AntonyC03S/NASA_RASC-AL/Collection Rover/Sample Handling Subsystem/Sample Handling Arm.SLDASM

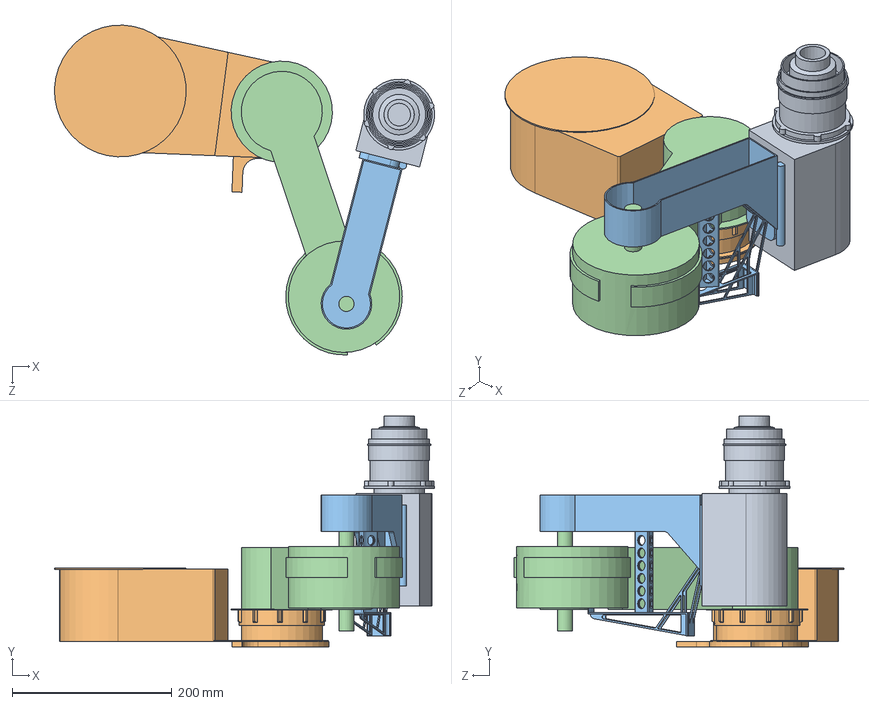
[picture p1: CAD file, 2026-02-23]
Collection Rover/Sample Handling Subsystem/Sample Handling Arm.SLDASM
476.2 x 288.9 x 413.1 mm
Segment 1
Segment 2
Vertical Segment
End Effector
