AntonyC03S/NASA_RASC-AL/Storage Rover/Arms/Arms.SLDASM

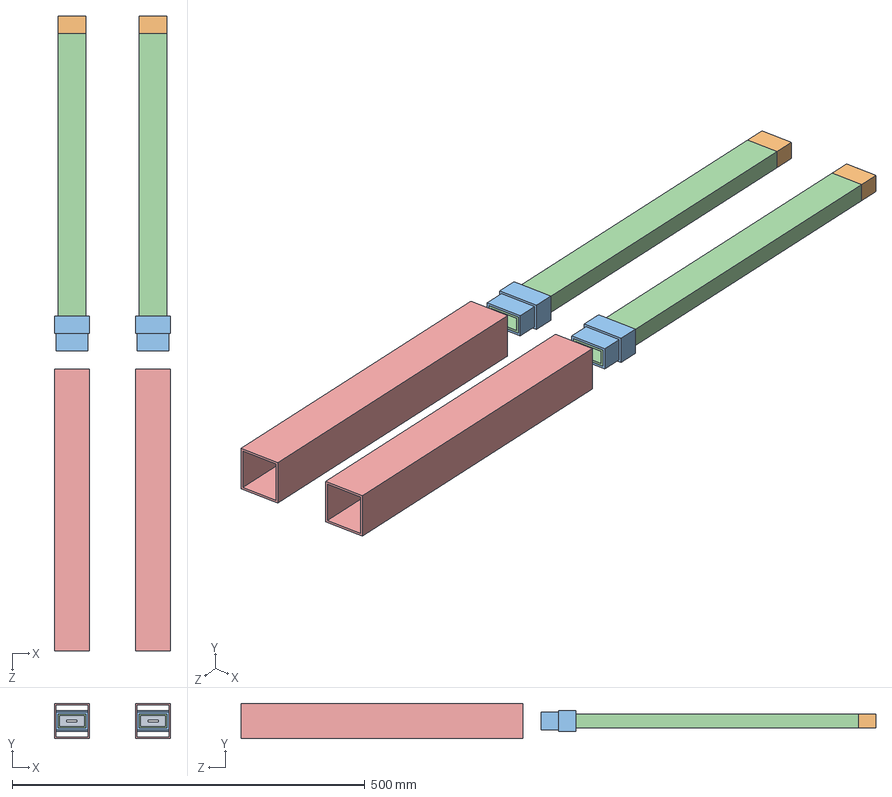
[picture p2: CAD file, 2026-02-23]
Storage Rover/Arms/Arms.SLDASM
165.0 x 50.0 x 900.0 mm
1st Arm x 2
2nd Arm x 2
1st Top Bearing x 2
2nd Top Bearing x 2
3rd Top Bearing x 2
