AntonyC03S/NASA_RASC-AL/TransferMechansimDemo/TransferMechanism.SLDASM

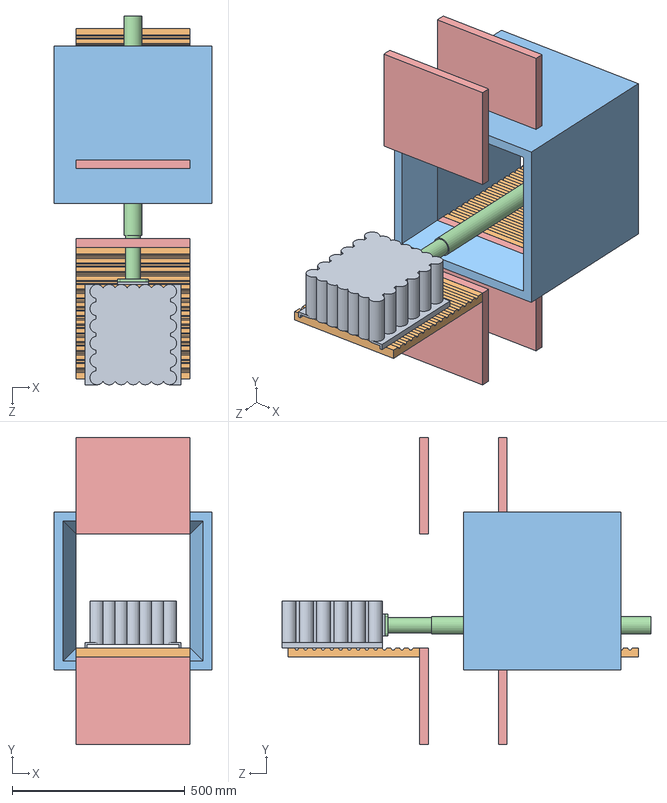
[picture p3: CAD file, 2026-02-23]
TransferMechansimDemo/TransferMechanism.SLDASM
457.2 x 889.3 x 1068.2 mm
Door x 4
LinearActuator
ReceivingEnd
Tray Flooring x 2
BottomloadedTray
