AntonyC03S/NASA_RASC-AL/Storage Rover/StorageRoverAssem.SLDASM

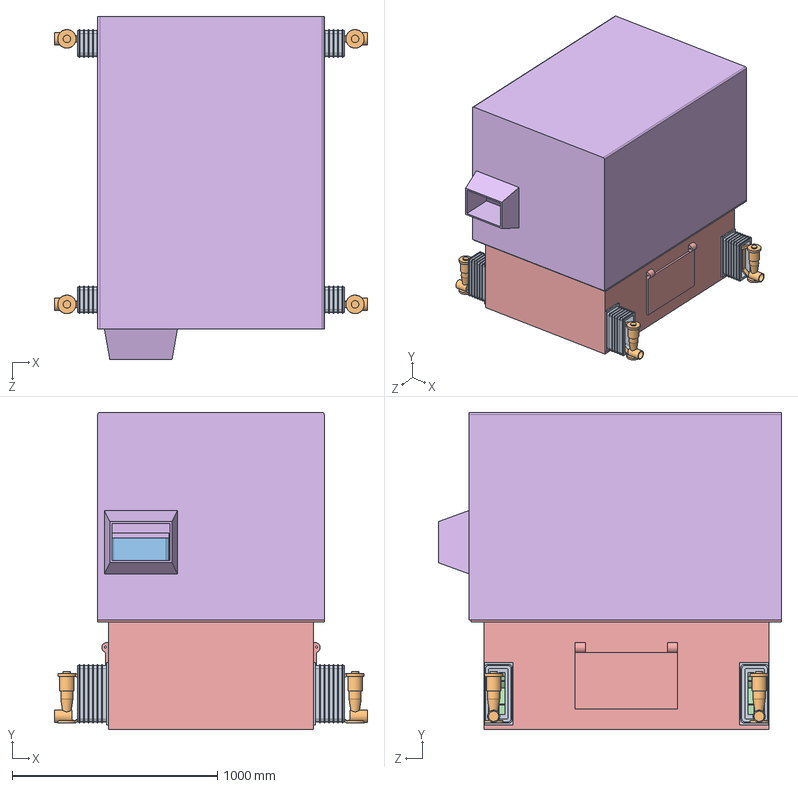
[picture p4: CAD file, 2026-02-05]
Storage Rover/StorageRoverAssem.SLDASM
1526.7 x 1547.0 x 1675.0 mm
StorageRoverBody
ElectronicBlackBox
MMRTG
SampleTray x 18
WheelConnection x 4
SuspensionSleeve x 4
