AntonyC03S/NASA_RASC-AL/Storage Rover/Storage Subsystem/BottomloadedTray.SLDPRT

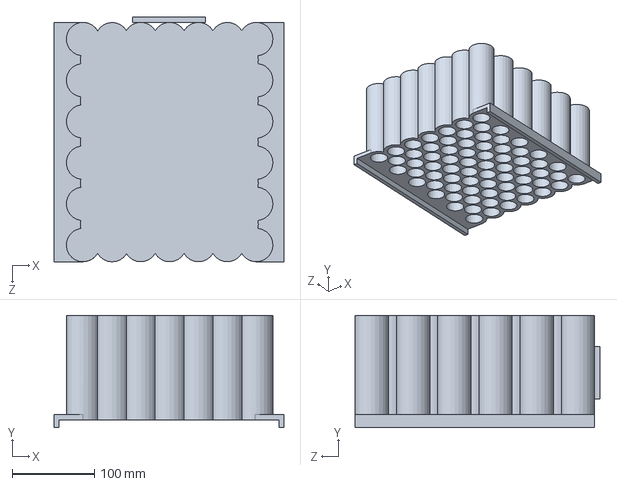
[picture p5: CAD file, 2026-02-10]
Storage Rover/Storage Subsystem/BottomloadedTray.SLDPRT
279.4 x 136.5 x 297.3 mm
