AntonyC03S/NASA_RASC-AL/Storage Rover/StorageRoverBody.SLDPRT

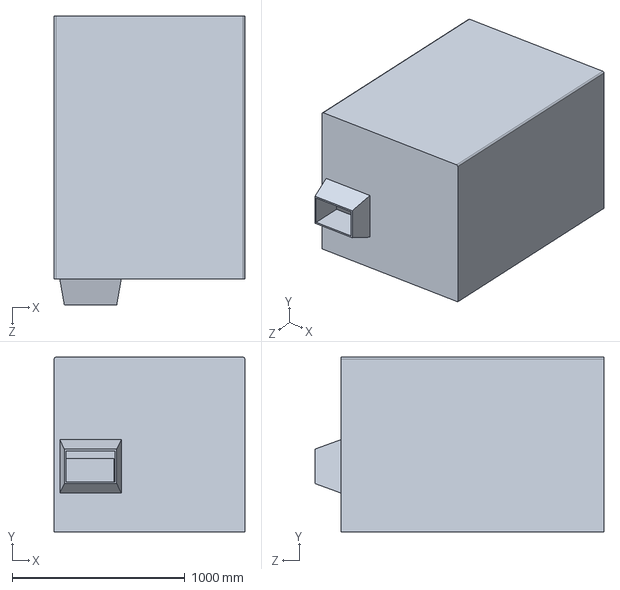
[picture p6: CAD file, 2026-02-23]
Storage Rover/StorageRoverBody.SLDPRT
1105.0 x 1012.5 x 1675.0 mm
