AntonyC03S/NASA_RASC-AL/VP Collection Rover/Stage Telescopic clamp.SLDPRT

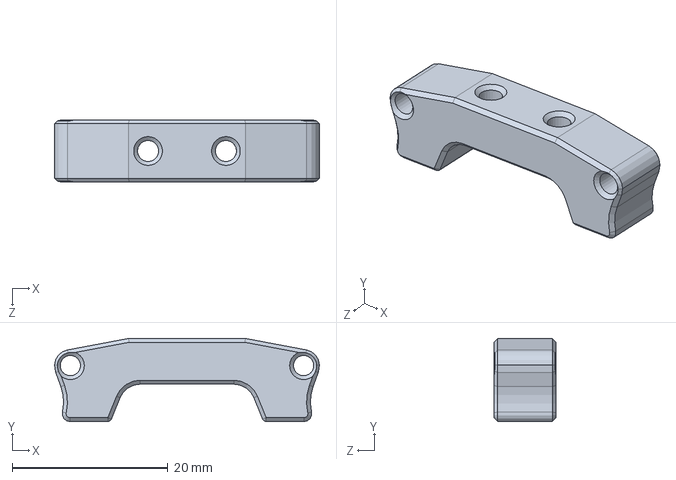
[picture p7: CAD file, 2026-05-27]
VP Collection Rover/Stage Telescopic clamp.SLDPRT
34.0 x 10.7 x 8.00 mm
