AntonyC03S/NASA_RASC-AL/Collection Rover/Drill Subsystem/DrillArm.SLDPRT

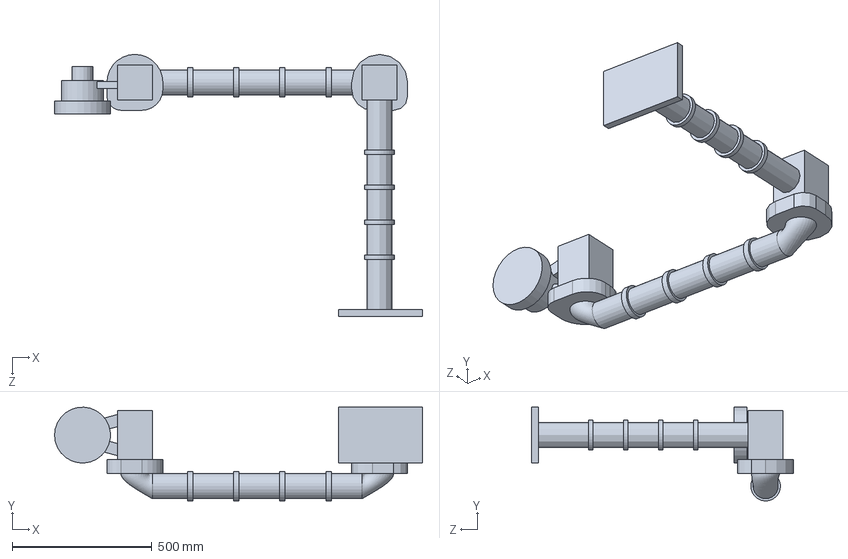
[picture p8: CAD file, 2026-02-10]
Collection Rover/Drill Subsystem/DrillArm.SLDPRT
1315.7 x 335.2 x 937.5 mm
