AntonyC03S/NASA_RASC-AL/Collection Rover/Rover body.SLDPRT

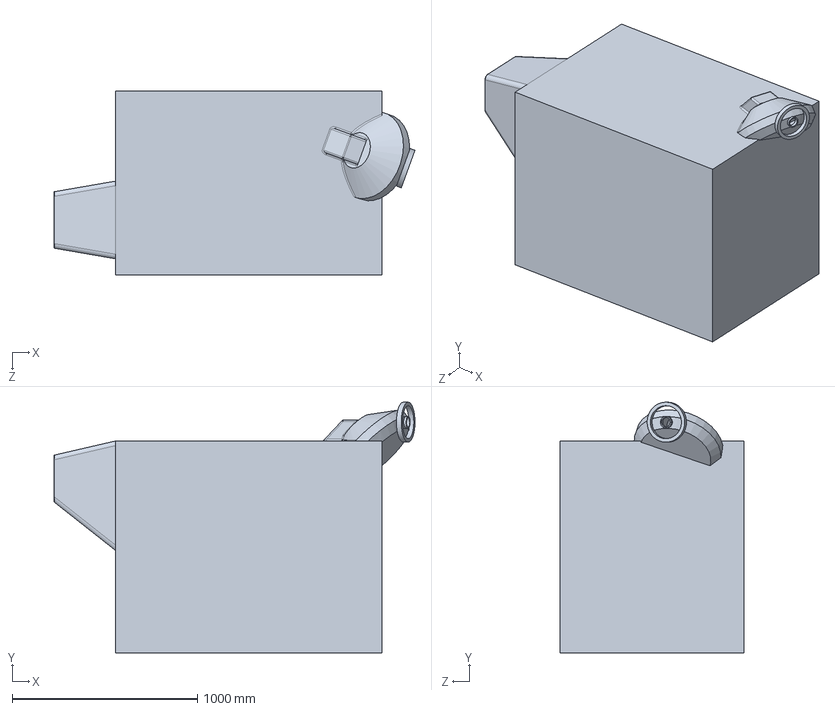
[picture p9: CAD file, 2026-02-23]
Collection Rover/Rover body.SLDPRT
1947.9 x 1352.6 x 990.6 mm
