AntonyC03S/NASA_RASC-AL/Collection Rover/Sample Handling Subsystem/Vertical Segment.SLDPRT

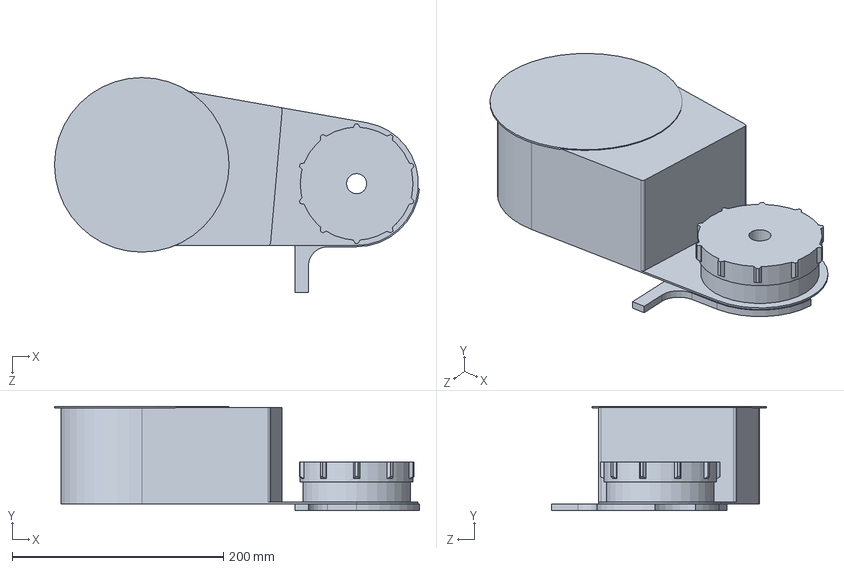
[picture p10: CAD file, 2026-02-10]
Collection Rover/Sample Handling Subsystem/Vertical Segment.SLDPRT
345.2 x 98.4 x 203.2 mm
