AntonyC03S/NASA_RASC-AL/Storage Rover/Arms/3rd Top Bearing.SLDPRT

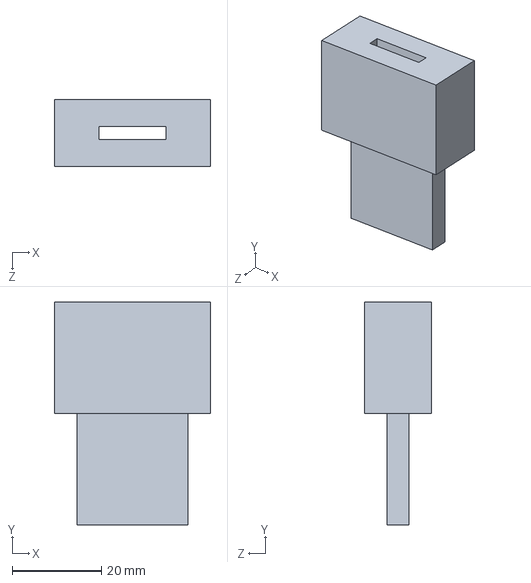
[picture p11: CAD file, 2026-02-23]
Storage Rover/Arms/3rd Top Bearing.SLDPRT
35.0 x 50.0 x 15.0 mm
