AntonyC03S/NASA_RASC-AL/Storage Rover/Elevator/MirrorCage.SLDPRT

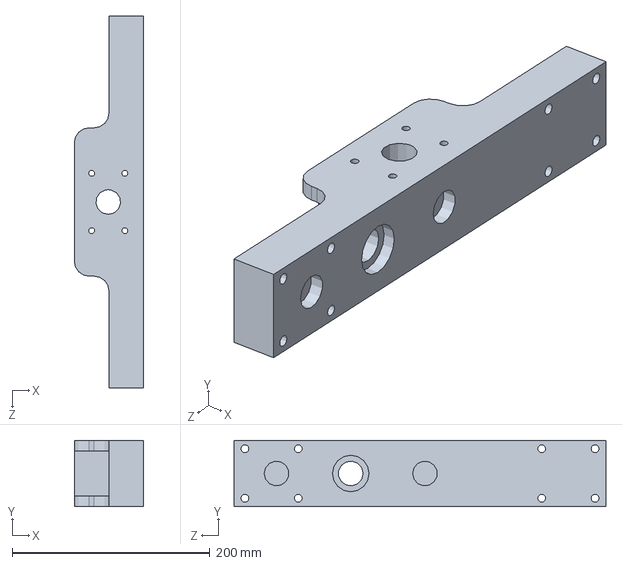
[picture p12: CAD file, 2026-02-05]
Storage Rover/Elevator/MirrorCage.SLDPRT
70.0 x 67.0 x 376.0 mm
