AntonyC03S/NASA_RASC-AL/Storage Rover/Storage Subsystem/SampleTray.SLDPRT

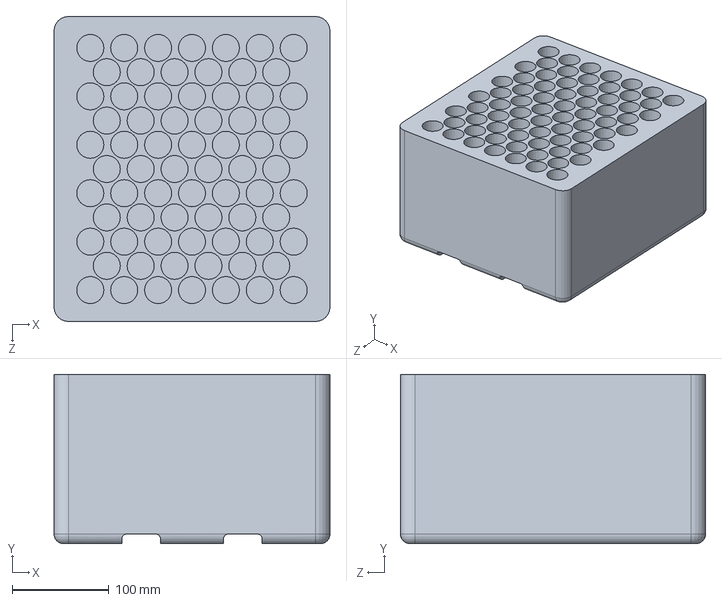
[picture p13: CAD file, 2026-01-30]
Storage Rover/Storage Subsystem/SampleTray.SLDPRT
285.0 x 175.0 x 315.0 mm
