AntonyC03S/NASA_RASC-AL/Storage Rover/ThermalInsulation.SLDPRT

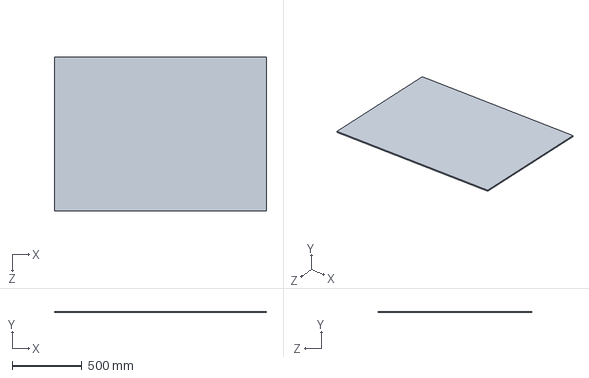
[picture p14: CAD file, 2026-02-10]
Storage Rover/ThermalInsulation.SLDPRT
1525.0 x 10.0 x 1105.0 mm
