AntonyC03S/NASA_RASC-AL/TransferMechansimDemo/LinearActuator.SLDPRT

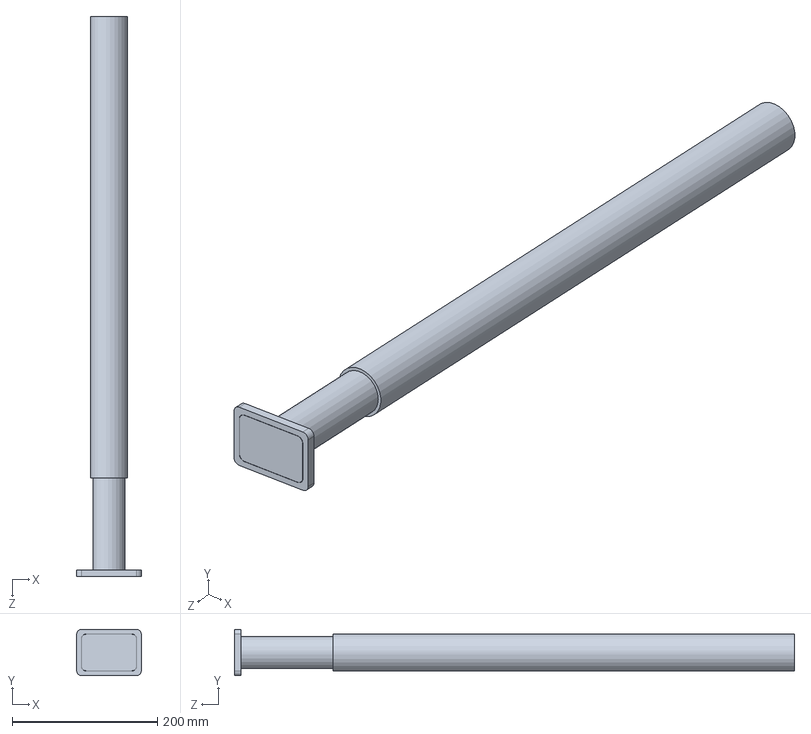
[picture p15: CAD file, 2026-02-23]
TransferMechansimDemo/LinearActuator.SLDPRT
88.9 x 63.5 x 770.9 mm
