AntonyC03S/NASA_RASC-AL/Collection Rover/Drill Subsystem/Drill Head.SLDPRT

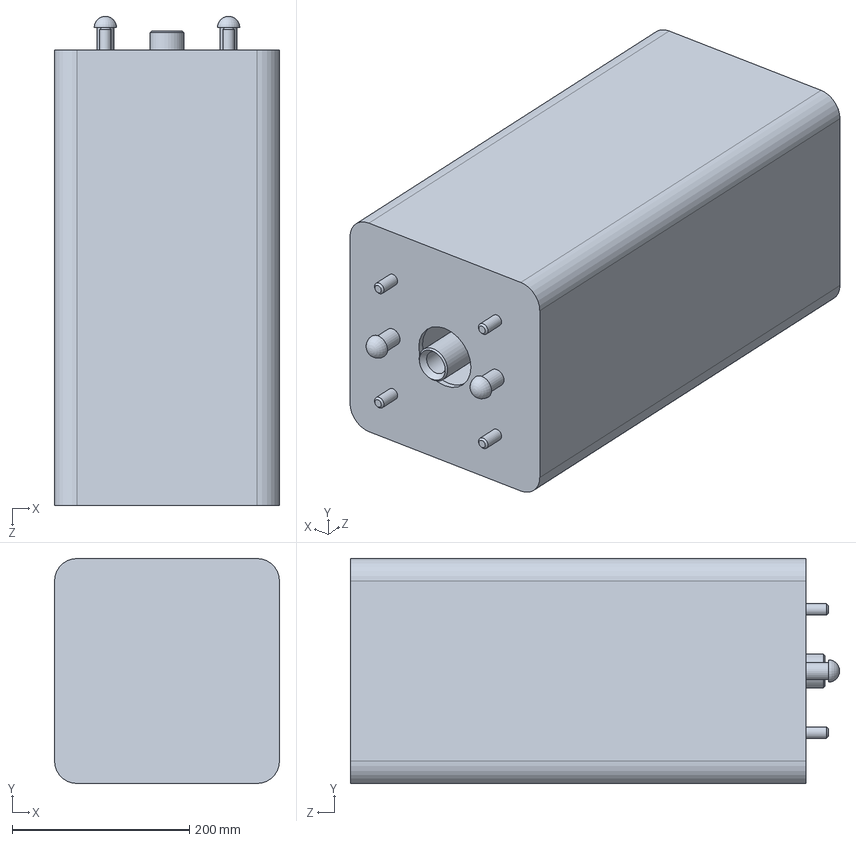
[picture p16: CAD file, 2026-02-10]
Collection Rover/Drill Subsystem/Drill Head.SLDPRT
254.0 x 254.0 x 552.5 mm
