AntonyC03S/NASA_RASC-AL/Collection Rover/MMRTG.SLDPRT

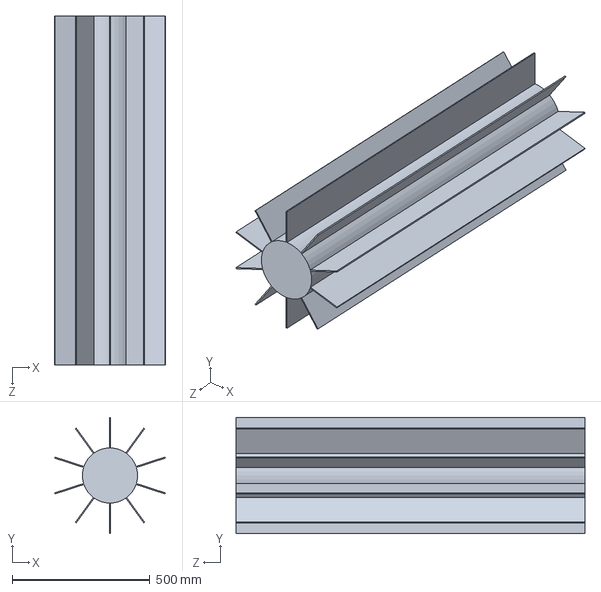
[picture p17: CAD file, 2026-02-10]
Collection Rover/MMRTG.SLDPRT
402.6 x 422.0 x 1265.0 mm
