AntonyC03S/NASA_RASC-AL/Collection Rover/Sample Handling Subsystem/End Effector.SLDPRT

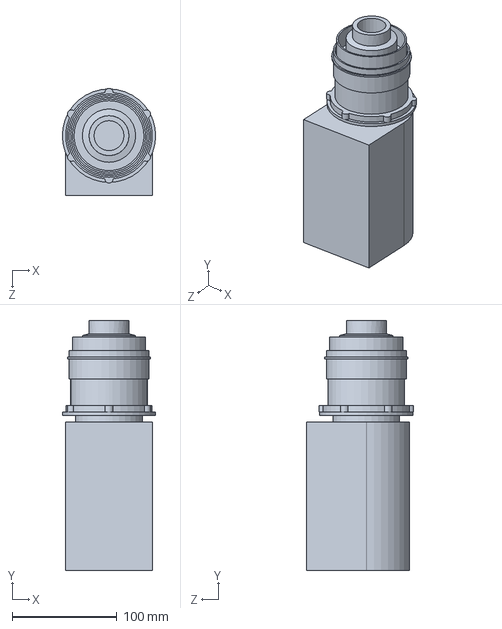
[picture p18: CAD file, 2026-02-10]
Collection Rover/Sample Handling Subsystem/End Effector.SLDPRT
88.9 x 238.1 x 102.2 mm
