AntonyC03S/NASA_RASC-AL/Storage Rover/Arms/1st Top Bearing.SLDPRT

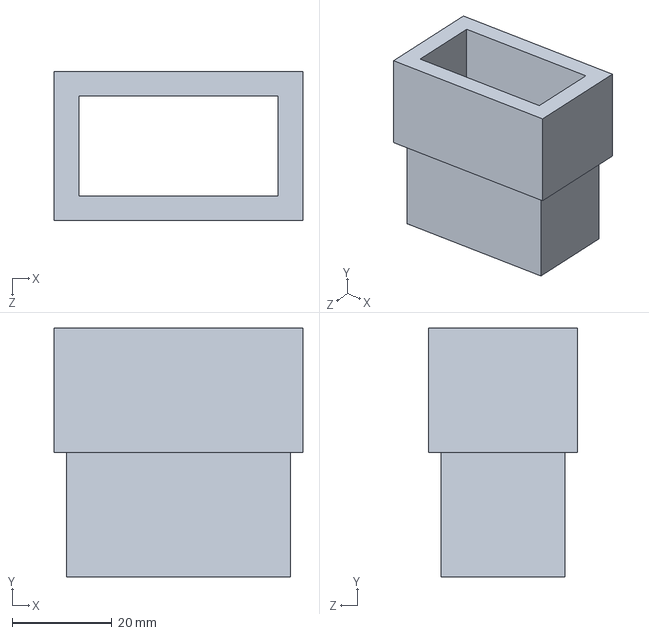
[picture p19: CAD file, 2026-02-23]
Storage Rover/Arms/1st Top Bearing.SLDPRT
50.0 x 50.0 x 30.0 mm
