AntonyC03S/NASA_RASC-AL/Storage Rover/ElectronicBlackBox.SLDPRT

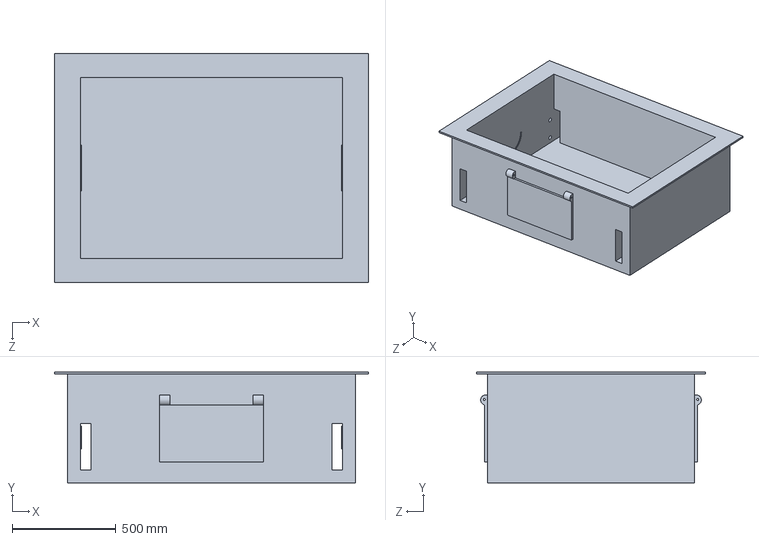
[picture p20: CAD file, 2026-02-10]
Storage Rover/ElectronicBlackBox.SLDPRT
1515.0 x 534.5 x 1105.0 mm
