AntonyC03S/NASA_RASC-AL/Storage Rover/Elevator/Mid_Cage.SLDPRT

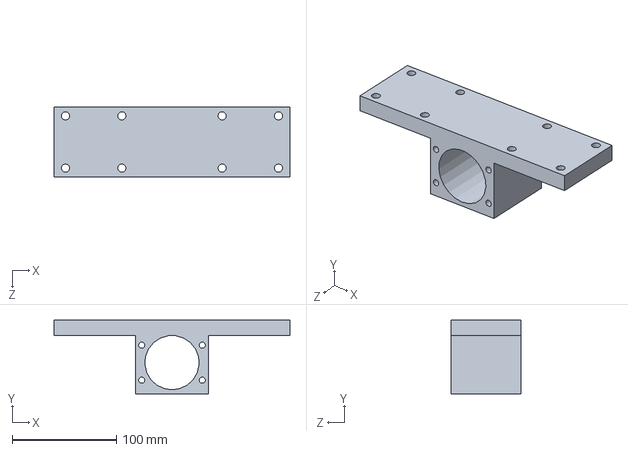
[picture p21: CAD file, 2026-02-02]
Storage Rover/Elevator/Mid_Cage.SLDPRT
226.0 x 70.8 x 67.0 mm
