AntonyC03S/NASA_RASC-AL/Storage Rover/Storage Subsystem/SampleTube.SLDPRT

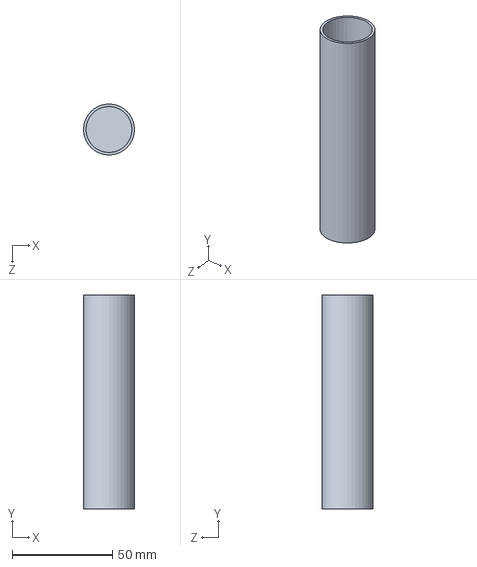
[picture p22: CAD file, 2026-01-29]
Storage Rover/Storage Subsystem/SampleTube.SLDPRT
25.4 x 106.6 x 25.4 mm
