AntonyC03S/NASA_RASC-AL/TransferMechansimDemo/Tray Flooring.SLDPRT

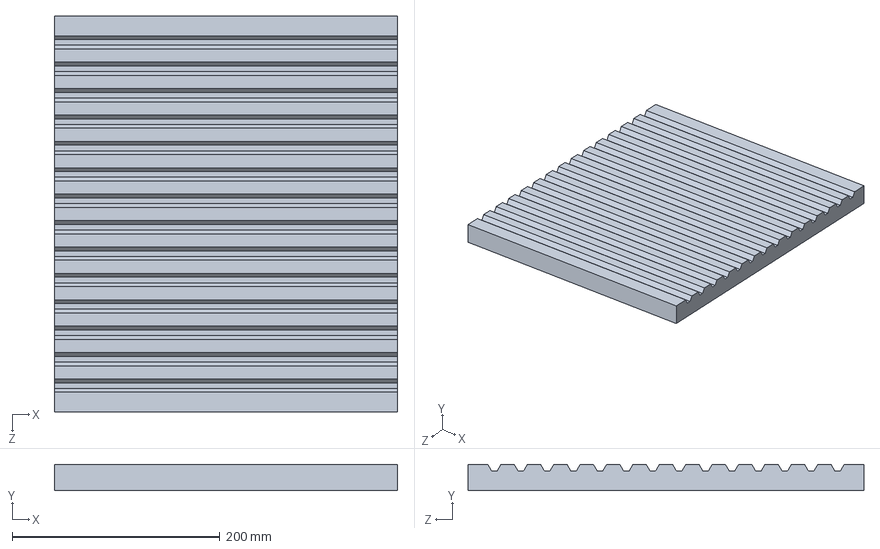
[picture p23: CAD file, 2026-02-23]
TransferMechansimDemo/Tray Flooring.SLDPRT
330.2 x 25.4 x 381.0 mm
