AntonyC03S/NASA_RASC-AL/VP Collection Rover/Stage Telescopic Top back 2.SLDPRT

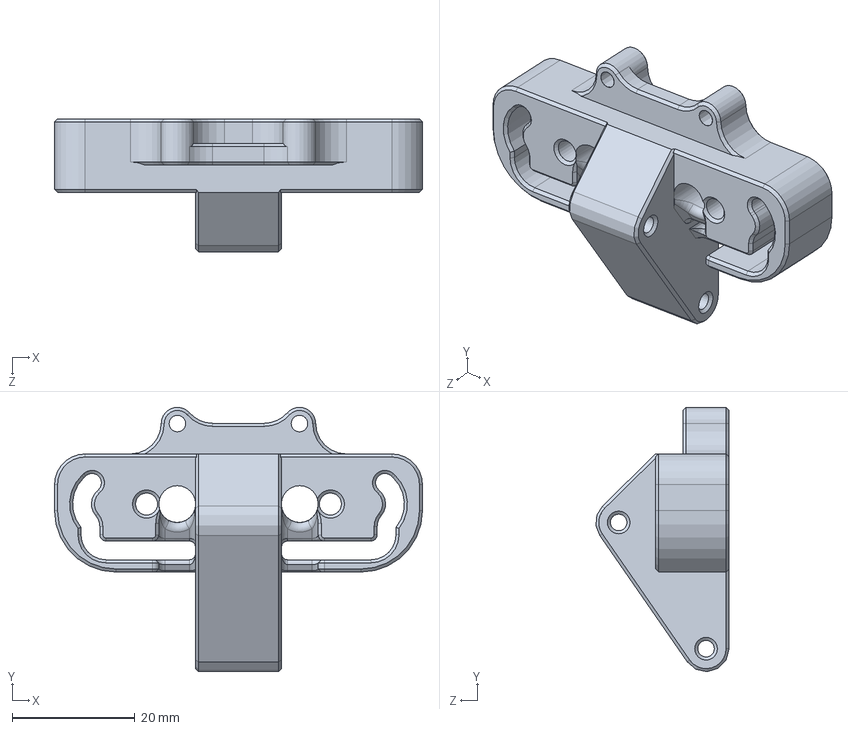
[picture p24: CAD file, 2026-05-27]
VP Collection Rover/Stage Telescopic Top back 2.SLDPRT
60.0 x 43.1 x 21.7 mm
