AntonyC03S/NASA_RASC-AL/Collection Rover/Sample Handling Subsystem/Bit Carousel.SLDPRT

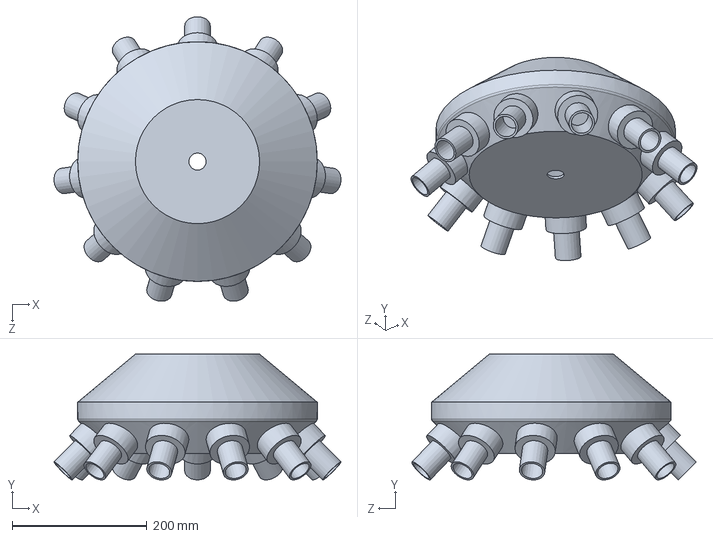
[picture p25: CAD file, 2026-02-10]
Collection Rover/Sample Handling Subsystem/Bit Carousel.SLDPRT
425.9 x 186.8 x 422.2 mm
