AntonyC03S/NASA_RASC-AL/Collection Rover/SuspensionSleeve.SLDPRT

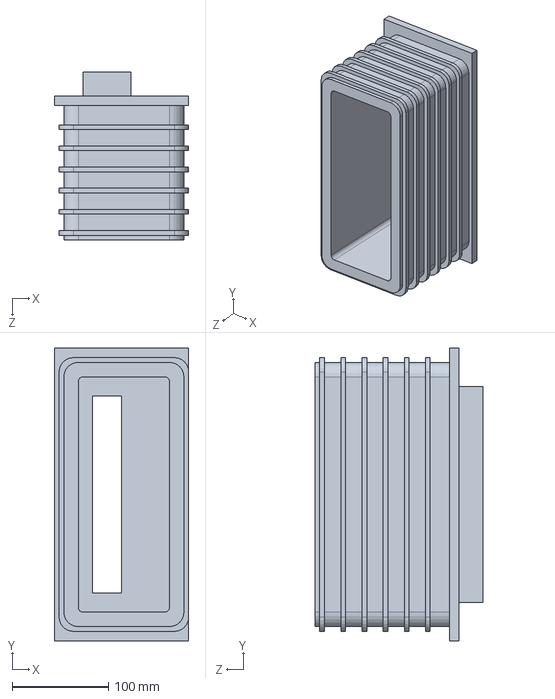
[picture p26: CAD file, 2026-02-10]
Collection Rover/SuspensionSleeve.SLDPRT
140.0 x 305.0 x 175.0 mm
