AntonyC03S/NASA_RASC-AL/Storage Rover/Arms/2nd Arm.SLDPRT

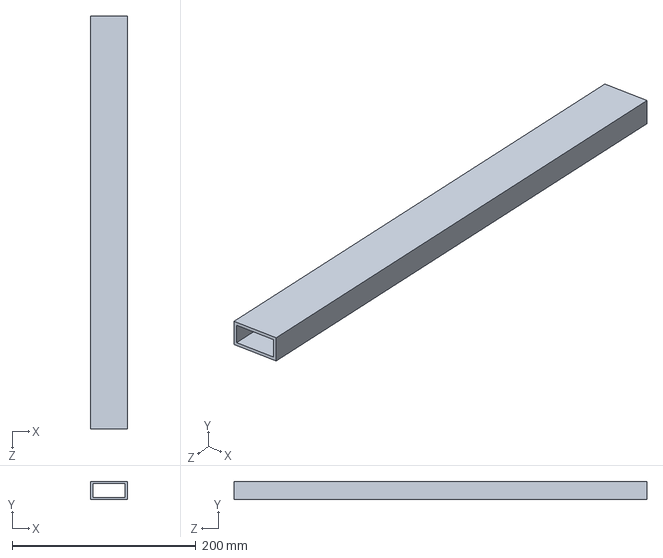
[picture p27: CAD file, 2026-02-23]
Storage Rover/Arms/2nd Arm.SLDPRT
40.0 x 20.0 x 450.0 mm
