AntonyC03S/NASA_RASC-AL/Storage Rover/Elevator/Mid_Rails.SLDPRT

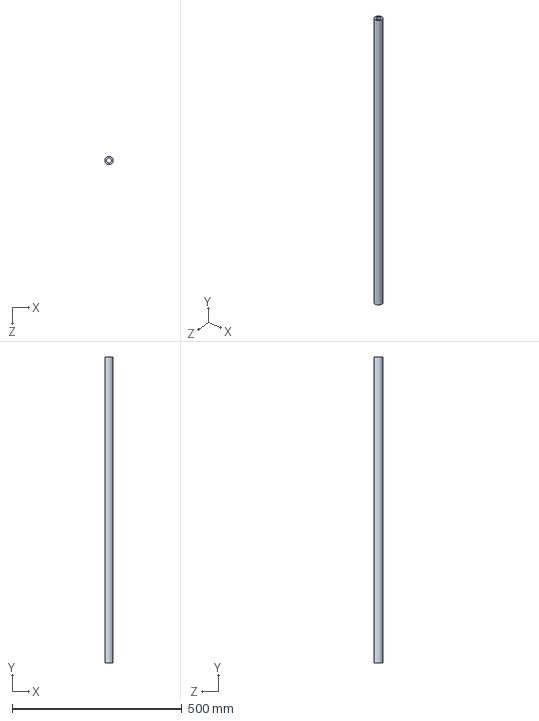
[picture p28: CAD file, 2026-02-02]
Storage Rover/Elevator/Mid_Rails.SLDPRT
24.9 x 900.0 x 25.0 mm
