AntonyC03S/NASA_RASC-AL/Storage Rover/ThermalRadiator.SLDPRT

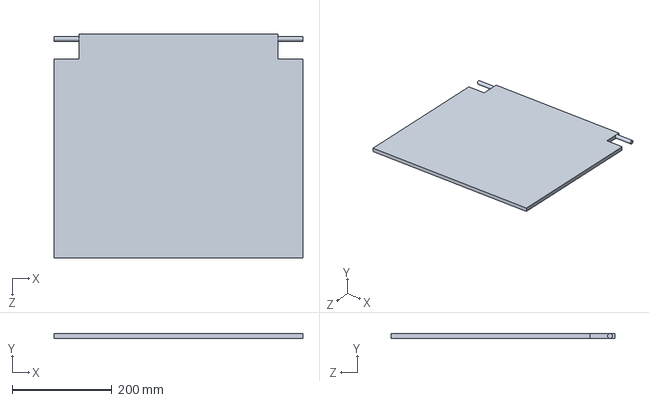
[picture p29: CAD file, 2026-02-10]
Storage Rover/ThermalRadiator.SLDPRT
500.0 x 10.0 x 450.0 mm
