AntonyC03S/NASA_RASC-AL/TransferMechansimDemo/ReceivingEnd.SLDPRT

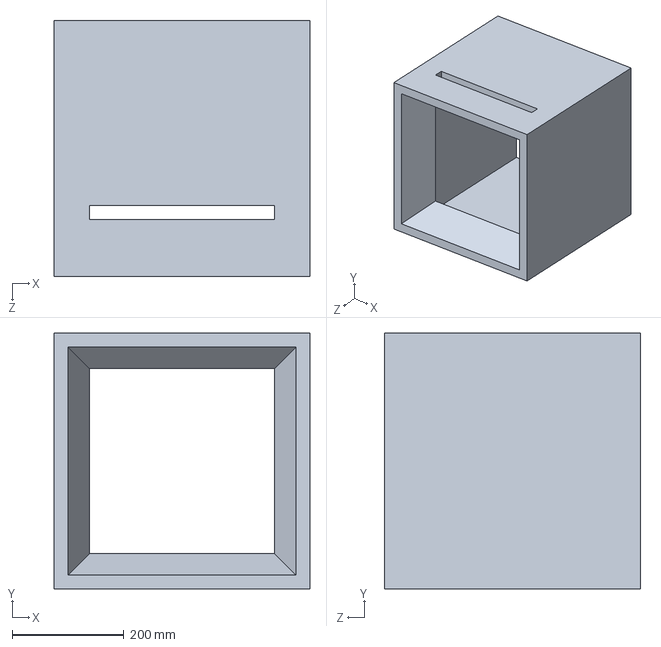
[picture p30: CAD file, 2026-02-23]
TransferMechansimDemo/ReceivingEnd.SLDPRT
457.2 x 457.2 x 457.2 mm
