AntonyC03S/NASA_RASC-AL/VP Collection Rover/Bearing Arm Mount.SLDPRT

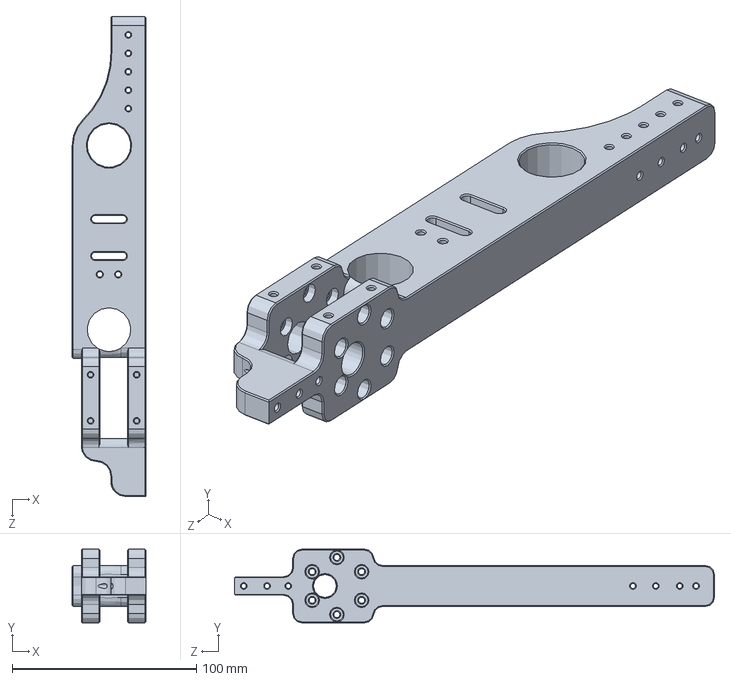
[picture p31: CAD file, 2026-05-27]
VP Collection Rover/Bearing Arm Mount.SLDPRT
40.0 x 40.0 x 260.6 mm
