AntonyC03S/NASA_RASC-AL/Collection Rover/Sample Handling Subsystem/Segment 2.SLDPRT

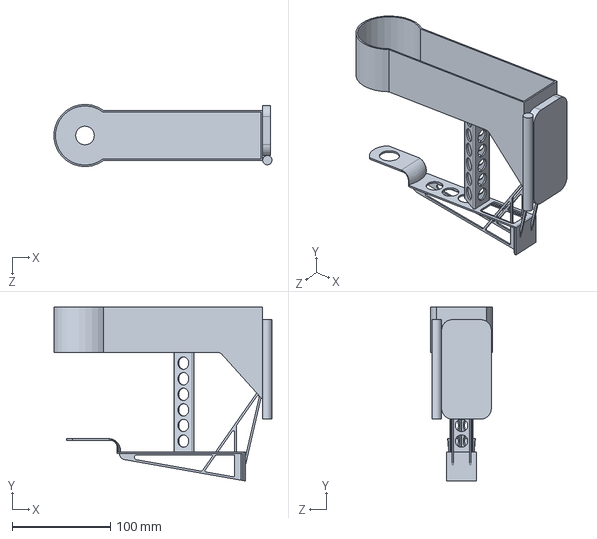
[picture p32: CAD file, 2026-02-09]
Collection Rover/Sample Handling Subsystem/Segment 2.SLDPRT
222.2 x 177.2 x 63.5 mm
