AntonyC03S/NASA_RASC-AL/Collection Rover/WheelConnection.SLDPRT

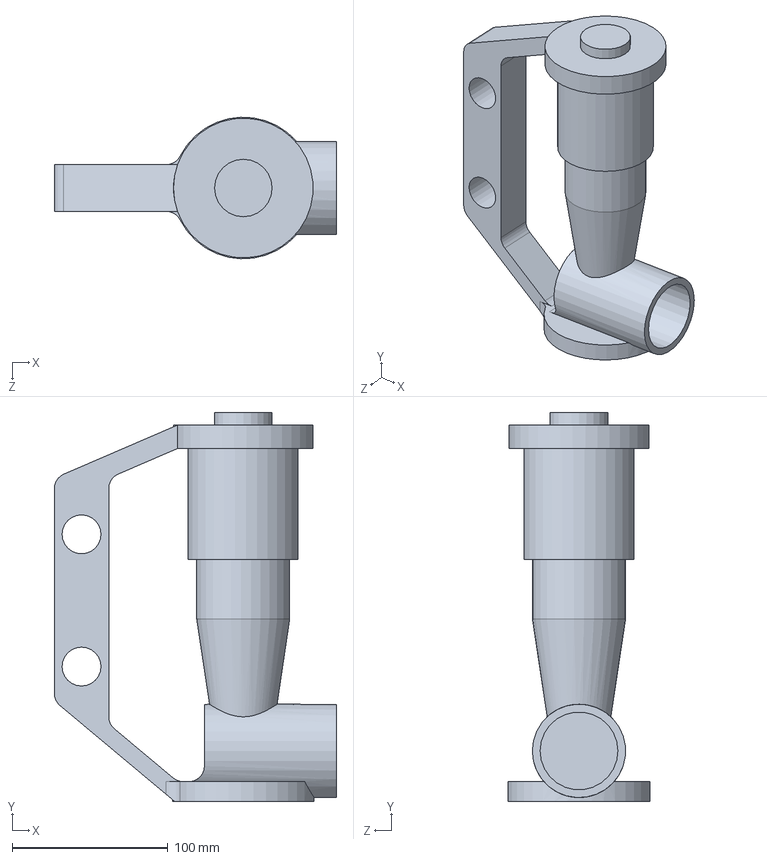
[picture p33: CAD file, 2026-02-10]
Collection Rover/WheelConnection.SLDPRT
181.5 x 250.0 x 91.0 mm
