AntonyC03S/NASA_RASC-AL/Storage Rover/Arms/1st Arm.SLDPRT

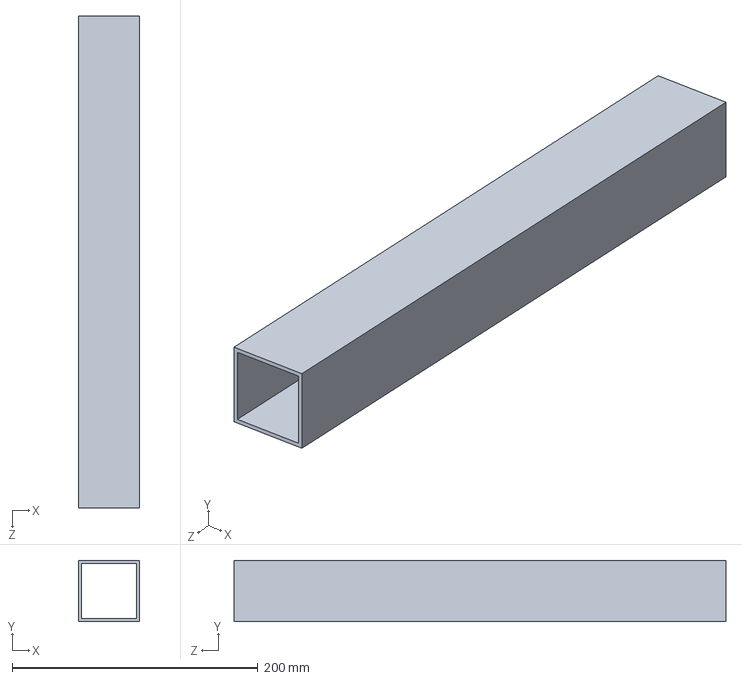
[picture p34: CAD file, 2026-02-23]
Storage Rover/Arms/1st Arm.SLDPRT
50.0 x 50.0 x 400.0 mm
