AntonyC03S/NASA_RASC-AL/Storage Rover/Elevator/Rails.SLDPRT

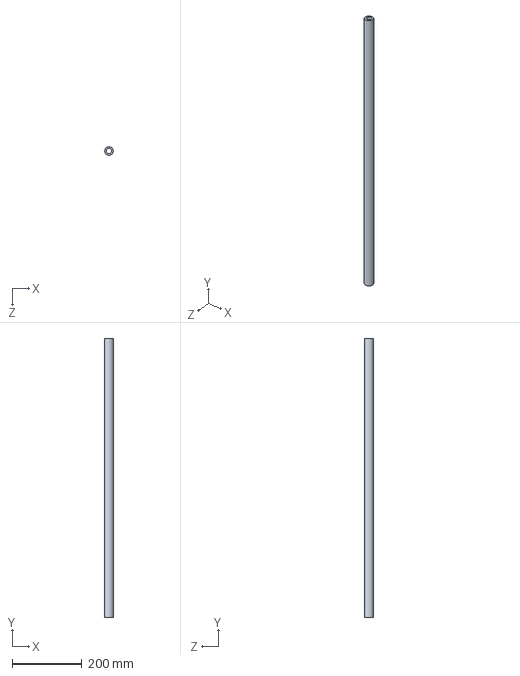
[picture p35: CAD file, 2026-02-02]
Storage Rover/Elevator/Rails.SLDPRT
24.9 x 800.0 x 25.0 mm
