AntonyC03S/NASA_RASC-AL/TransferMechansimDemo/Door.SLDPRT

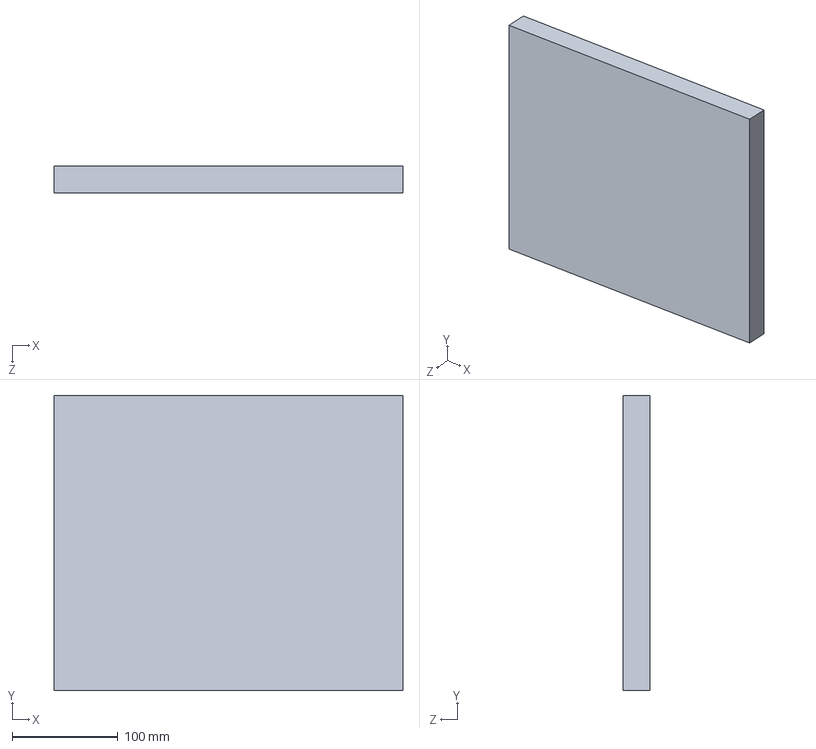
[picture p36: CAD file, 2026-02-23]
TransferMechansimDemo/Door.SLDPRT
330.2 x 279.4 x 25.4 mm
