AntonyC03S/NASA_RASC-AL/VP Collection Rover/String Clamp.SLDPRT

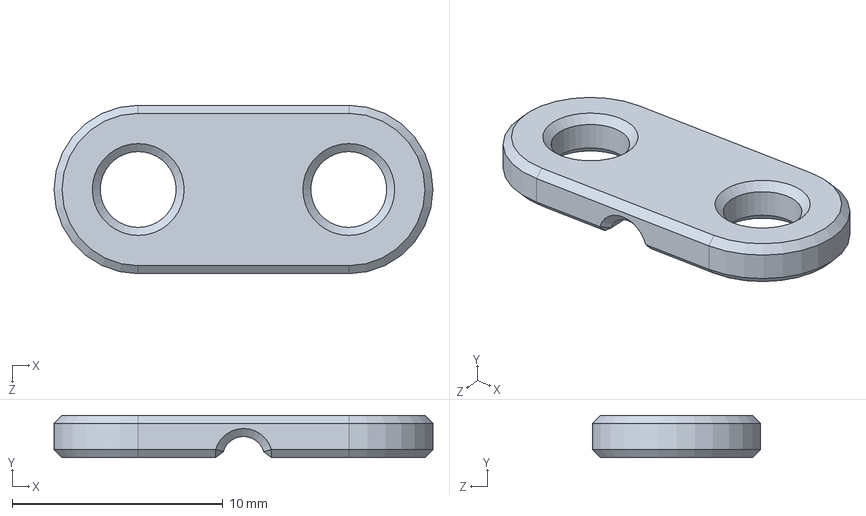
[picture p37: CAD file, 2026-05-27]
VP Collection Rover/String Clamp.SLDPRT
18.0 x 2.00 x 8.00 mm
