AntonyC03S/NASA_RASC-AL/Collection Rover/Sample Handling Subsystem/Segment 1.SLDPRT

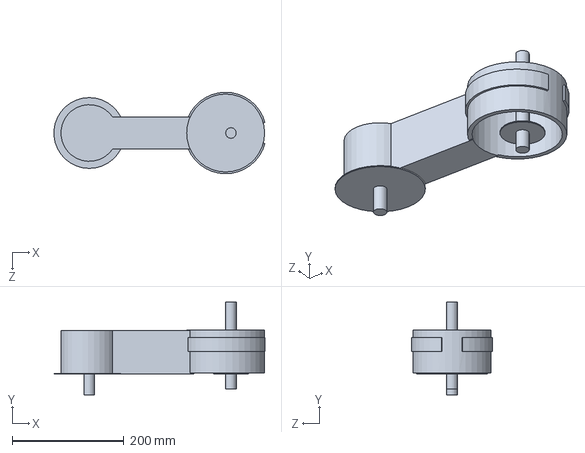
[picture p38: CAD file, 2026-02-05]
Collection Rover/Sample Handling Subsystem/Segment 1.SLDPRT
378.2 x 166.6 x 146.0 mm
