AntonyC03S/NASA_RASC-AL/Storage Rover/Arms/2nd Top Bearing.SLDPRT

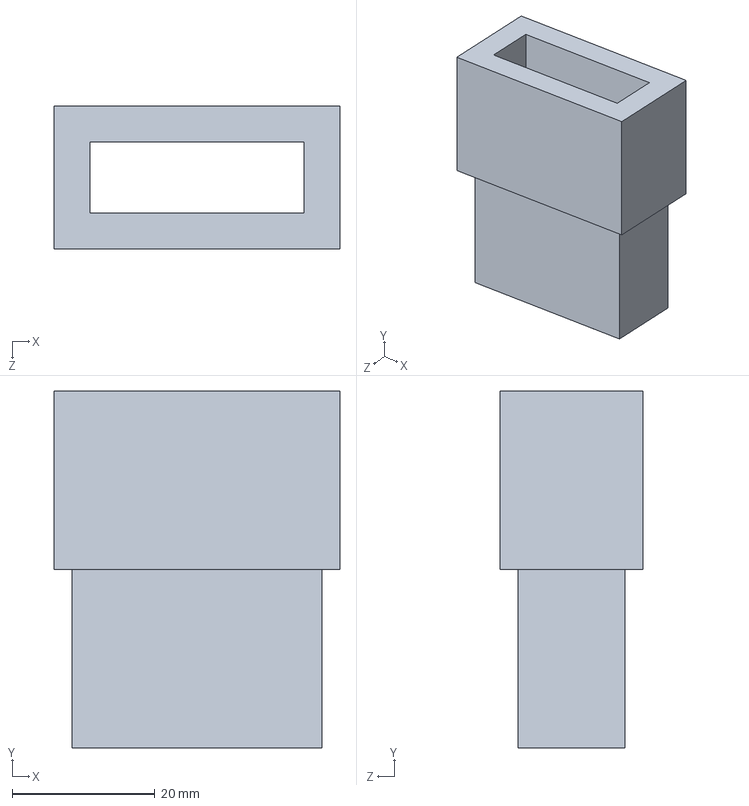
[picture p39: CAD file, 2026-02-23]
Storage Rover/Arms/2nd Top Bearing.SLDPRT
40.0 x 50.0 x 20.0 mm
