AntonyC03S/NASA_RASC-AL/VP Collection Rover/pulley support.SLDPRT

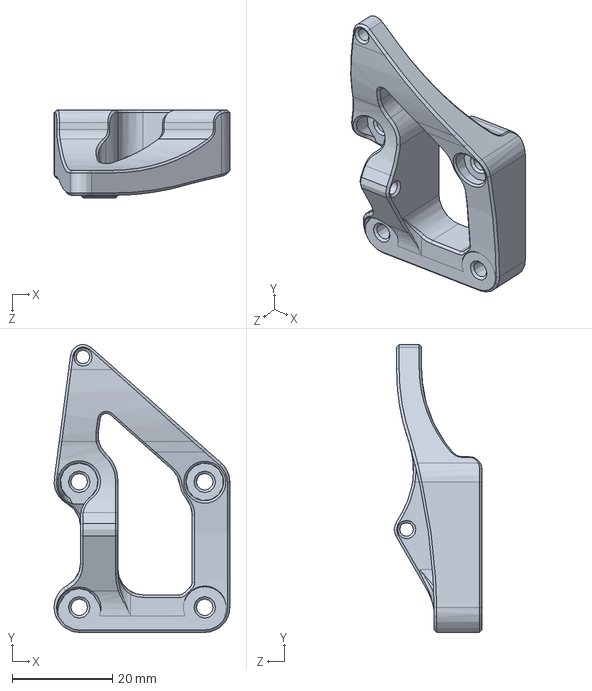
[picture p40: CAD file, 2026-05-27]
VP Collection Rover/pulley support.SLDPRT
35.0 x 57.4 x 17.5 mm
