AntonyC03S/NASA_RASC-AL/Collection Rover/Sample Handling Subsystem/Bearing.SLDPRT

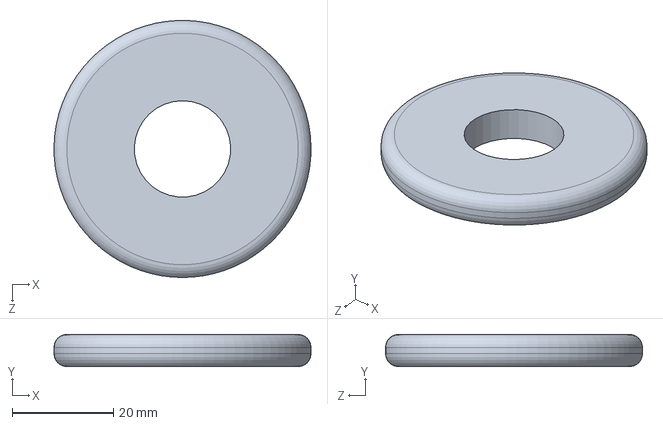
[picture p41: CAD file, 2026-02-02]
Collection Rover/Sample Handling Subsystem/Bearing.SLDPRT
50.8 x 6.35 x 50.8 mm
