AntonyC03S/NASA_RASC-AL/Storage Rover/Arms/1st Bot Bearing.SLDPRT

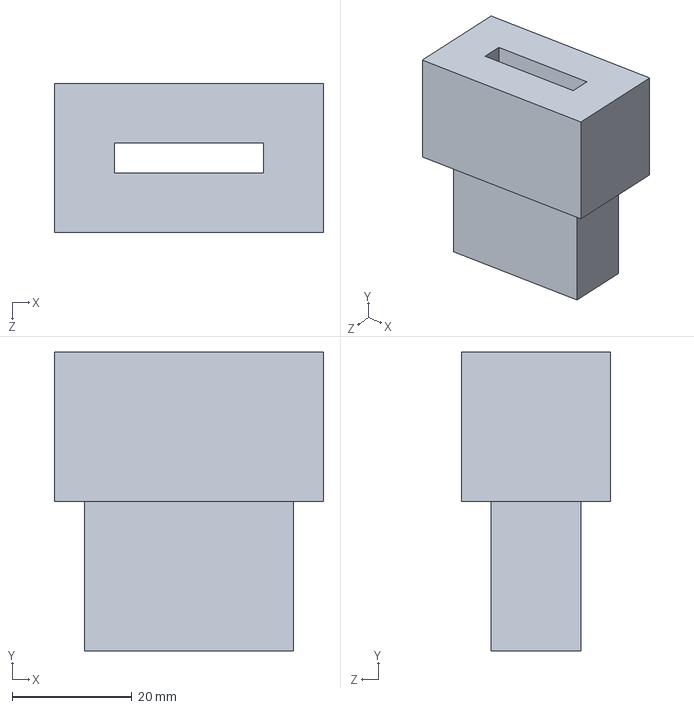
[picture p42: CAD file, 2026-02-23]
Storage Rover/Arms/1st Bot Bearing.SLDPRT
45.0 x 50.0 x 25.0 mm
