AntonyC03S/NASA_RASC-AL/Storage Rover/GarageDoor.SLDPRT

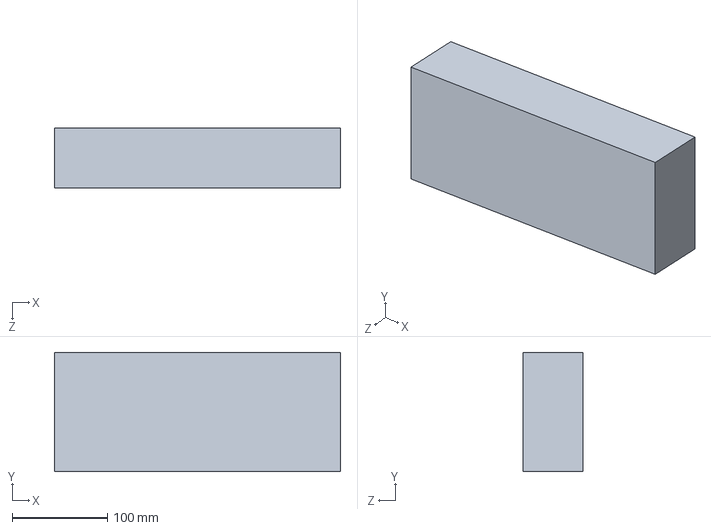
[picture p43: CAD file, 2026-02-04]
Storage Rover/GarageDoor.SLDPRT
300.0 x 125.0 x 62.5 mm
