AntonyC03S/NASA_RASC-AL/TransferMechansimDemo/Giver.SLDPRT

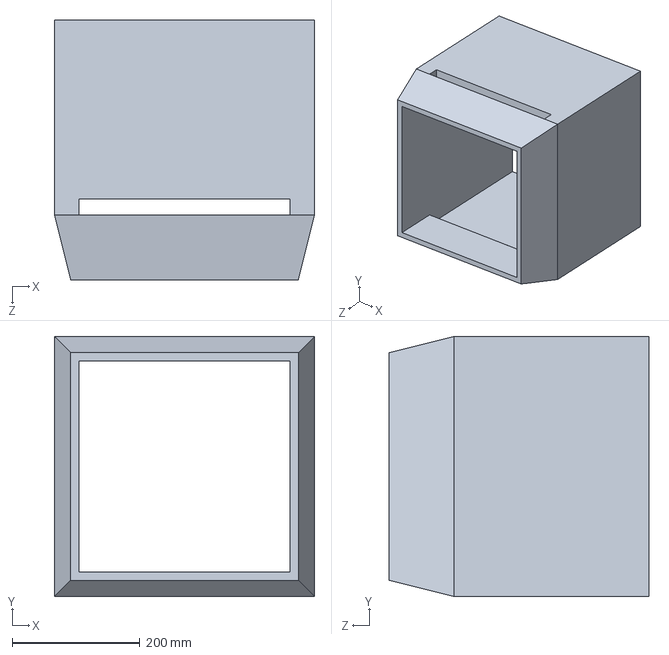
[picture p44: CAD file, 2026-02-23]
TransferMechansimDemo/Giver.SLDPRT
406.4 x 406.4 x 406.4 mm
