AntonyC03S/NASA_RASC-AL/VP Collection Rover/Bearing Mount.SLDPRT

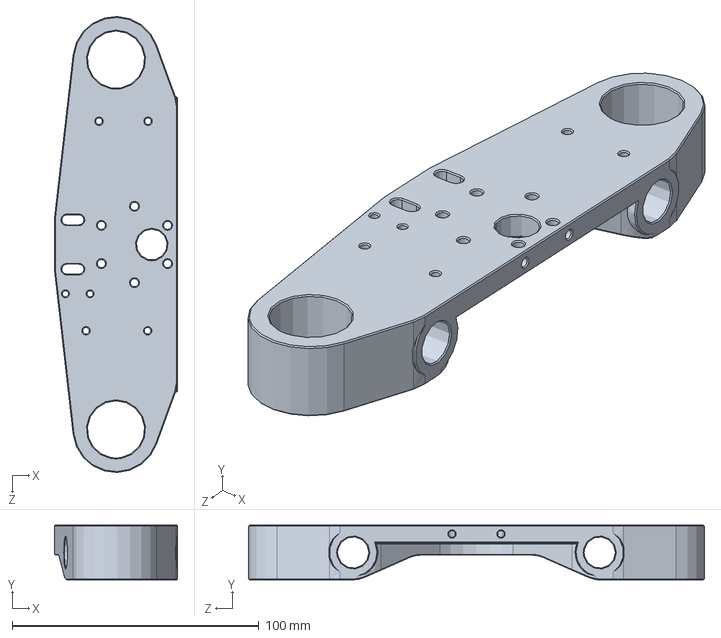
[picture p45: CAD file, 2026-05-27]
VP Collection Rover/Bearing Mount.SLDPRT
50.0 x 22.2 x 185.0 mm
