AntonyC03S/NASA_RASC-AL/Storage Rover/Arms/3rd Arm.SLDPRT

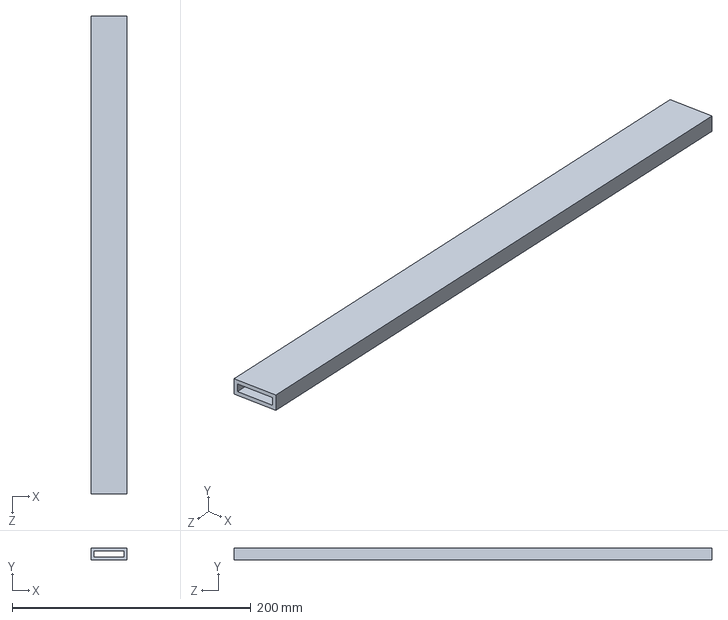
[picture p46: CAD file, 2026-02-23]
Storage Rover/Arms/3rd Arm.SLDPRT
30.0 x 10.0 x 400.0 mm
