AntonyC03S/NASA_RASC-AL/Storage Rover/ControlArm.SLDPRT

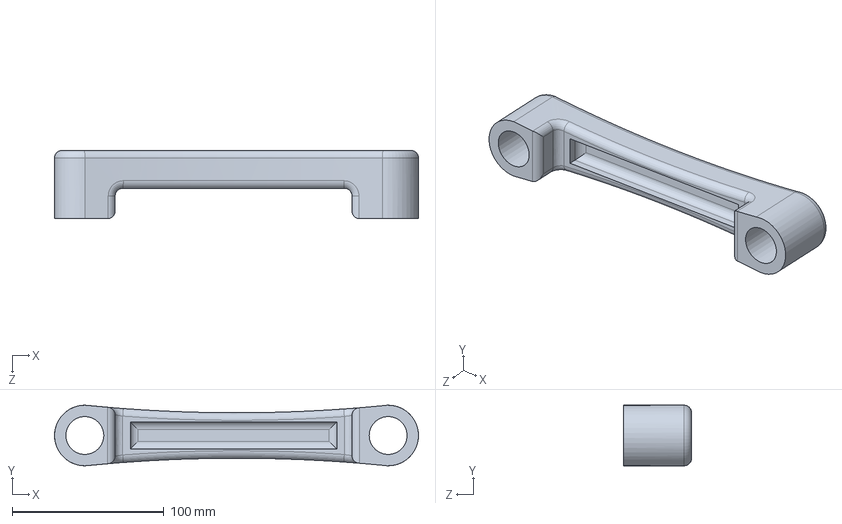
[picture p47: CAD file, 2026-02-04]
Storage Rover/ControlArm.SLDPRT
240.0 x 40.0 x 45.0 mm
