AntonyC03S/NASA_RASC-AL/VP Collection Rover/Stage Telescopic mid back.SLDPRT

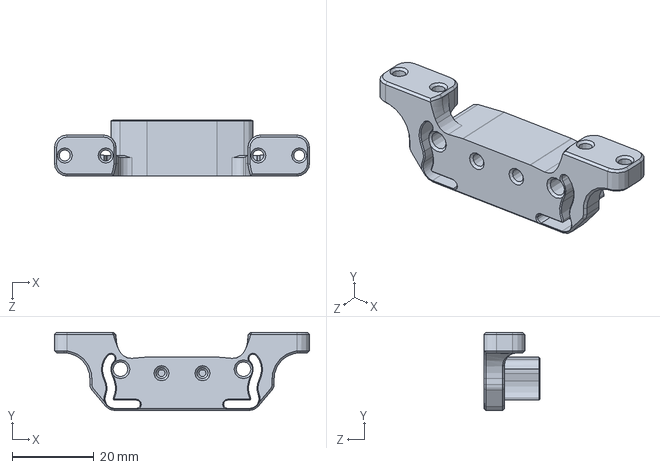
[picture p48: CAD file, 2026-05-27]
VP Collection Rover/Stage Telescopic mid back.SLDPRT
62.2 x 19.1 x 13.7 mm
