AntonyC03S/NASA_RASC-AL/VP Collection Rover/MirrorBearing Mount.SLDPRT

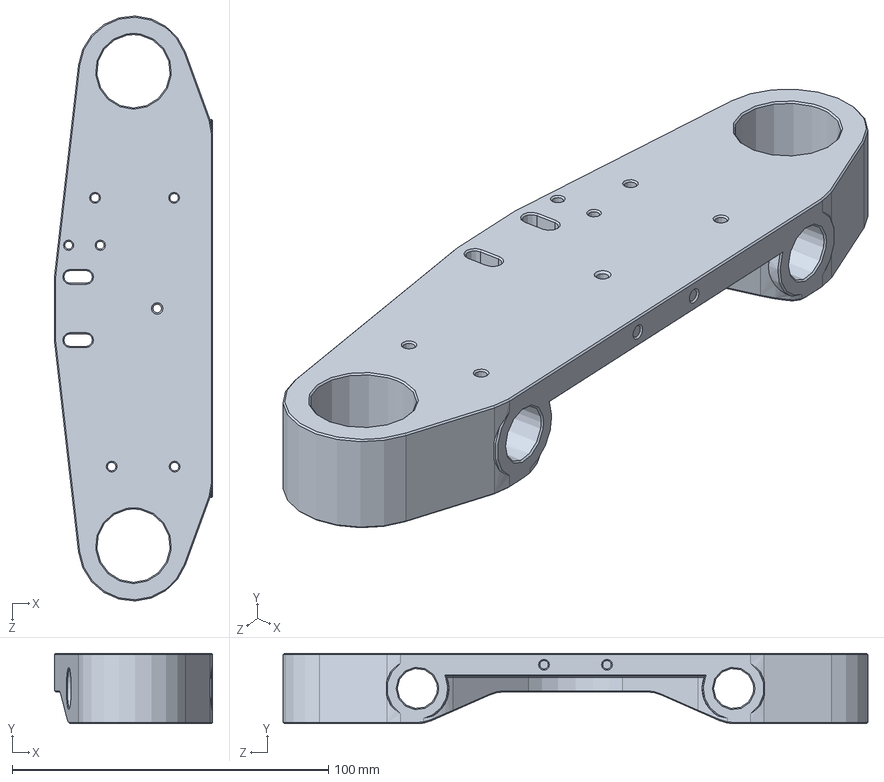
[picture p49: CAD file, 2026-05-27]
VP Collection Rover/MirrorBearing Mount.SLDPRT
50.0 x 22.2 x 185.0 mm
