AntonyC03S/NASA_RASC-AL/Storage Rover/E67 ECU.SLDPRT

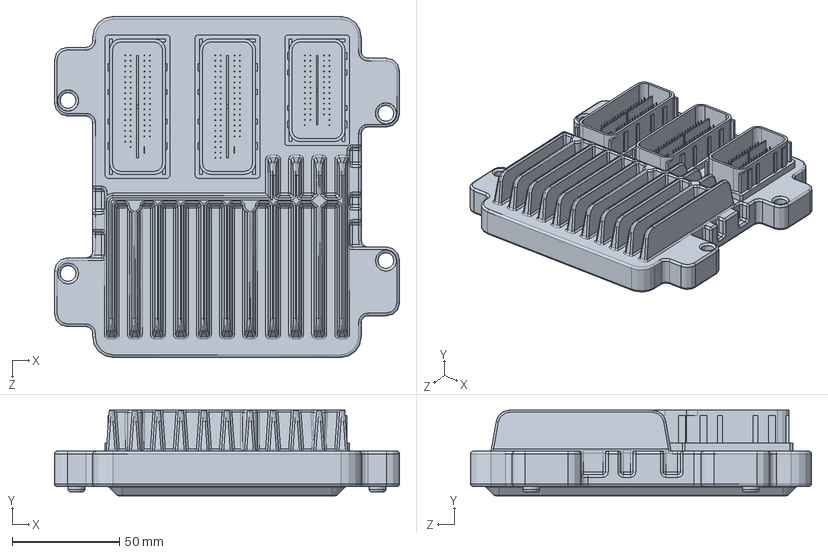
[picture p50: CAD file, 2026-02-02]
Storage Rover/E67 ECU.SLDPRT
160.7 x 39.9 x 158.8 mm
