AntonyC03S/NASA_RASC-AL/VP Collection Rover/lever.SLDPRT

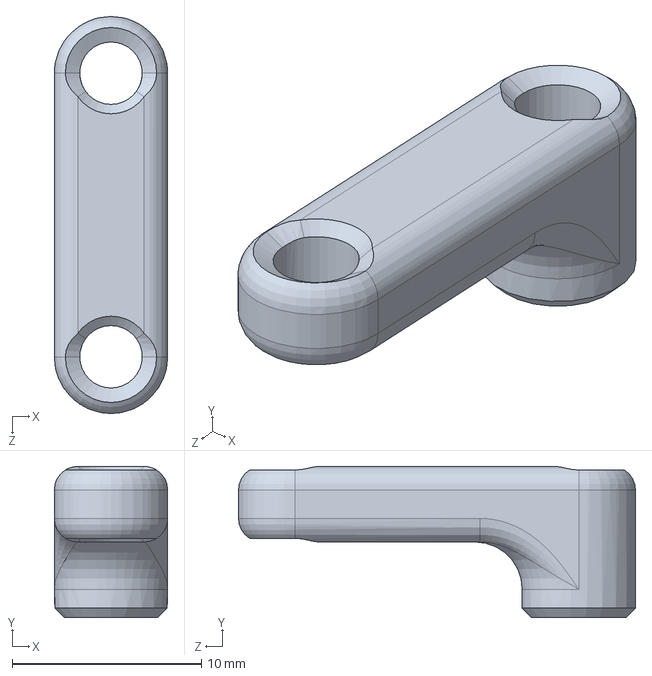
[picture p51: CAD file, 2026-05-27]
VP Collection Rover/lever.SLDPRT
6.00 x 8.00 x 21.0 mm
