AntonyC03S/NASA_RASC-AL/Storage Rover/Wheel.sldprt

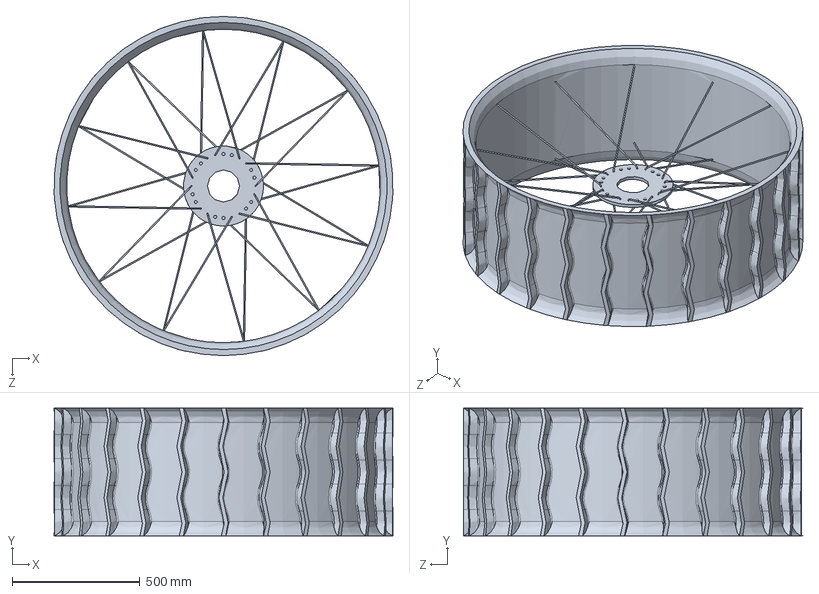
[picture p52: CAD file, 2026-01-30]
Storage Rover/Wheel.sldprt
1324.7 x 500.0 x 1325.0 mm
