AntonyC03S/NASA_RASC-AL/VP Collection Rover/Spool v3.1.SLDPRT

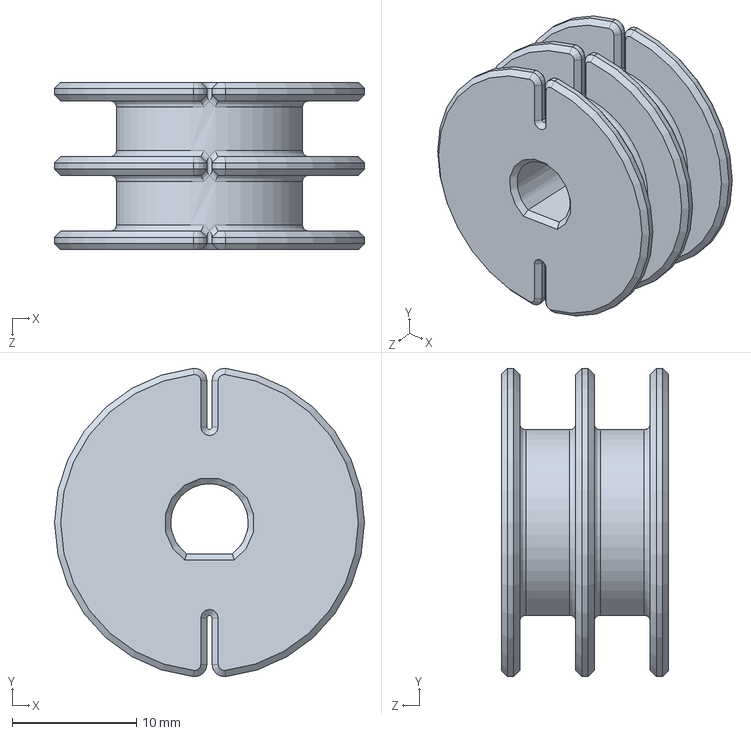
[picture p53: CAD file, 2026-05-27]
VP Collection Rover/Spool v3.1.SLDPRT
25.0 x 24.9 x 13.5 mm
