AntonyC03S/NASA_RASC-AL/VP Collection Rover/spacer.SLDPRT

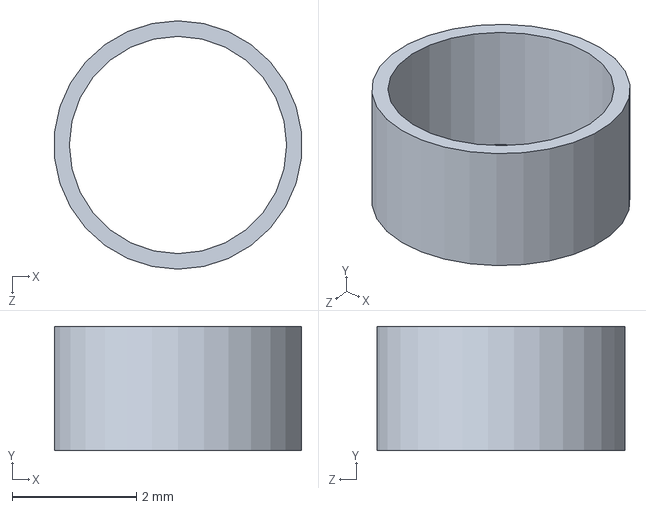
[picture p54: CAD file, 2026-05-27]
VP Collection Rover/spacer.SLDPRT
3.98 x 2.00 x 4.00 mm
