AntonyC03S/NASA_RASC-AL/VP Collection Rover/stage telescopic front mid.SLDPRT

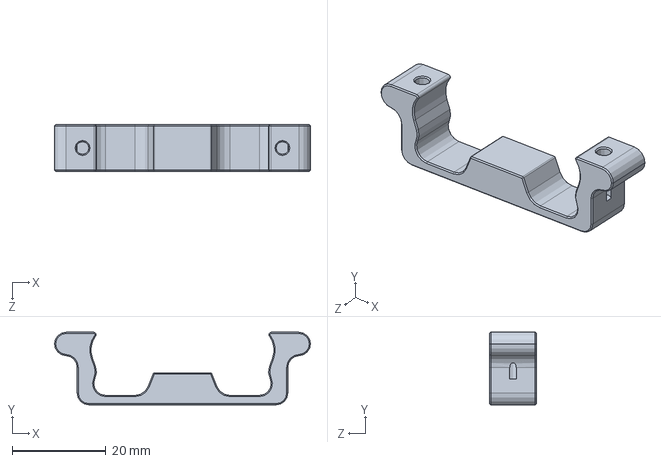
[picture p55: CAD file, 2026-05-18]
VP Collection Rover/stage telescopic front mid.SLDPRT
54.7 x 15.5 x 10.0 mm
