AntonyC03S/NASA_RASC-AL/VP Collection Rover/back things.SLDPRT

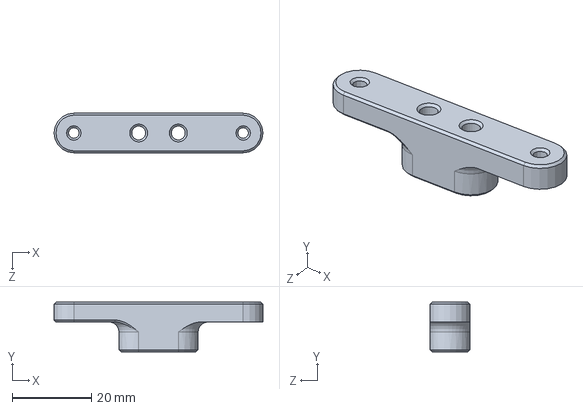
[picture p56: CAD file, 2026-05-18]
VP Collection Rover/back things.SLDPRT
52.7 x 12.5 x 10.0 mm
