AntonyC03S/NASA_RASC-AL/VP Collection Rover/stage telescopic back top.SLDPRT

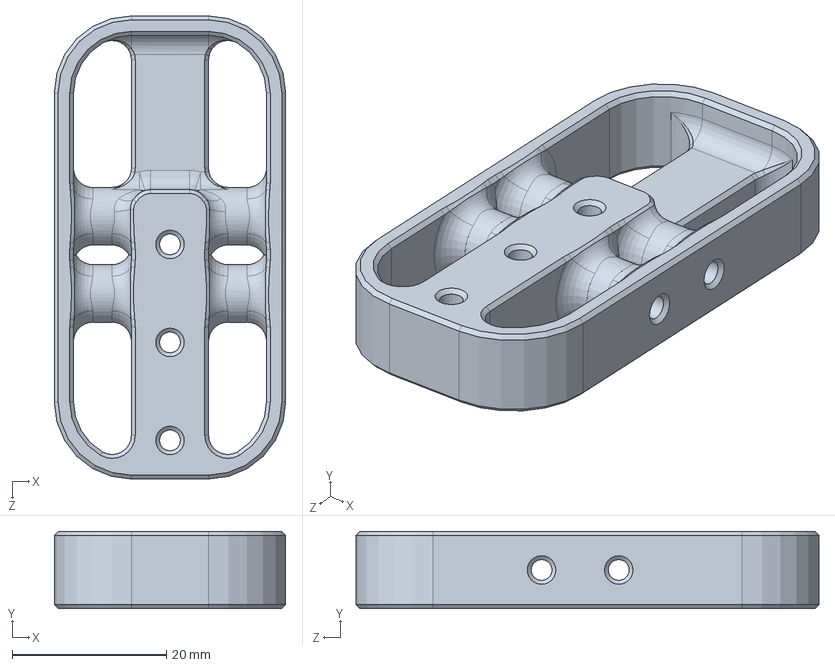
[picture p57: CAD file, 2026-05-18]
VP Collection Rover/stage telescopic back top.SLDPRT
30.0 x 10.0 x 60.0 mm
