AntonyC03S/NASA_RASC-AL/VP Collection Rover/Stage Telescopic mid front.SLDPRT

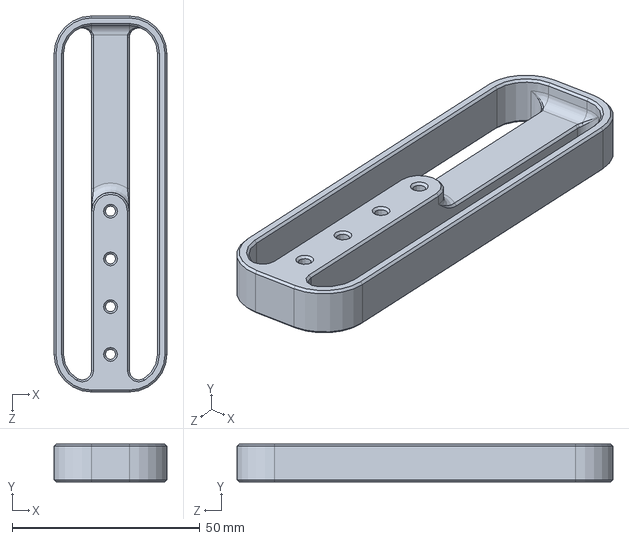
[picture p58: CAD file, 2026-05-18]
VP Collection Rover/Stage Telescopic mid front.SLDPRT
30.0 x 10.0 x 100.0 mm
