AntonyC03S/NASA_RASC-AL/VP Collection Rover/lid.SLDPRT

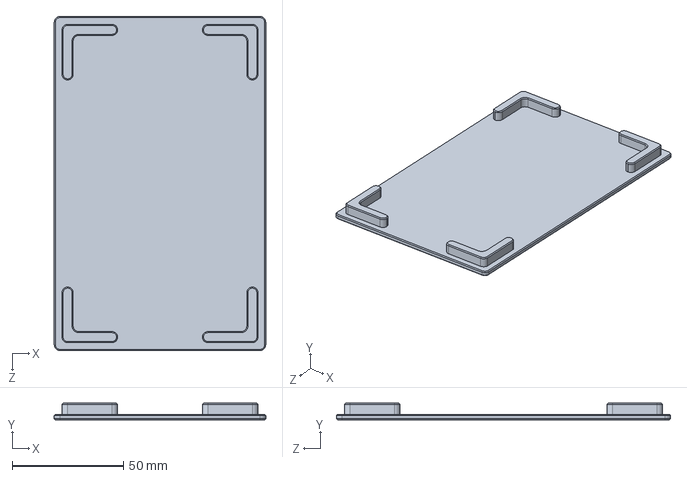
[picture p59: CAD file, 2026-05-18]
VP Collection Rover/lid.SLDPRT
95.0 x 7.50 x 150.0 mm
