AntonyC03S/NASA_RASC-AL/VP Collection Rover/box.SLDPRT

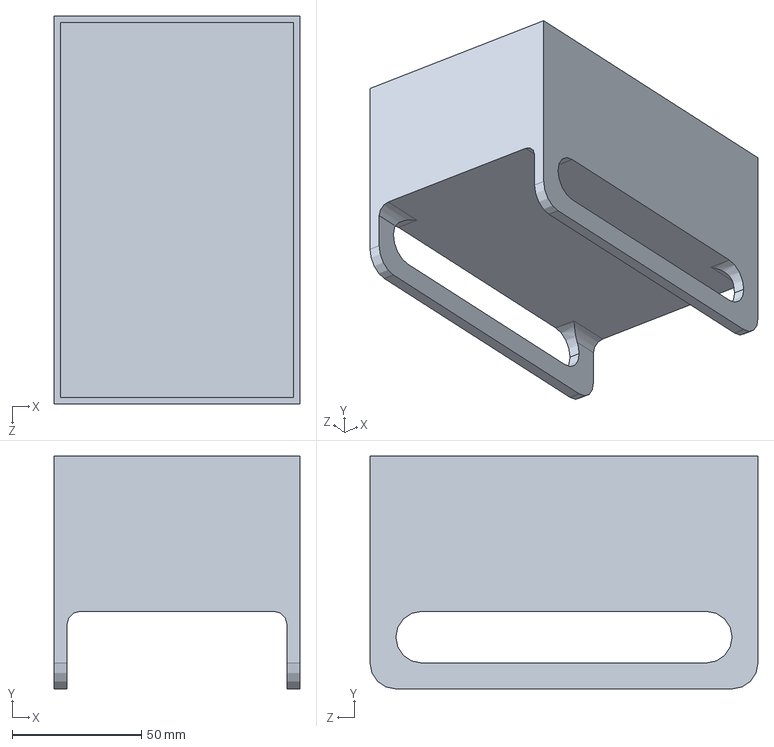
[picture p60: CAD file, 2026-05-18]
VP Collection Rover/box.SLDPRT
95.0 x 90.0 x 150.0 mm
