AntonyC03S/NASA_RASC-AL/VP Collection Rover/Stage Telescopic side.SLDPRT

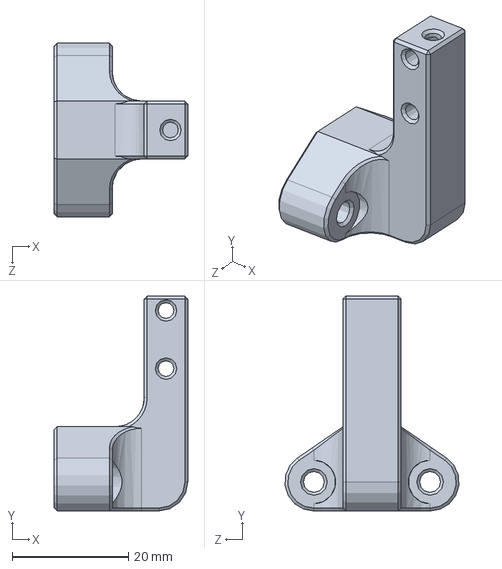
[picture p61: CAD file, 2026-05-18]
VP Collection Rover/Stage Telescopic side.SLDPRT
23.0 x 37.0 x 29.9 mm
