AntonyC03S/NASA_RASC-AL/VP Collection Rover/pulley.SLDPRT

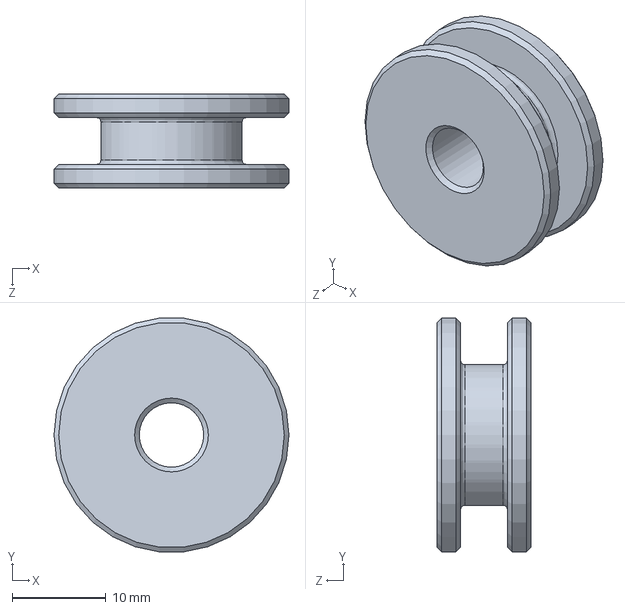
[picture p62: CAD file, 2026-05-07]
VP Collection Rover/pulley.SLDPRT
25.0 x 24.9 x 10.0 mm
