AntonyC03S/NASA_RASC-AL/VP Collection Rover/Rails Top Mount.SLDPRT

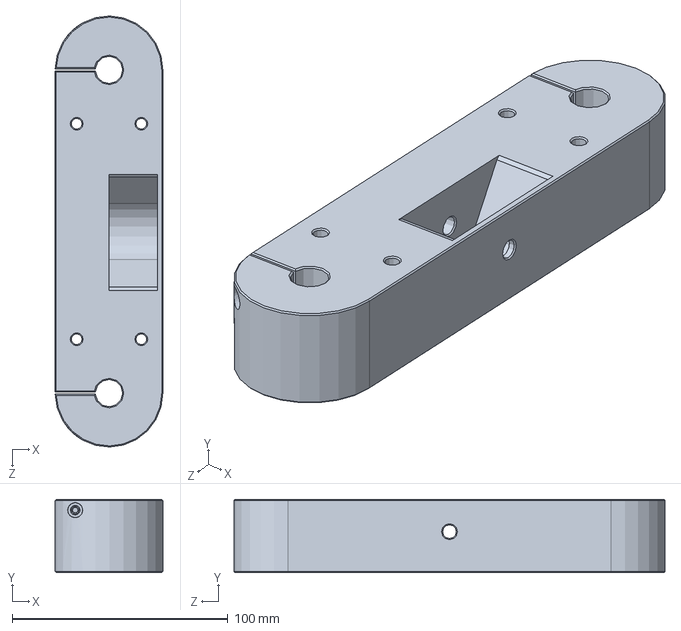
[picture p63: CAD file, 2026-05-07]
VP Collection Rover/Rails Top Mount.SLDPRT
50.0 x 34.0 x 200.0 mm
