AntonyC03S/NASA_RASC-AL/VP Collection Rover/Backing Telescopic.SLDPRT

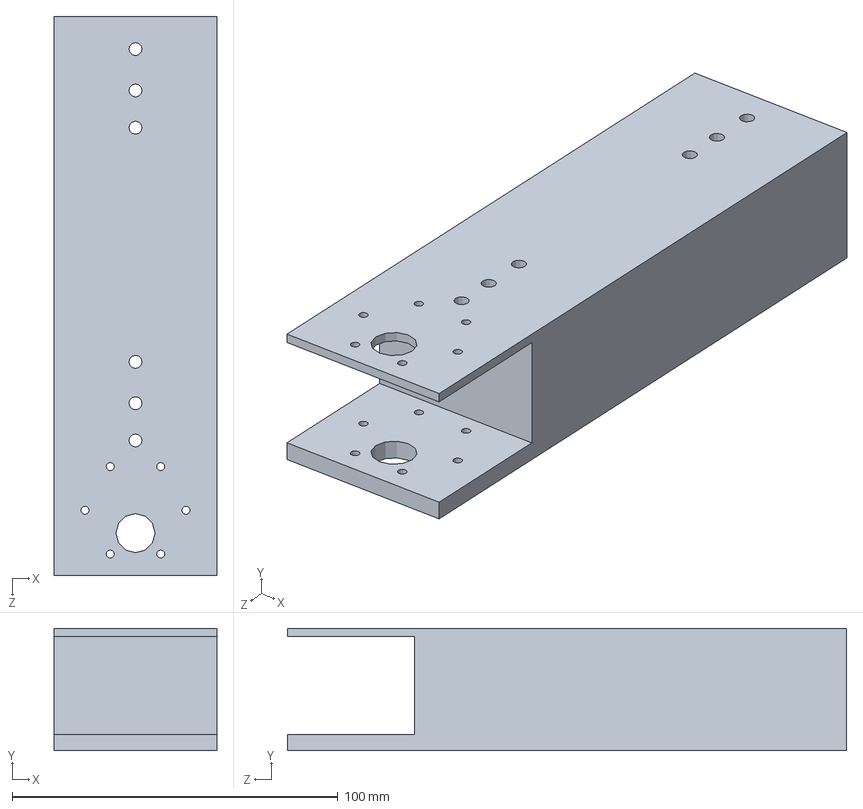
[picture p64: CAD file, 2026-05-07]
VP Collection Rover/Backing Telescopic.SLDPRT
50.0 x 37.5 x 171.6 mm
