AntonyC03S/NASA_RASC-AL/VP Collection Rover/pulley2.SLDPRT

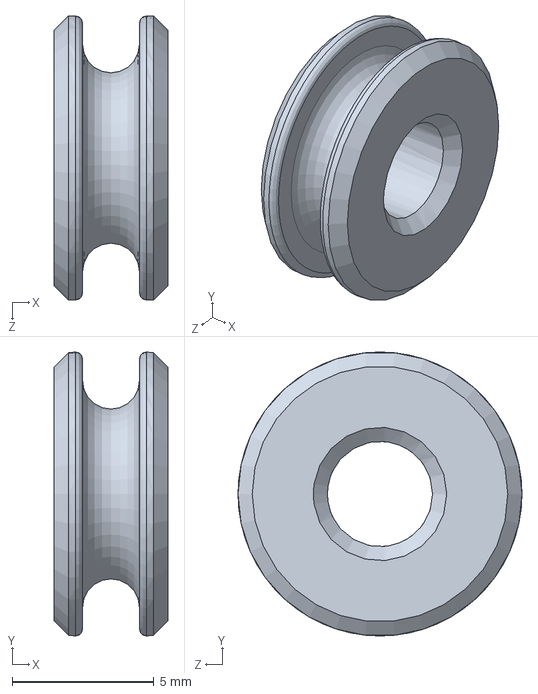
[picture p65: CAD file, 2026-05-07]
VP Collection Rover/pulley2.SLDPRT
4.00 x 10.0 x 10.0 mm
