AntonyC03S/NASA_RASC-AL/VP Collection Rover/pulley3.SLDPRT

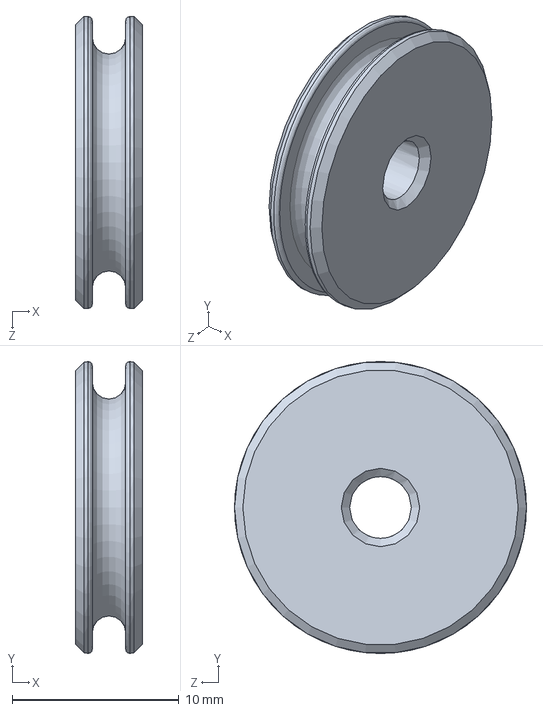
[picture p66: CAD file, 2026-05-07]
VP Collection Rover/pulley3.SLDPRT
4.00 x 17.5 x 17.5 mm
