AntonyC03S/NASA_RASC-AL/VP Collection Rover/Rails Bottom Mount.SLDPRT

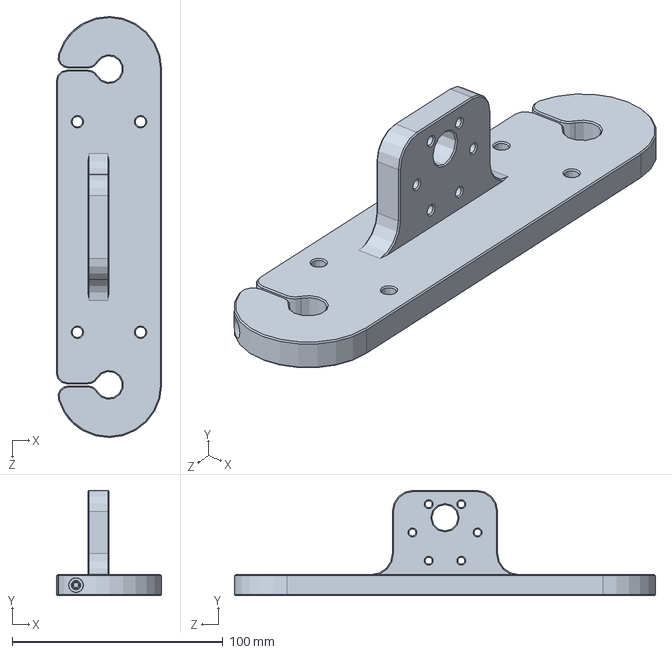
[picture p67: CAD file, 2026-05-07]
VP Collection Rover/Rails Bottom Mount.SLDPRT
50.0 x 50.0 x 200.0 mm
