AntonyC03S/NASA_RASC-AL/VP Collection Rover/Stage Telescopic Top back.SLDPRT

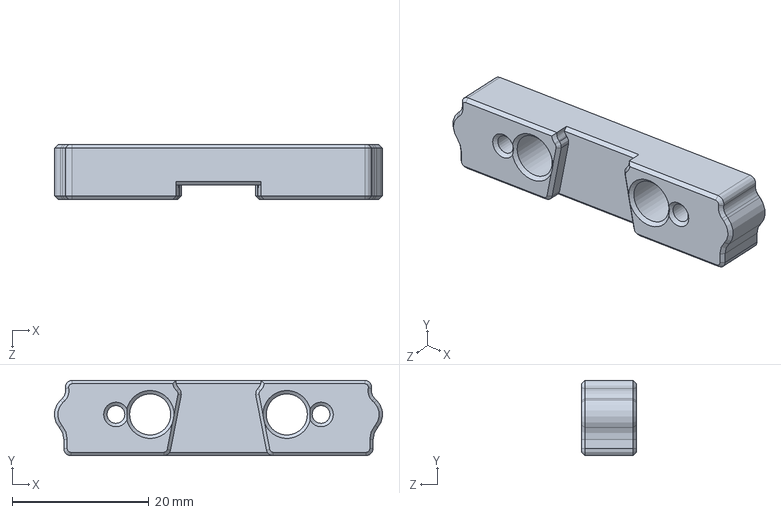
[picture p68: CAD file, 2026-05-07]
VP Collection Rover/Stage Telescopic Top back.SLDPRT
47.9 x 11.0 x 8.00 mm
