AntonyC03S/NASA_RASC-AL/VP Collection Rover/2x3-3.SLDPRT

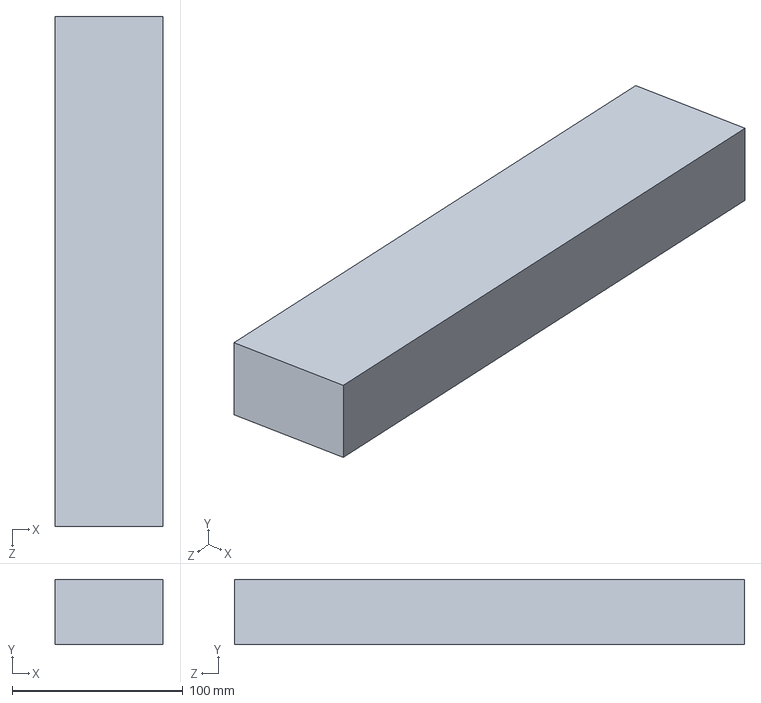
[picture p69: CAD file, 2026-04-16]
VP Collection Rover/2x3-3.SLDPRT
63.5 x 38.1 x 298.8 mm
