AntonyC03S/NASA_RASC-AL/VP Collection Rover/2x3-1.SLDPRT

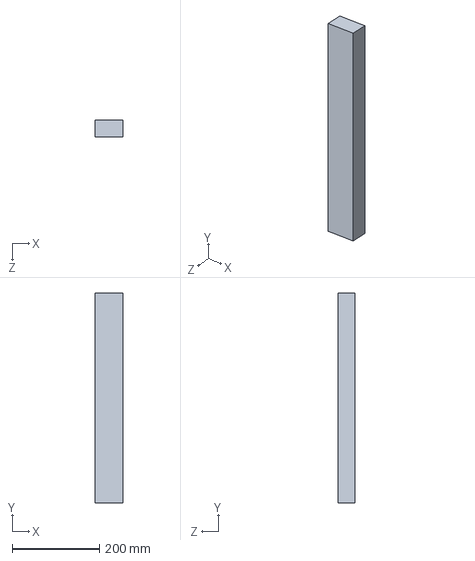
[picture p70: CAD file, 2026-04-16]
VP Collection Rover/2x3-1.SLDPRT
63.5 x 481.0 x 38.1 mm
