AntonyC03S/NASA_RASC-AL/VP Collection Rover/plywood-1.SLDPRT

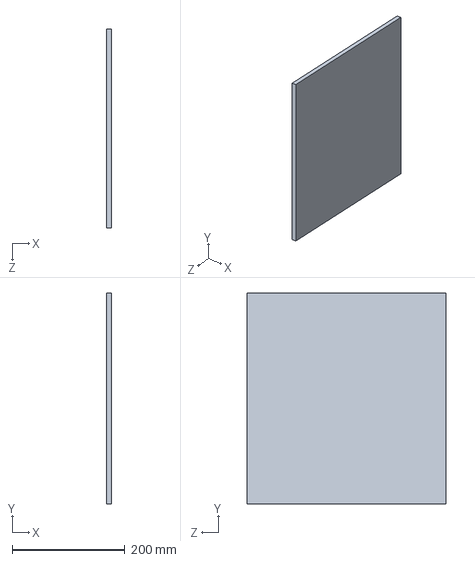
[picture p71: CAD file, 2026-04-16]
VP Collection Rover/plywood-1.SLDPRT
9.53 x 375.0 x 353.9 mm
