AntonyC03S/NASA_RASC-AL/VP Collection Rover/plywood-3.SLDPRT

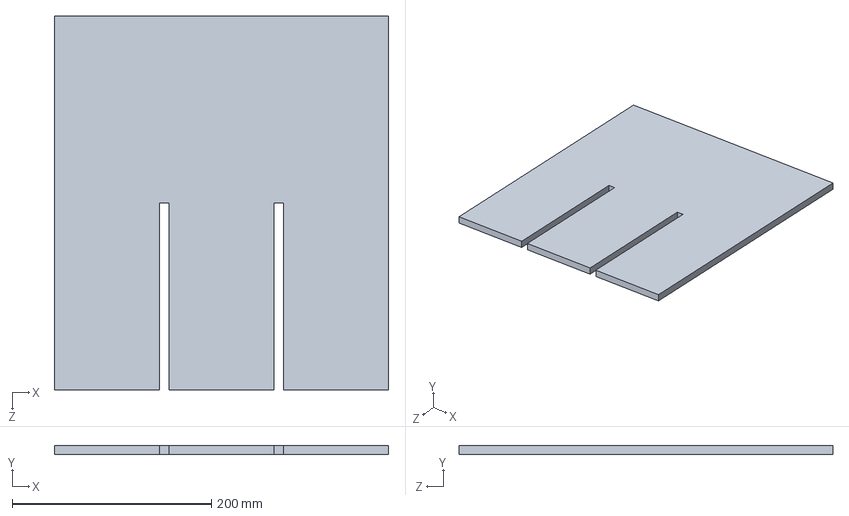
[picture p72: CAD file, 2026-04-16]
VP Collection Rover/plywood-3.SLDPRT
334.9 x 9.53 x 375.0 mm
