AntonyC03S/NASA_RASC-AL/VP Collection Rover/2x3-2.SLDPRT

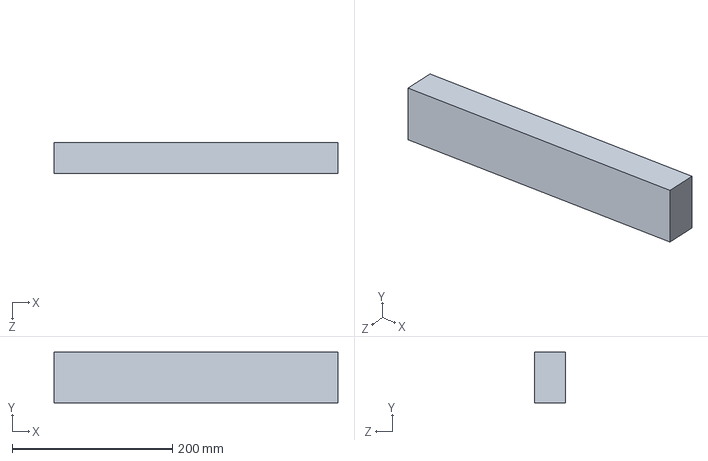
[picture p73: CAD file, 2026-04-16]
VP Collection Rover/2x3-2.SLDPRT
354.0 x 63.5 x 38.1 mm
