AntonyC03S/NASA_RASC-AL/VP Collection Rover/divider.SLDPRT

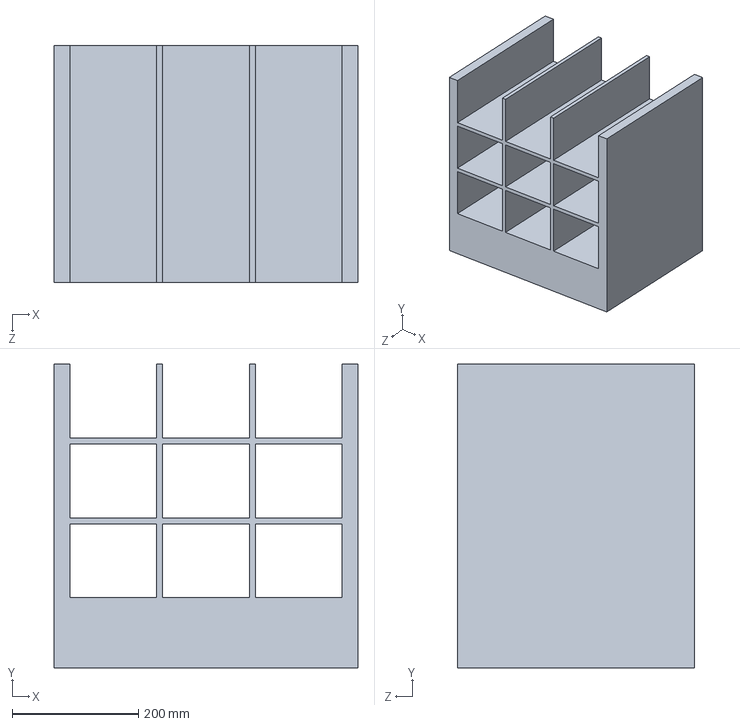
[picture p74: CAD file, 2026-04-15]
VP Collection Rover/divider.SLDPRT
481.0 x 480.9 x 375.0 mm
