AntonyC03S/NASA_RASC-AL/VP Collection Rover/Clamp.SLDPRT

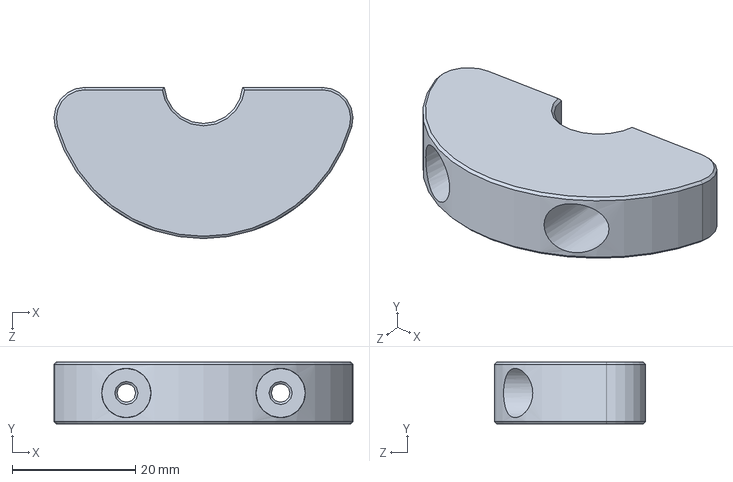
[picture p75: CAD file, 2026-04-15]
VP Collection Rover/Clamp.SLDPRT
48.5 x 10.0 x 24.5 mm
