AntonyC03S/NASA_RASC-AL/VP Collection Rover/Body Wall.SLDPRT

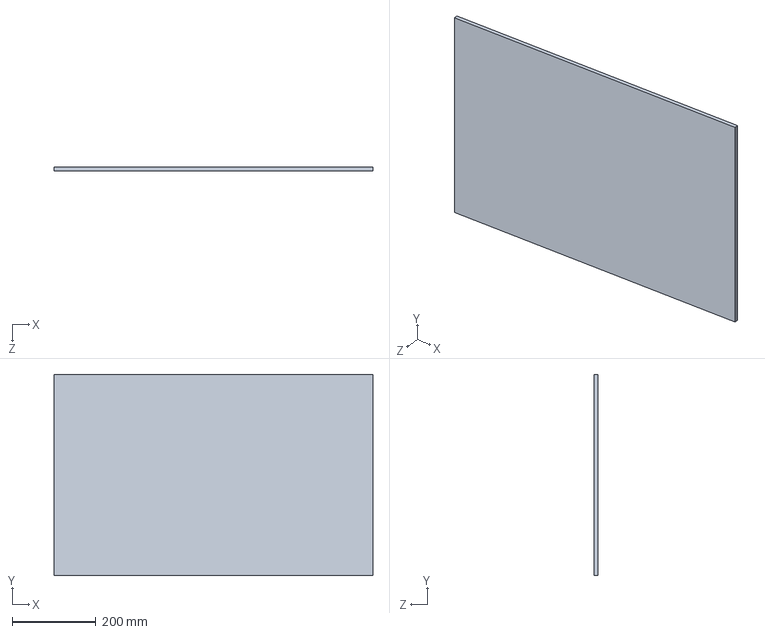
[picture p76: CAD file, 2026-02-13]
VP Collection Rover/Body Wall.SLDPRT
762.5 x 481.0 x 9.53 mm
