AntonyC03S/NASA_RASC-AL/VP Collection Rover/Body Plate.SLDPRT

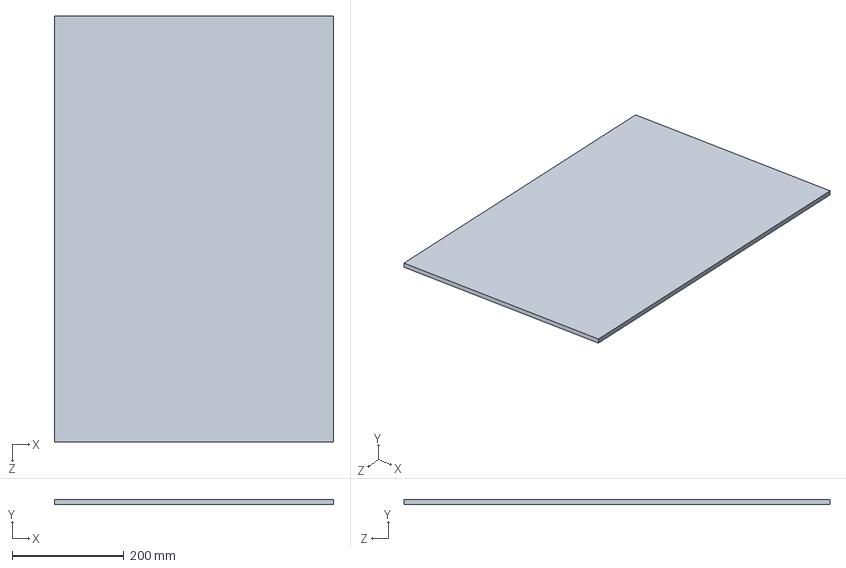
[picture p77: CAD file, 2026-02-13]
VP Collection Rover/Body Plate.SLDPRT
500.0 x 9.53 x 762.5 mm
