AntonyC03S/NASA_RASC-AL/VP Collection Rover/Collection Rover Body.SLDPRT

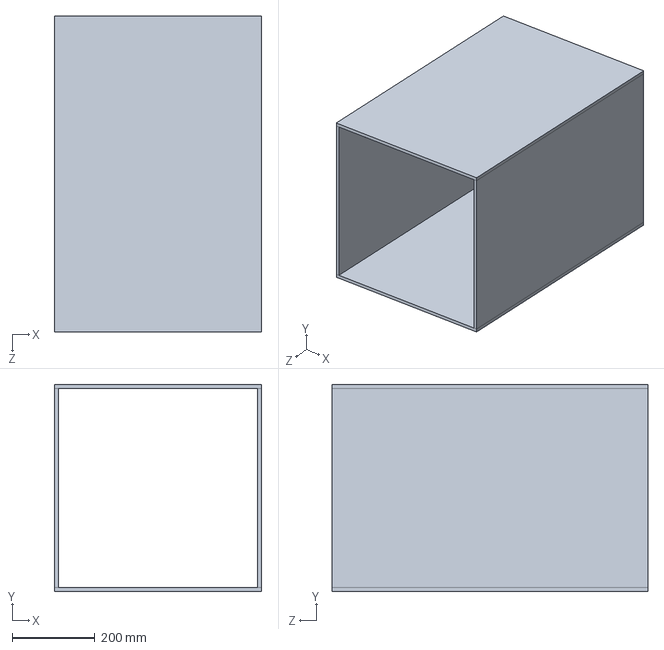
[picture p78: CAD file, 2026-02-13]
VP Collection Rover/Collection Rover Body.SLDPRT
500.0 x 500.0 x 762.5 mm
