AntonyC03S/NASA_RASC-AL/VP Collection Rover/shelf wall.SLDPRT

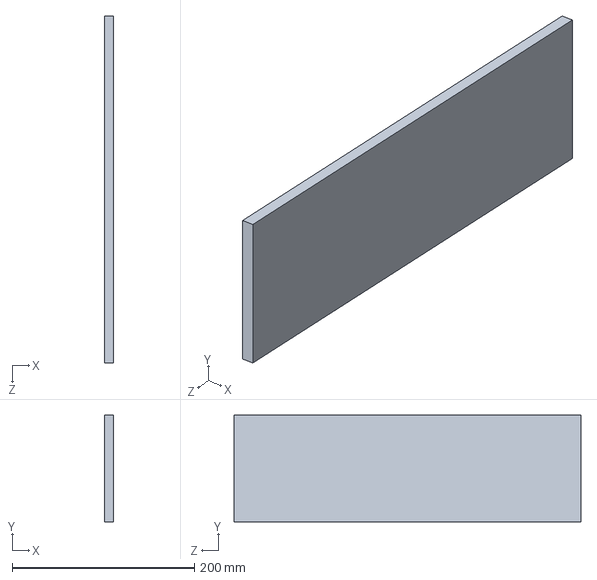
[picture p79: CAD file, 2026-02-13]
VP Collection Rover/shelf wall.SLDPRT
9.53 x 117.5 x 381.2 mm
