AntonyC03S/NASA_RASC-AL/VP Collection Rover/Stage Telescopic Top.SLDPRT

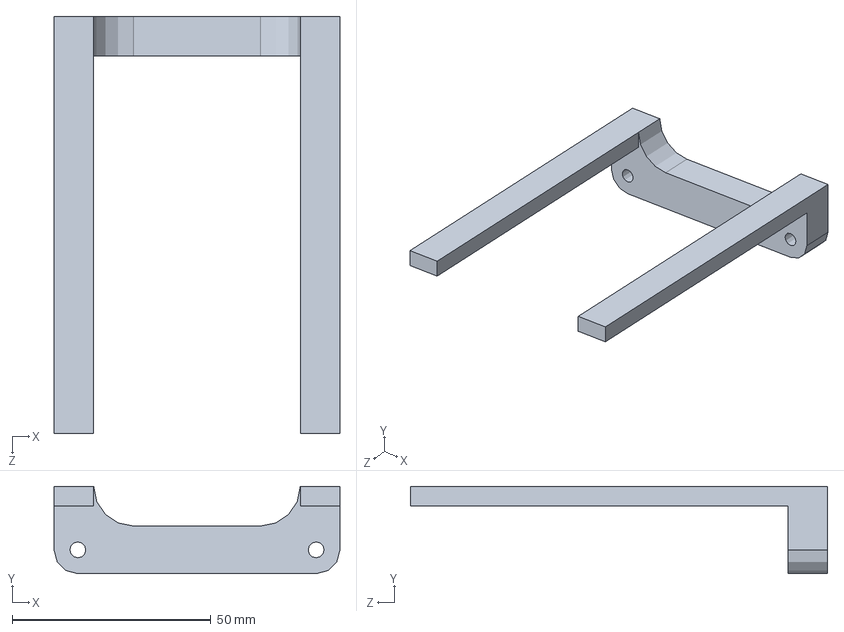
[picture p80: CAD file, 2026-02-13]
VP Collection Rover/Stage Telescopic Top.SLDPRT
72.0 x 22.0 x 105.0 mm
