AntonyC03S/NASA_RASC-AL/VP Collection Rover/shelf plate.SLDPRT

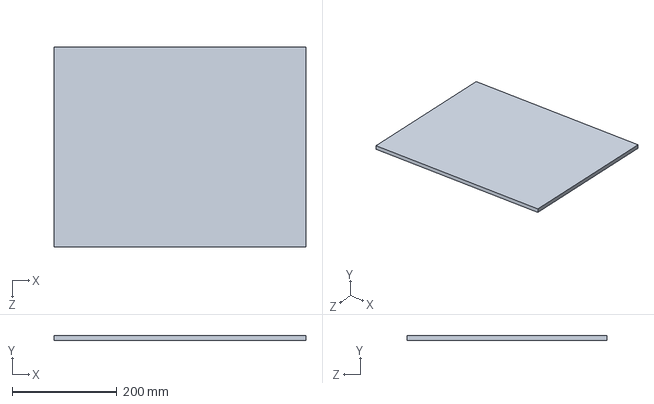
[picture p81: CAD file, 2026-02-13]
VP Collection Rover/shelf plate.SLDPRT
481.0 x 9.53 x 381.2 mm
