AntonyC03S/NASA_RASC-AL/VP Collection Rover/Stage 2nd Telescopic.SLDPRT

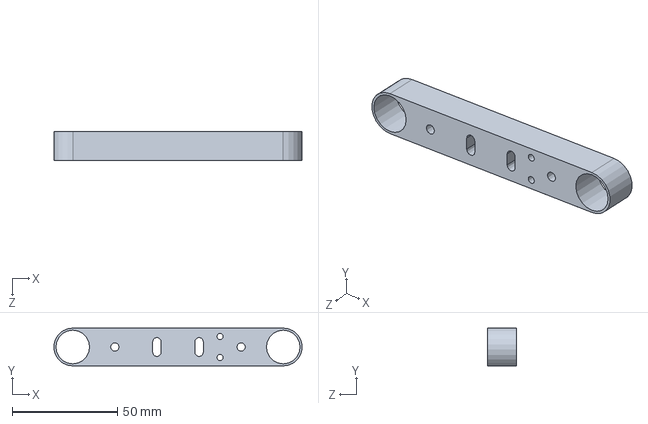
[picture p82: CAD file, 2026-02-10]
VP Collection Rover/Stage 2nd Telescopic.SLDPRT
117.8 x 18.0 x 14.0 mm
