AntonyC03S/NASA_RASC-AL/VP Collection Rover/Stage Telescopic.SLDPRT

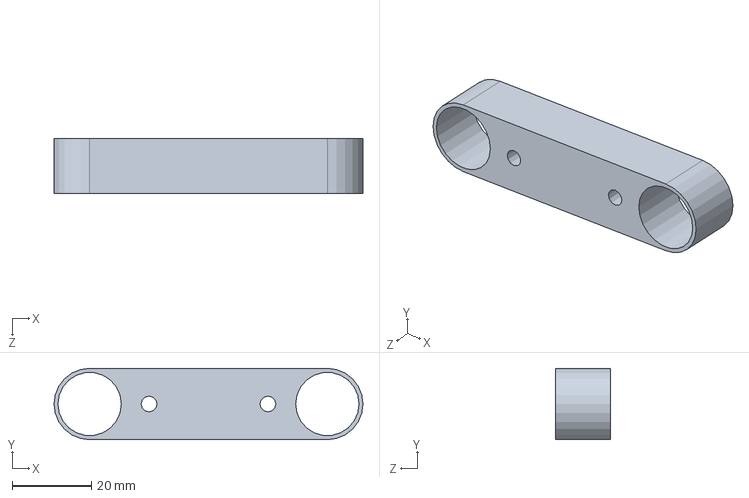
[picture p83: CAD file, 2026-02-10]
VP Collection Rover/Stage Telescopic.SLDPRT
78.0 x 18.0 x 14.0 mm
