AntonyC03S/NASA_RASC-AL/VP Collection Rover/Rail Telescopic.SLDPRT

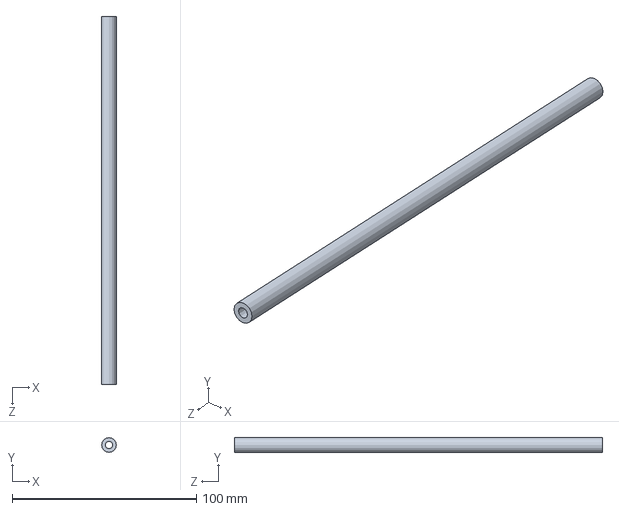
[picture p84: CAD file, 2026-02-10]
VP Collection Rover/Rail Telescopic.SLDPRT
8.00 x 8.00 x 200.0 mm
