AntonyC03S/NASA_RASC-AL/VP Collection Rover/37d-gearmotor-100-131-150-encoder.SLDPRT

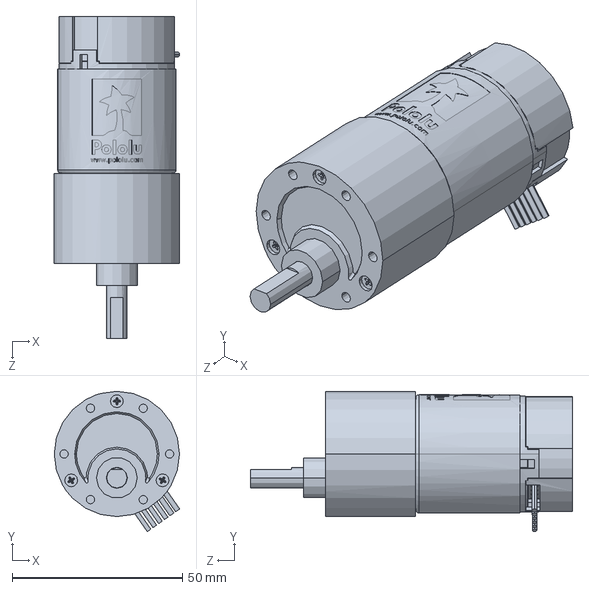
[picture p85: CAD file, 2026-02-05]
VP Collection Rover/37d-gearmotor-100-131-150-encoder.SLDPRT
36.9 x 41.2 x 94.6 mm
