AntonyC03S/NASA_RASC-AL/Collection Rover/Collection Rover Assembly.SLDASM

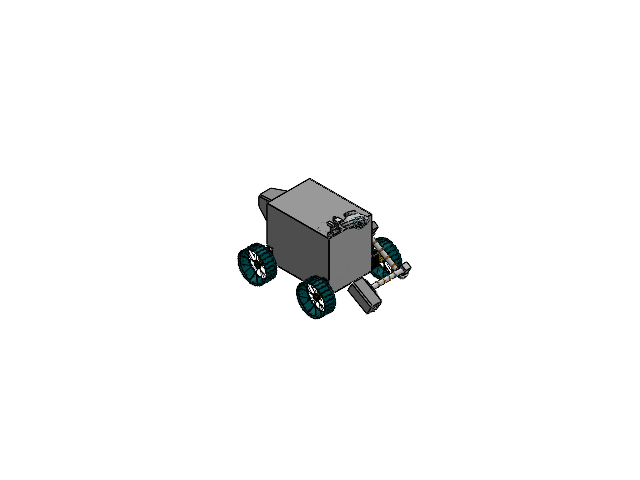
[picture p86: CAD file, 2026-02-23]
Collection Rover/Collection Rover Assembly.SLDASM
Rover body
Segment 1
Segment 2
Bearing
Vertical Segment
End Effector
Bit Carousel
BottomloadedTray x 2
DrillArm
Drill Head
CameraSystem
SuspensionSleeve x 4
MMRTG
WheelConnection x 4
ControlArm x 8
Wheelv2 x 4
E67 ECU
