AntonyC03S/NASA_RASC-AL/Storage Rover/Elevator/Elevator.SLDASM

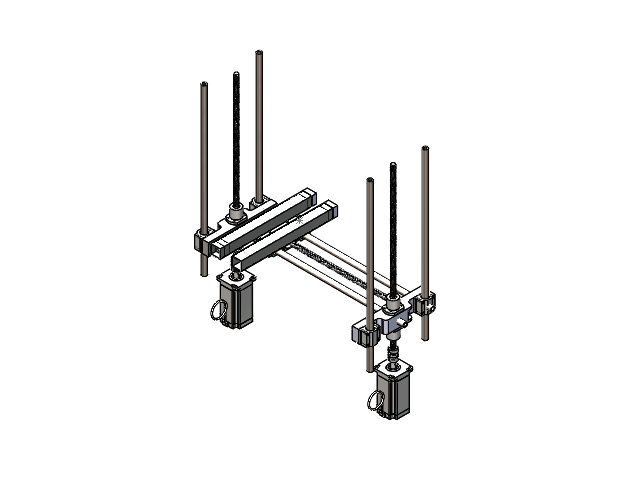
[picture p87: CAD file, 2026-02-23]
Storage Rover/Elevator/Elevator.SLDASM
Rails x 4
6374K154_Mounted Sleeve Linear Bearing x 6
6624K4_Ball Screw x 2
6624K44_Flange Ball Nut x 5
Cage
6624K4_Ball Screw_Cut
Mid_Rails x 2
5972K245_Ball Bearing
2464K64_Clamping Precision Flexible Shaft Coupling x 3
6627T171_Stepper Motor x 2
6627T92_Stepper Motor
Mid_Cage
1st Arm x 2
2nd Arm x 2
3rd Arm x 2
1st Top Bearing x 2
2nd Top Bearing x 2
3rd Top Bearing x 2
1st Bot Bearing
MirrorCage
