AntonyC03S/NASA_RASC-AL/VP Collection Rover/drawer slides/Drawer Slides.SLDASM

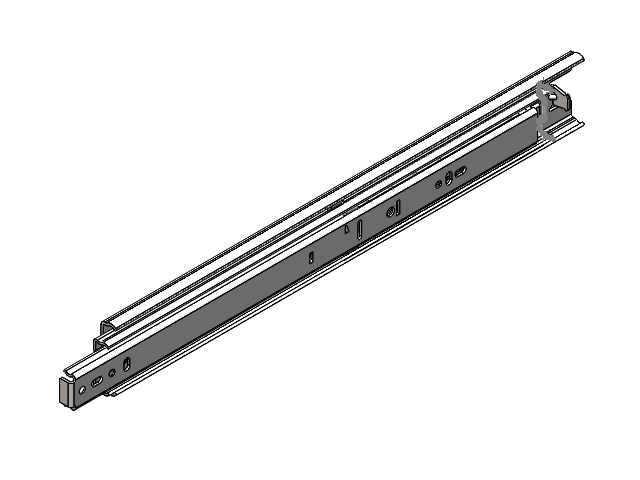
[picture p88: CAD file, 2026-05-27]
VP Collection Rover/drawer slides/Drawer Slides.SLDASM
1102A14_Steel Base-Mount Drawer Slides-1
1102A14_Steel Base-Mount Drawer Slides-2
1102A14_Steel Base-Mount Drawer Slides-3
