AntonyC03S/NASA_RASC-AL/VP Collection Rover/VP Elevator.SLDASM

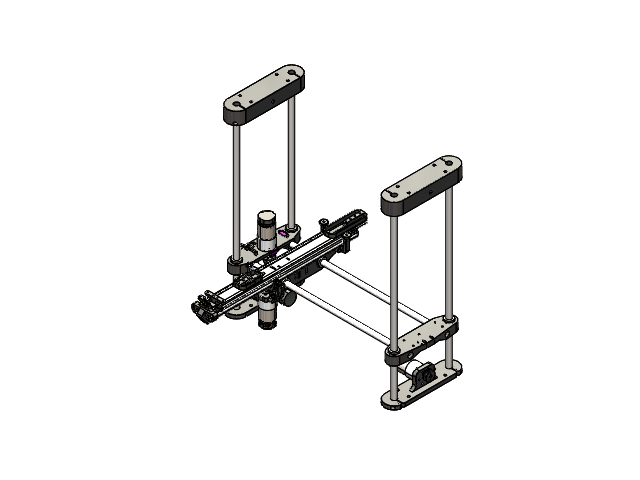
[picture p89: CAD file, 2026-05-27]
VP Collection Rover/VP Elevator.SLDASM
6061K43_Linear Motion Shaft x 6
6673K13_High-Speed Linear Sleeve Bearing x 6
9968K24_External Retaining Ring x 12
Rails Bottom Mount x 2
37d-gearmotor-100-131-150-encoder x 4
Rails Top Mount x 2
Bearing Mount
Spool x 4
Bearing Arm Mount
String Clamp x 4
1102A14_Steel Base-Mount Drawer Slides-1
1102A14_Steel Base-Mount Drawer Slides-2
1102A14_Steel Base-Mount Drawer Slides-3
Stage Telescopic side x 2
Stage Telescopic mid back
Stage Telescopic mid front
Stage Telescopic Top back
Stage Telescopic clamp
pulley
pulley support
Stage Telescopic Top back 2
pulley2 x 5
pulley3 x 2
stage telescopic back top
stage telescopic front mid
back things
Spool v3
Spool v3.1
top.step x 3
pcb.step x 3
kork.step x 3
pads.step x 3
Pin1.step x 3
Pin2.step x 3
CeramicBody.step x 3
Pin1_1.step x 3
Pin2_1.step x 3
CeramicBody_1.step x 3
Pin1_2.step x 3
Pin2_2.step x 3
CeramicBody_2.step x 3
Pin1_3.step x 3
Pin2_3.step x 3
CeramicBody_3.step x 3
Document.step x 3
Document_1.step x 3
SOT-23-3 v1.step x 3
SOT-23-6 v2.step x 3
8_Pin_DIP.step x 3
VL53L0X_1-0.step x 3
VL53L0X_1-1.step x 3
VL53L0X_1-2.step x 3
VL53L0X_1-3.step x 3
VL53L0X_1-4.step x 3
VL53L0X_1-5.step x 3
VL53L0X_1-6.step x 3
VL53L0X_1-7.step x 3
VL53L0X_1-8.step x 3
VL53L0X_1-9.step x 3
VL53L0X_1-10.step x 3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
