AntonyC03S/NASA_RASC-AL/Collection Rover/Drill Subsystem/Drill Assembly.SLDASM

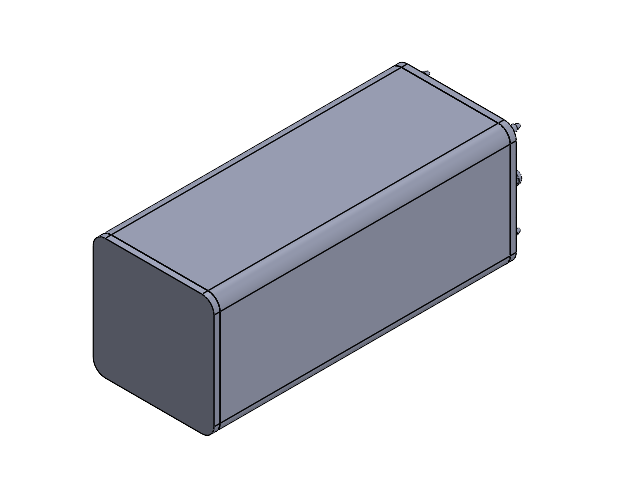
[picture p90: CAD file, 2026-02-10]
Collection Rover/Drill Subsystem/Drill Assembly.SLDASM
Copy of Part9^Assem2
Part6^Assembly 2
Part8^Assembly 2 x 2
Part9^Drill Assembly
