AntonyC03S/NASA_RASC-AL/VP Collection Rover/Collection Rover.SLDASM

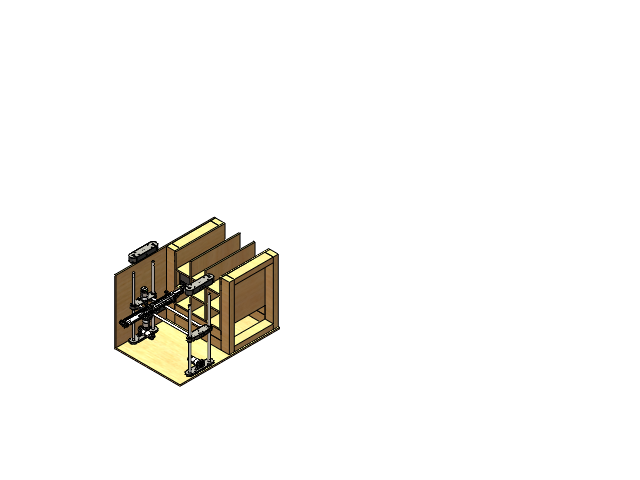
[picture p91: CAD file, 2026-05-18]
VP Collection Rover/Collection Rover.SLDASM
Body Wall
Body Plate
6061K43_Linear Motion Shaft x 6
6673K13_High-Speed Linear Sleeve Bearing x 6
9968K24_External Retaining Ring x 12
Rails Bottom Mount x 2
37d-gearmotor-100-131-150-encoder x 4
Rails Top Mount x 2
Bearing Mount
Spool x 4
Bearing Arm Mount
String Clamp x 4
1102A14_Steel Base-Mount Drawer Slides-1
1102A14_Steel Base-Mount Drawer Slides-2
1102A14_Steel Base-Mount Drawer Slides-3
Stage Telescopic side x 2
Stage Telescopic mid back
Stage Telescopic mid front
Stage Telescopic Top back
Stage Telescopic clamp
pulley
pulley support
Stage Telescopic Top back 2
pulley2 x 5
spool v2.2
pulley3 x 2
stage telescopic back top
stage telescopic front mid
back things
MirrorBearing Mount
Mirrorpulley support
2x3-1 x 4
2x3-2 x 4
2x3-3 x 4
plywood-1 x 2
plywood-2
plywood-3 x 4
