AntonyC03S/NASA_RASC-AL/VP Collection Rover/Shelf.SLDASM

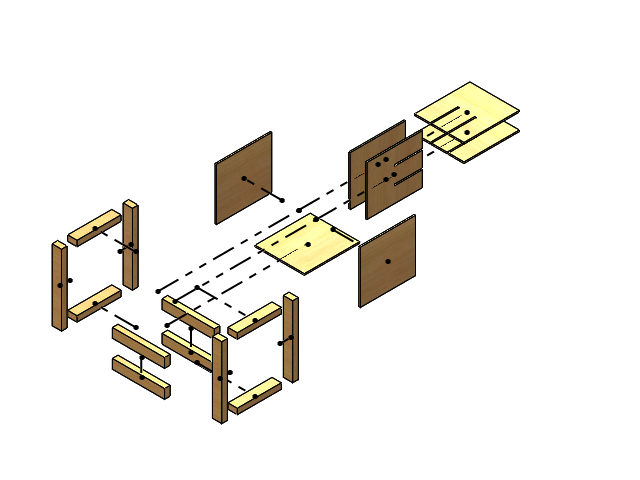
[picture p92: CAD file, 2026-04-16]
VP Collection Rover/Shelf.SLDASM
2x3-1 x 4
2x3-2 x 4
2x3-3 x 4
plywood-1 x 2
plywood-2
plywood-3 x 4
