AntonyC03S/NASA_RASC-AL/(list of files, cad)

Other CAD files:
Collection Rover/Drill Subsystem/Part6^Assembly 2.SLDPRT
Collection Rover/Transfer Subsystem/Transfer mechanism assembly.SLDASM
Collection Rover/Drill Subsystem/Assem2.SLDASM
Collection Rover/Drill Subsystem/Part8^Assembly 2.SLDPRT
Collection Rover/Drill Subsystem/Copy of Part9^Assem2.SLDPRT
Storage Rover/SuspensionSleeve.SLDPRT
Collection Rover/CameraSystem.sldprt
Storage Rover/Elevator/Cage.SLDPRT
TransferMechansimDemo/BottomloadedTray.SLDPRT
Collection Rover/Drill Subsystem/Part 1.SLDPRT
Storage Rover/WheelConnection.SLDPRT
Storage Rover/MMRTG.SLDPRT
VP Collection Rover/Mirrorpulley support.SLDPRT
VP Collection Rover/plywood-2.SLDPRT
Storage Rover/Elevator/McMasterCarr/2464K64_Clamping Precision Flexible Shaft Coupling.SLDPRT
Storage Rover/Elevator/McMasterCarr/5972K245_Ball Bearing.SLDPRT
Storage Rover/Elevator/McMasterCarr/6374K154_Mounted Sleeve Linear Bearing.SLDPRT
Storage Rover/Elevator/McMasterCarr/6624K44_Flange Ball Nut.SLDPRT
Storage Rover/Elevator/McMasterCarr/6627T171_Stepper Motor.SLDPRT
Storage Rover/Elevator/McMasterCarr/6627T92_Stepper Motor.SLDPRT
VP Collection Rover/6061K43_Linear Motion Shaft.SLDPRT
VP Collection Rover/6112K44_Linear Motion Shaft.SLDPRT
VP Collection Rover/6673K13_High-Speed Linear Sleeve Bearing.SLDPRT
VP Collection Rover/6673K37_High-Speed Sleeve Linear Bearing.SLDPRT
VP Collection Rover/9968K24_External Retaining Ring.SLDPRT
VP Collection Rover/9968K32_External Retaining Ring.SLDPRT
VP Collection Rover/Frame/2x3-1.SLDDRW
VP Collection Rover/Frame/2x3-2.SLDDRW
VP Collection Rover/Frame/2x3-3.SLDDRW
VP Collection Rover/Frame/Shelf.SLDDRW
VP Collection Rover/Frame/plywood-1.SLDDRW
VP Collection Rover/Frame/plywood-2.SLDDRW
VP Collection Rover/Frame/plywood-3.SLDDRW
VP Collection Rover/New Drawing/6061K43_Linear Motion Shaft.SLDDRW
VP Collection Rover/New Drawing/6112K44_Linear Motion Shaft.SLDDRW
VP Collection Rover/New Drawing/Bearing Arm Mount.SLDDRW
VP Collection Rover/New Drawing/Bearing Mount.SLDDRW
VP Collection Rover/New Drawing/Body Plate.SLDDRW
VP Collection Rover/New Drawing/Body Wall.SLDDRW
VP Collection Rover/New Drawing/Clamp.SLDDRW
VP Collection Rover/New Drawing/Collection Rover ASS.SLDDRW
VP Collection Rover/New Drawing/Collection Rover.SLDDRW
VP Collection Rover/New Drawing/Rails Bottom Mount.SLDDRW
VP Collection Rover/New Drawing/Rails Top Mount.SLDDRW
VP Collection Rover/New Drawing/Spool.SLDDRW
VP Collection Rover/New Drawing/Stage 2nd Telescopic.SLDDRW
VP Collection Rover/New Drawing/Stage Telescopic Top.SLDDRW
VP Collection Rover/New Drawing/String Clamp.SLDDRW
VP Collection Rover/New Drawing/VP Elevator ASS.SLDDRW
VP Collection Rover/New Drawing/VP Elevator.SLDDRW
VP Collection Rover/New Drawing/shelf plate.SLDDRW
VP Collection Rover/New Drawing/shelf wall.SLDDRW
VP Collection Rover/Old Drawing/Bearing Arm Mount.SLDDRW
VP Collection Rover/Old Drawing/Bearing Mount.SLDDRW
VP Collection Rover/Old Drawing/Clamp.SLDDRW
VP Collection Rover/Old Drawing/Collection Rover Body.SLDDRW
VP Collection Rover/Old Drawing/Collection Rover.SLDDRW
VP Collection Rover/Old Drawing/Rails Bottom Mount..SLDDRW
VP Collection Rover/Old Drawing/Rails Bottom Mount.SLDDRW
VP Collection Rover/Old Drawing/Rails Top Mount.SLDDRW
VP Collection Rover/Old Drawing/Spool.SLDDRW
VP Collection Rover/Old Drawing/String Clamp.SLDDRW
VP Collection Rover/Old Drawing/VP Elevator.SLDDRW
VP Collection Rover/Old Drawing/shelf plate.SLDDRW
VP Collection Rover/Old Drawing/shelf wall.SLDDRW
VP Collection Rover/Spool v3.SLDPRT
VP Collection Rover/Spool.SLDPRT
VP Collection Rover/drawer slides/1102A14_Steel Base-Mount Drawer Slides-1.SLDPRT
VP Collection Rover/drawer slides/1102A14_Steel Base-Mount Drawer Slides-2.SLDPRT
VP Collection Rover/drawer slides/1102A14_Steel Base-Mount Drawer Slides-3.SLDPRT
VP Collection Rover/spool v2.2.SLDPRT
VP Collection Rover/spool v2.SLDPRT
