AntonyC03S/NASA_RASC-AL/VP Collection Rover/PerformanceLog.txt

Number of Contacts: 200
Number of contact data: 31629
