AntonyC03S/NASA_RASC-AL/VP Collection Rover/New Drawing/6061K43_Linear Motion Shaft.PDF

1566 Carbon Steel; Antony Chen; DRAWN BY:; SCALE: 2:3; SHEET 1 OF 1; INTERPRET DRAWING; PER ASME Y14.5 2009; PART #:; 6061K43_Linear Motion Shaft

UNLESS OTHERWISE SPECIFIED:
DIMENSIONS ARE IN MM
ANGLES=±1°
INSIDE TOOL RADIUS 0.5 MAX
BREAK SHARP EDGES 0.1 MAX
FAO

SOLIDWORKS Educational Product. For Instructional Use Only.
