AntonyC03S/NASA_RASC-AL/VP Collection Rover/New Drawing/Bearing Arm Mount.PDF

2X 16.0 THRU ALL; 2X 6.0 THRU ALL; Antony Chen; SCALE: 1:2; SHEET 1 OF 1; INTERPRET DRAWING; PER ASME Y14.5 2009; PART #:; Bearing Arm Mount

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

MATERIAL:
PolyLite™ PLA Pro
DRAWN BY:

SOLIDWORKS Educational Product. For Instructional Use Only.
