AntonyC03S/NASA_RASC-AL/VP Collection Rover/New Drawing/.Full Drawing No GD&T.pdf

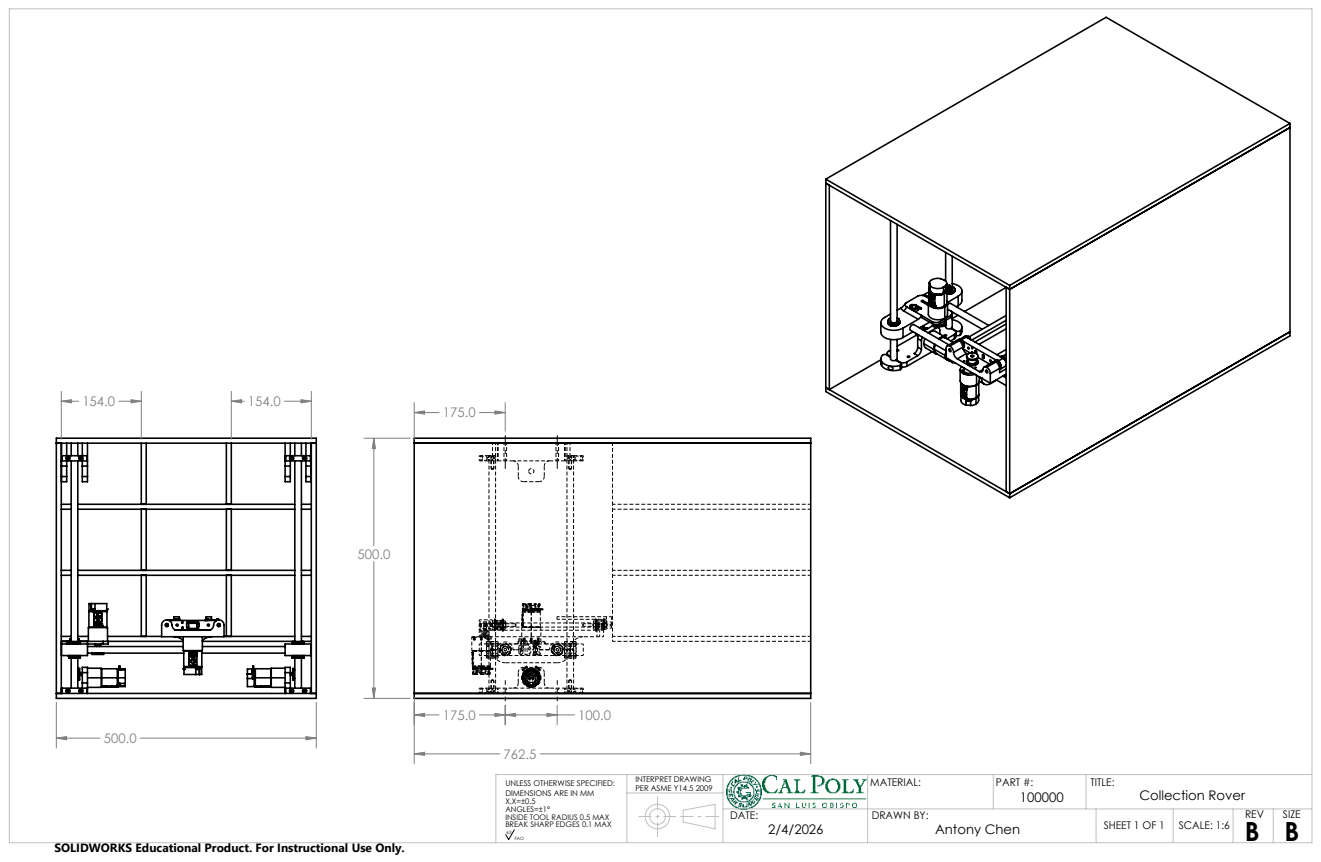
[picture p112: page 1]
Antony Chen; DATE:; MATERIAL:; FAO; DRAWN BY:; TITLE:; SIZE B; REV; SCALE: 1:6; SHEET 1 OF 1; INTERPRET DRAWING; PER ASME Y14.5 2009; PART #:; Collection Rover

UNLESS OTHERWISE SPECIFIED:
DIMENSIONS ARE IN MM
ANGLES=±1°
INSIDE TOOL RADIUS 0.5 MAX
BREAK SHARP EDGES 0.1 MAX

SOLIDWORKS Educational Product. For Instructional Use Only.

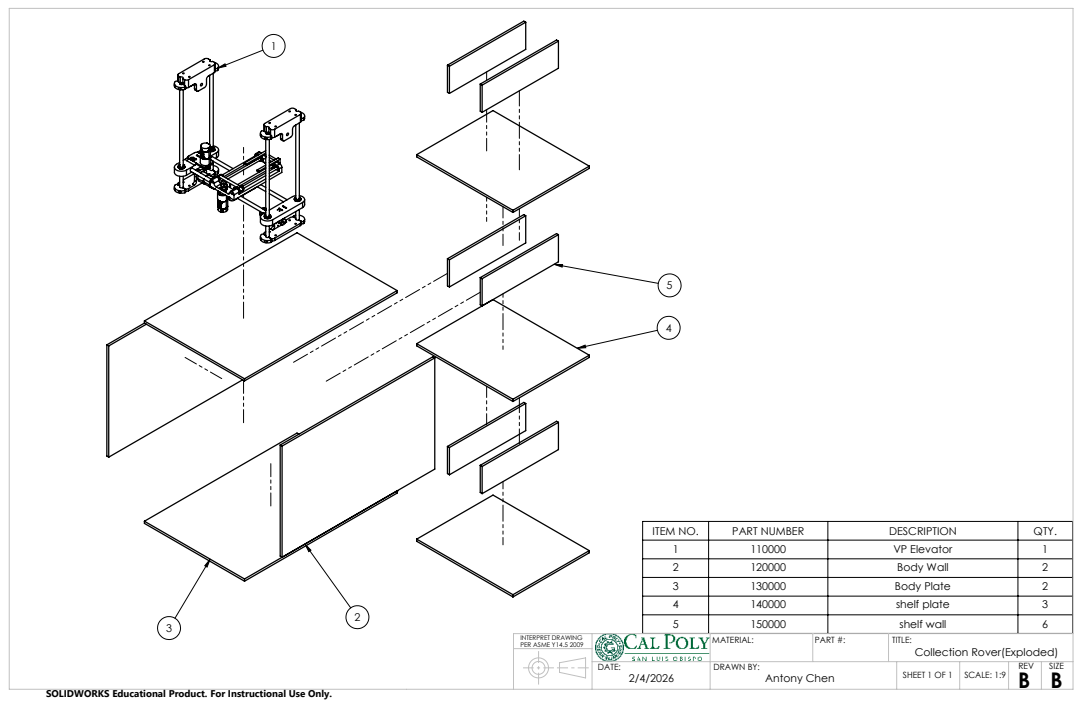
[picture p113: page 2]
Antony Chen; MATERIAL:; INTERPRET DRAWING; PER ASME Y14.5 2009; PART #:

ITEM NO. | PART NUMBER | DESCRIPTION | QTY.
1 | 110000 | VP Elevator | 1
2 | 120000 | Body Wall | 2
3 | 130000 | Body Plate | 2
4 | 140000 | shelf plate | 3
5 | 150000 | shelf wall | 6

TITLE:
Collection Rover(Exploded)

SHEET 1 OF 1 SCALE: 1:9

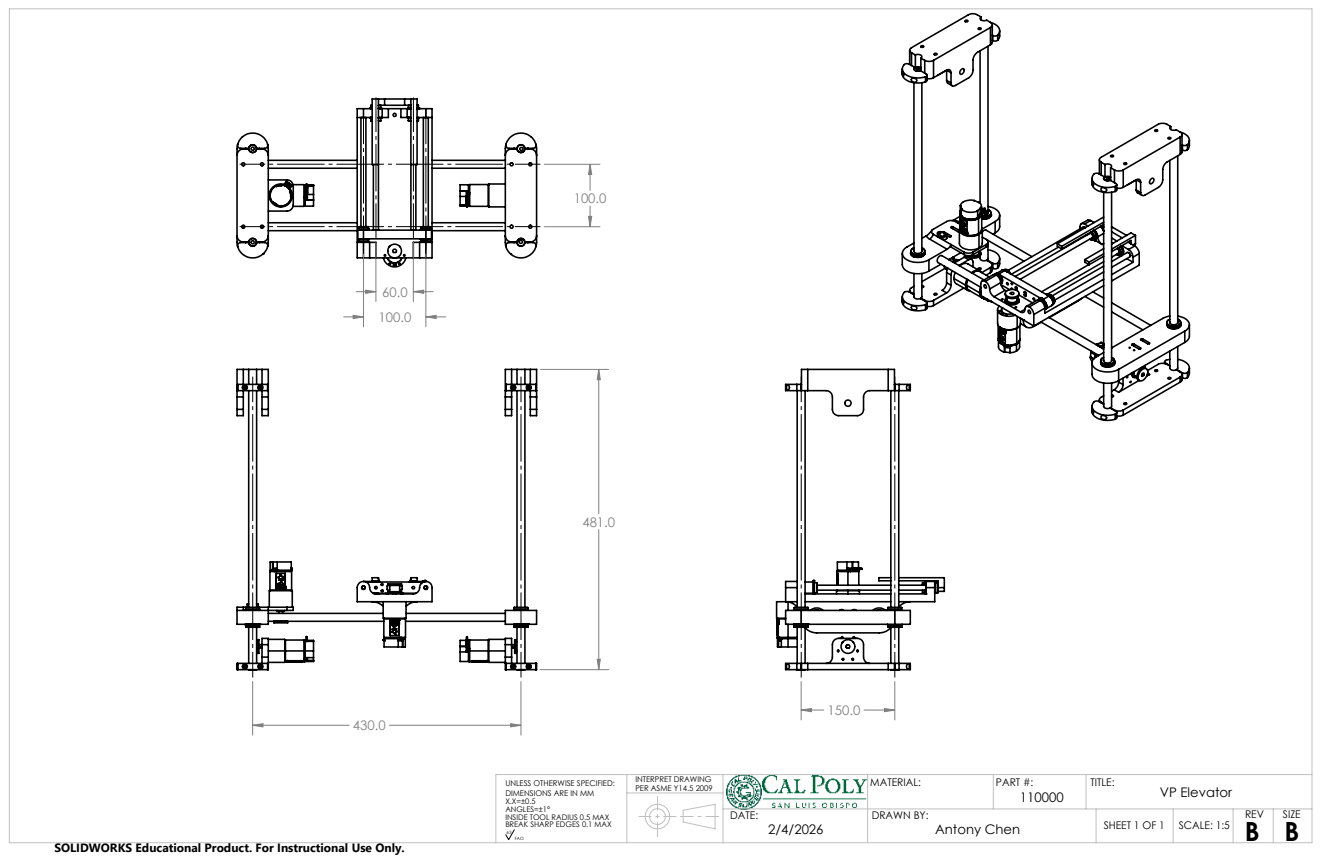
[picture p114: page 3]
Antony Chen; MATERIAL:; TITLE:; INTERPRET DRAWING; PER ASME Y14.5 2009; PART #:; VP Elevator 110000

UNLESS OTHERWISE SPECIFIED:

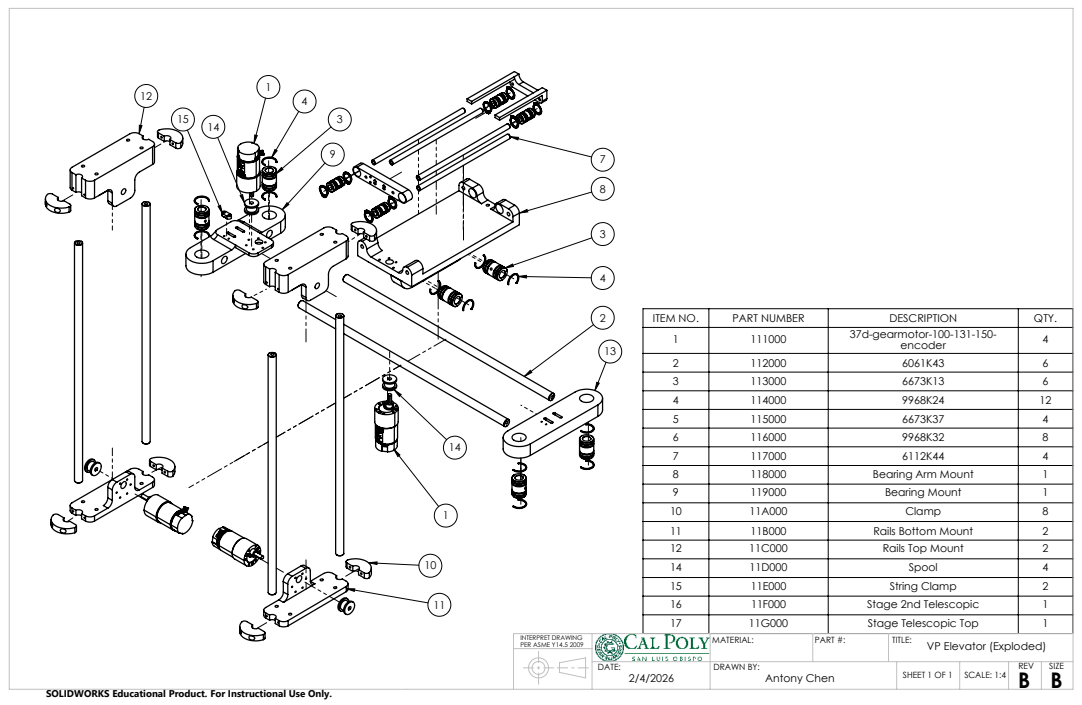
[picture p115: page 4]
Antony Chen; MATERIAL:; TITLE:; INTERPRET DRAWING; PER ASME Y14.5 2009; PART #:; VP Elevator (Exploded)

ITEM NO. | PART NUMBER | DESCRIPTION | QTY.
1 | 111000 | 37d-gearmotor-100-131-150-encoder | 4

2 | 112000 | 6061K43 | 6
3 | 113000 | 6673K13 | 6
4 | 114000 | 9968K24 | 12
5 | 115000 | 6673K37 | 4
6 | 116000 | 9968K32 | 8
7 | 117000 | 6112K44 | 4
8 | 118000 | Bearing Arm Mount | 1
9 | 119000 | Bearing Mount | 1
10 | 11A000 | Clamp | 8
11 | 11B000 | Rails Bottom Mount | 2
12 | 11C000 | Rails Top Mount | 2
14 | 11D000 | Spool | 4
15 | 11E000 | String Clamp | 2
16 | 11F000 | Stage 2nd Telescopic | 1
17 | 11G000 | Stage Telescopic Top | 1

SHEET 1 OF 1 SCALE: 1:4

1566 Carbon Steel; Antony Chen; MATERIAL:; TITLE:; SCALE: 2:3; INTERPRET DRAWING; PER ASME Y14.5 2009; PART #:; 6061K43_Linear Motion Shaft

UNLESS OTHERWISE SPECIFIED:

1566 Carbon Steel; MATERIAL:; TITLE:; SCALE: 3:2; INTERPRET DRAWING; PER ASME Y14.5 2009; PART #:; 6112K44_Linear Motion Shaft

UNLESS OTHERWISE SPECIFIED:

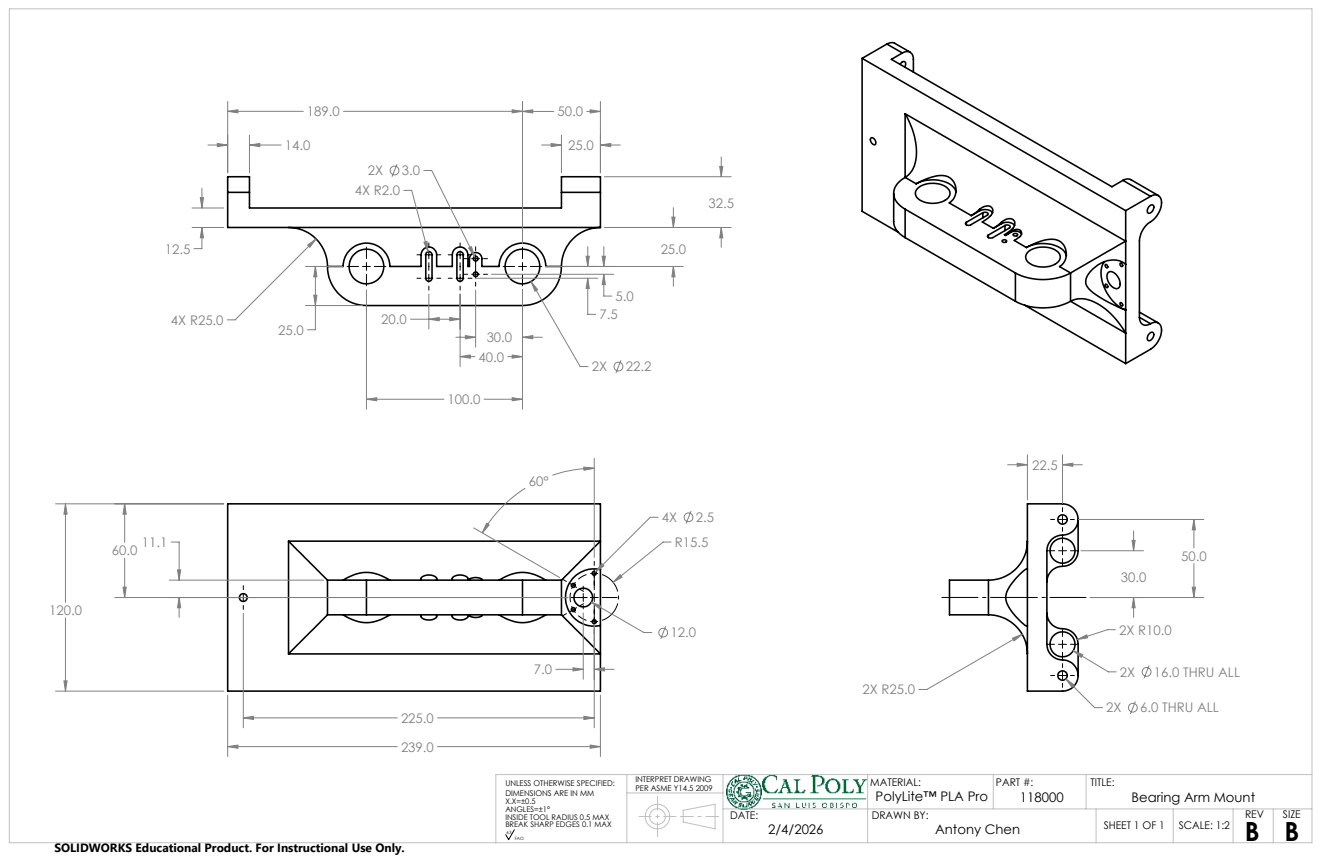
[picture p116: page 7]
2X 16.0 THRU ALL; 2X 6.0 THRU ALL; TITLE:; INTERPRET DRAWING; PER ASME Y14.5 2009; PART #:; Bearing Arm Mount

UNLESS OTHERWISE SPECIFIED:

MATERIAL:
PolyLite™ PLA Pro

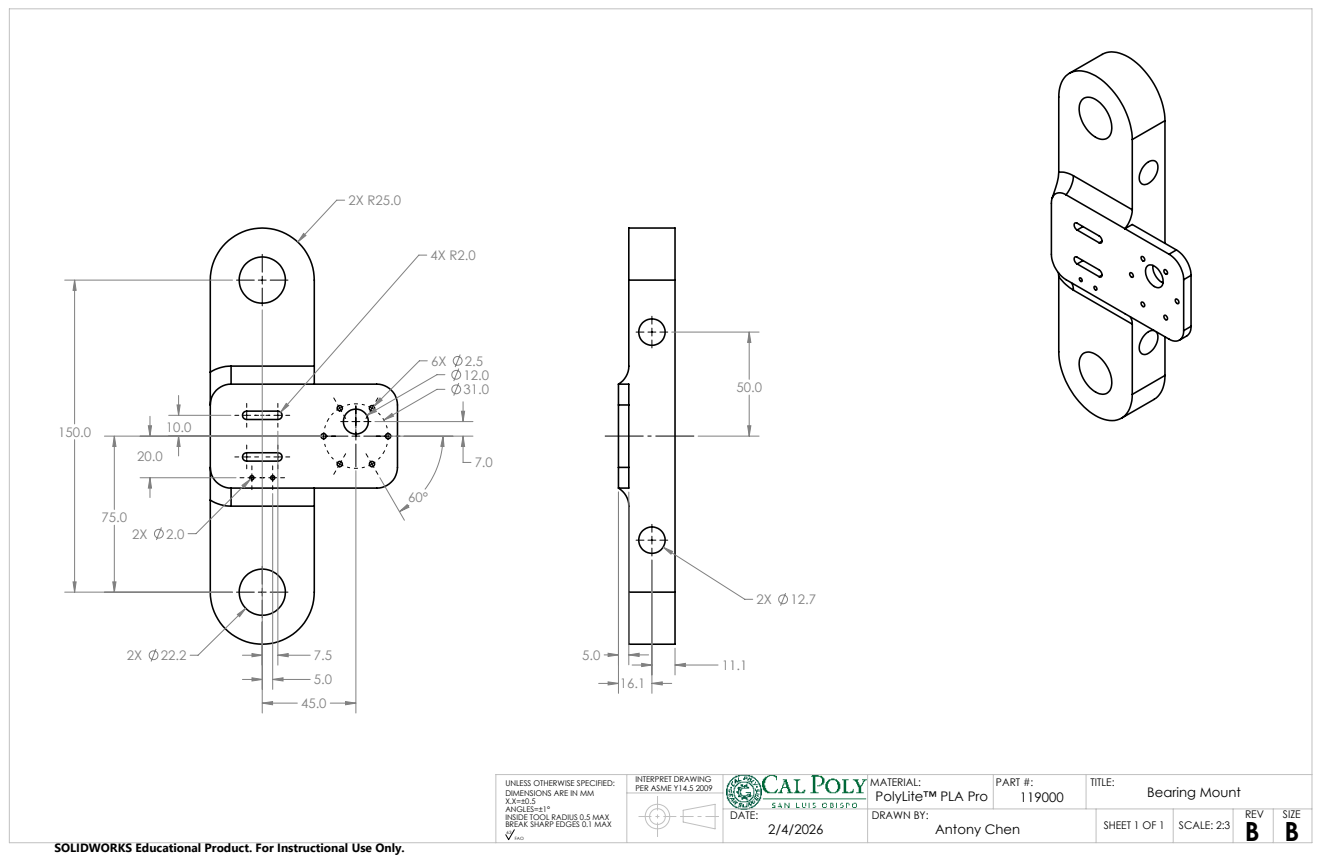
[picture p117: page 8]
MATERIAL:; TITLE:; SCALE: 2:3; INTERPRET DRAWING; PER ASME Y14.5 2009; PART #:; Bearing Mount

UNLESS OTHERWISE SPECIFIED:

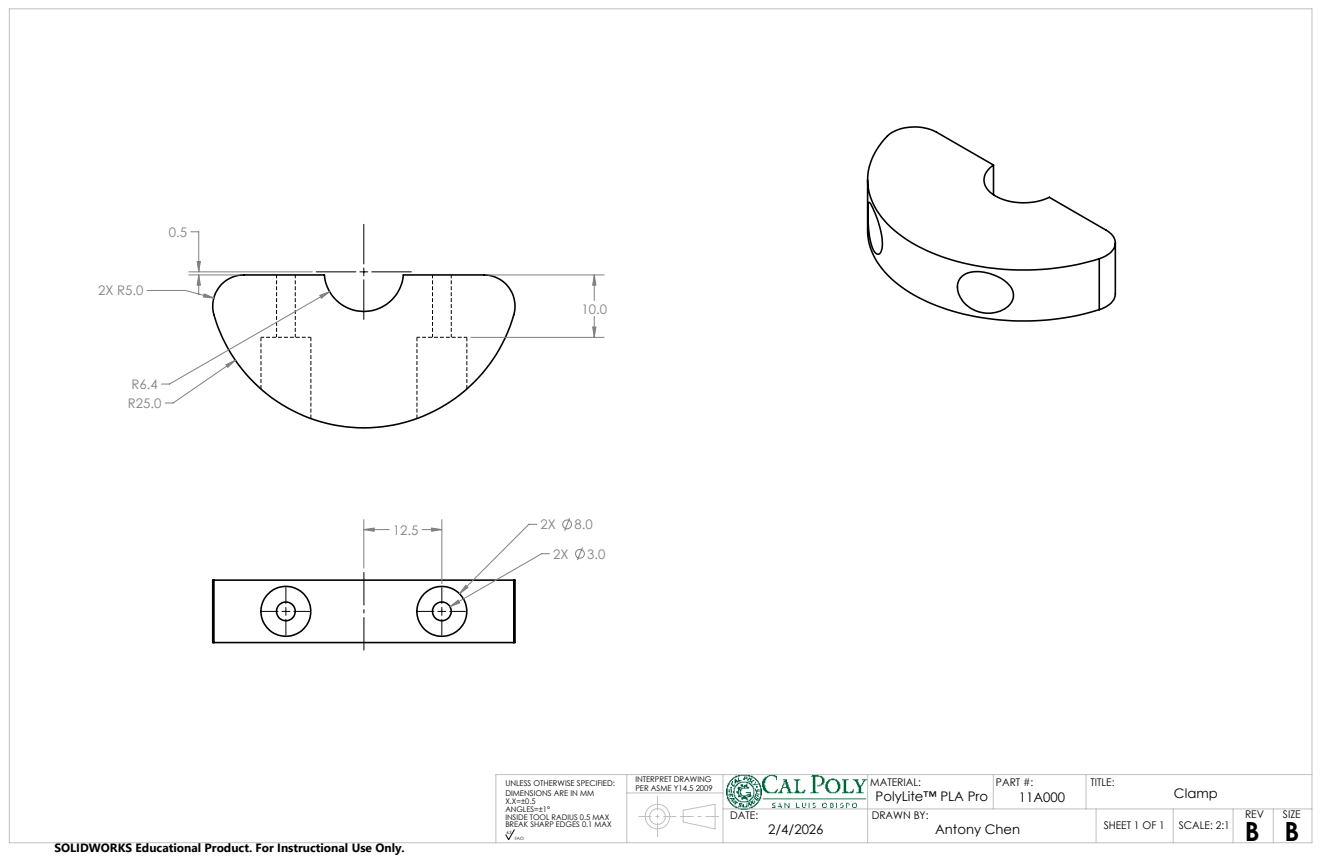
[picture p118: page 9]
MATERIAL:; TITLE:; SCALE: 2:1; INTERPRET DRAWING; PER ASME Y14.5 2009; PART #:; Clamp

UNLESS OTHERWISE SPECIFIED:

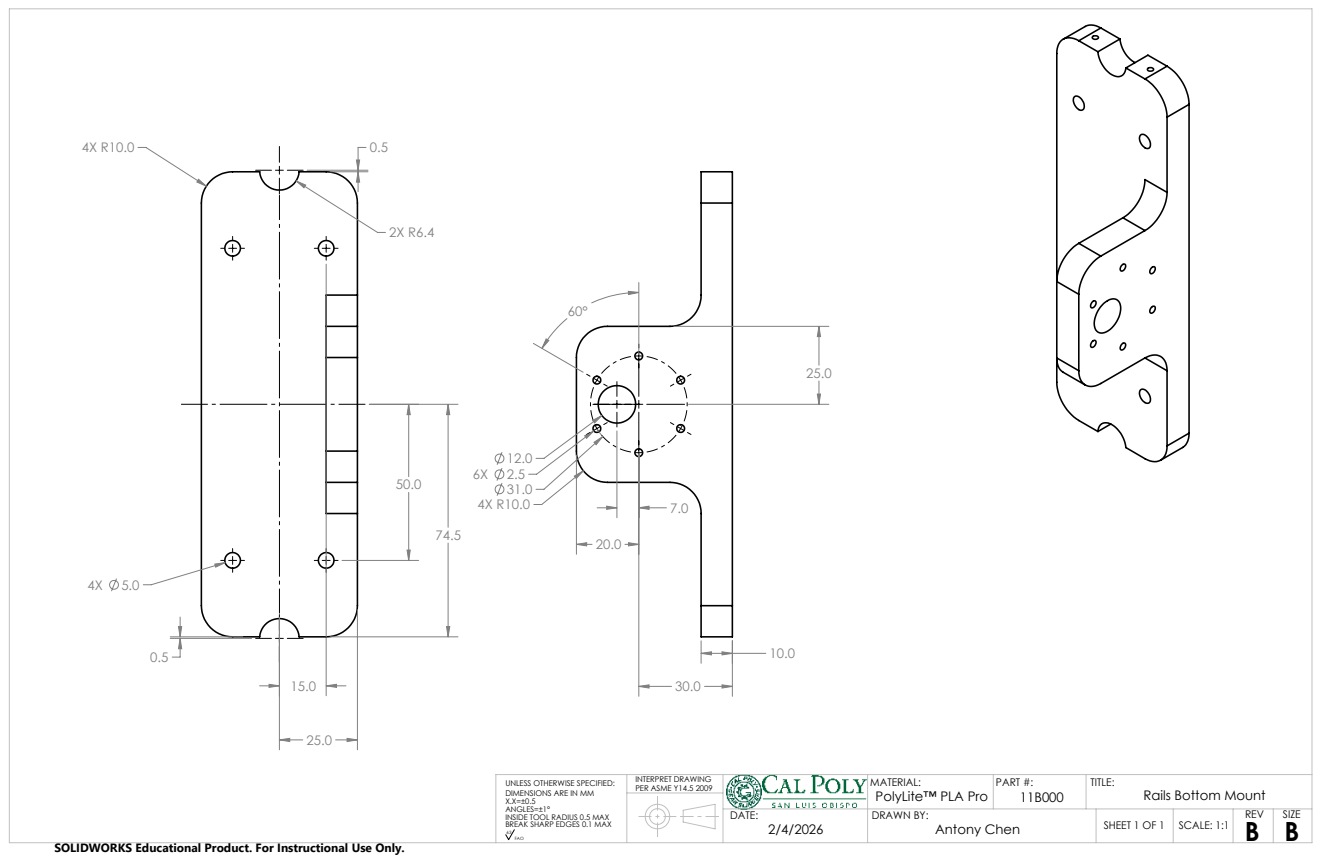
[picture p119: page 10]
MATERIAL:; TITLE:; INTERPRET DRAWING; PER ASME Y14.5 2009; PART #:; Rails Bottom Mount

UNLESS OTHERWISE SPECIFIED:

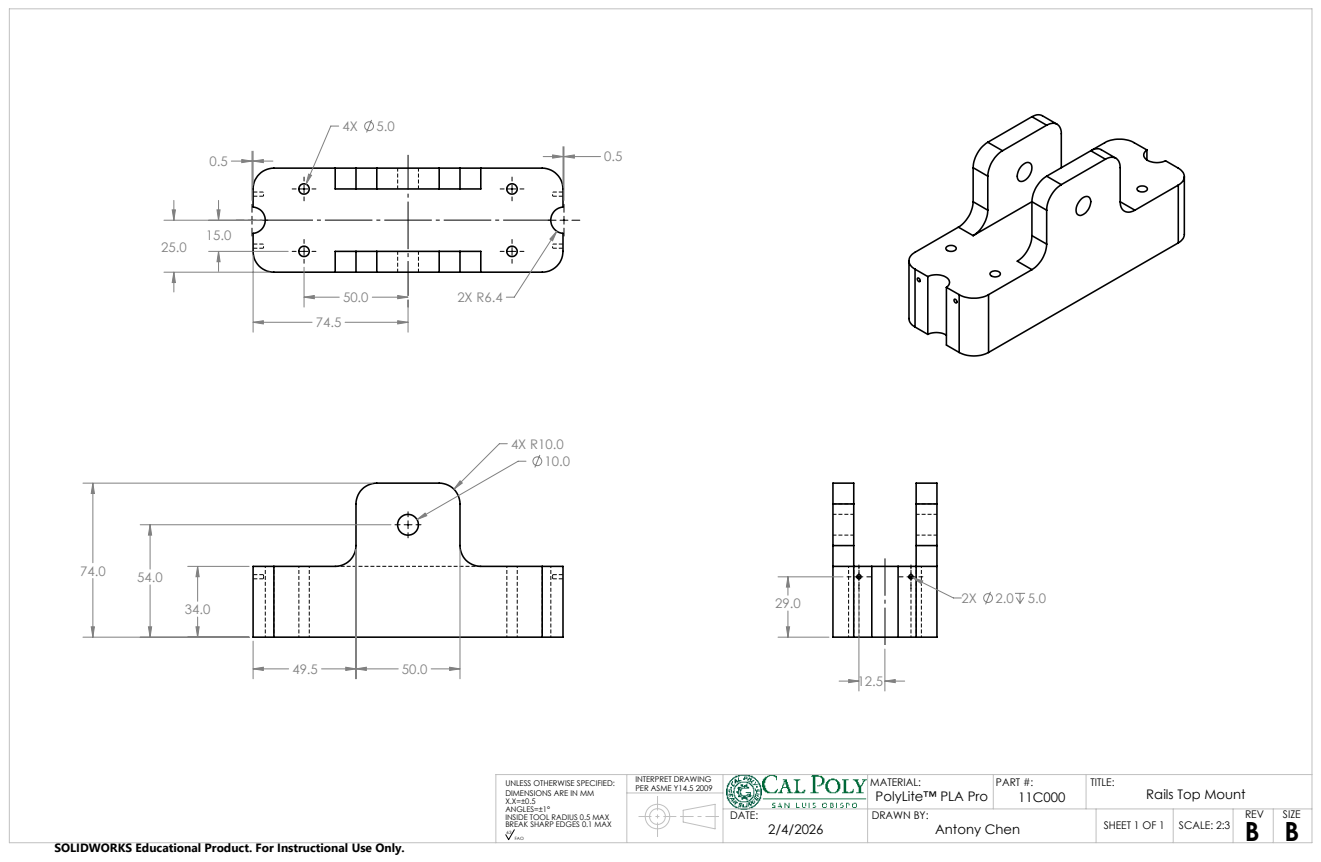
[picture p120: page 11]
MATERIAL:; TITLE:; SCALE: 2:3; INTERPRET DRAWING; PER ASME Y14.5 2009; PART #:; Rails Top Mount

UNLESS OTHERWISE SPECIFIED:

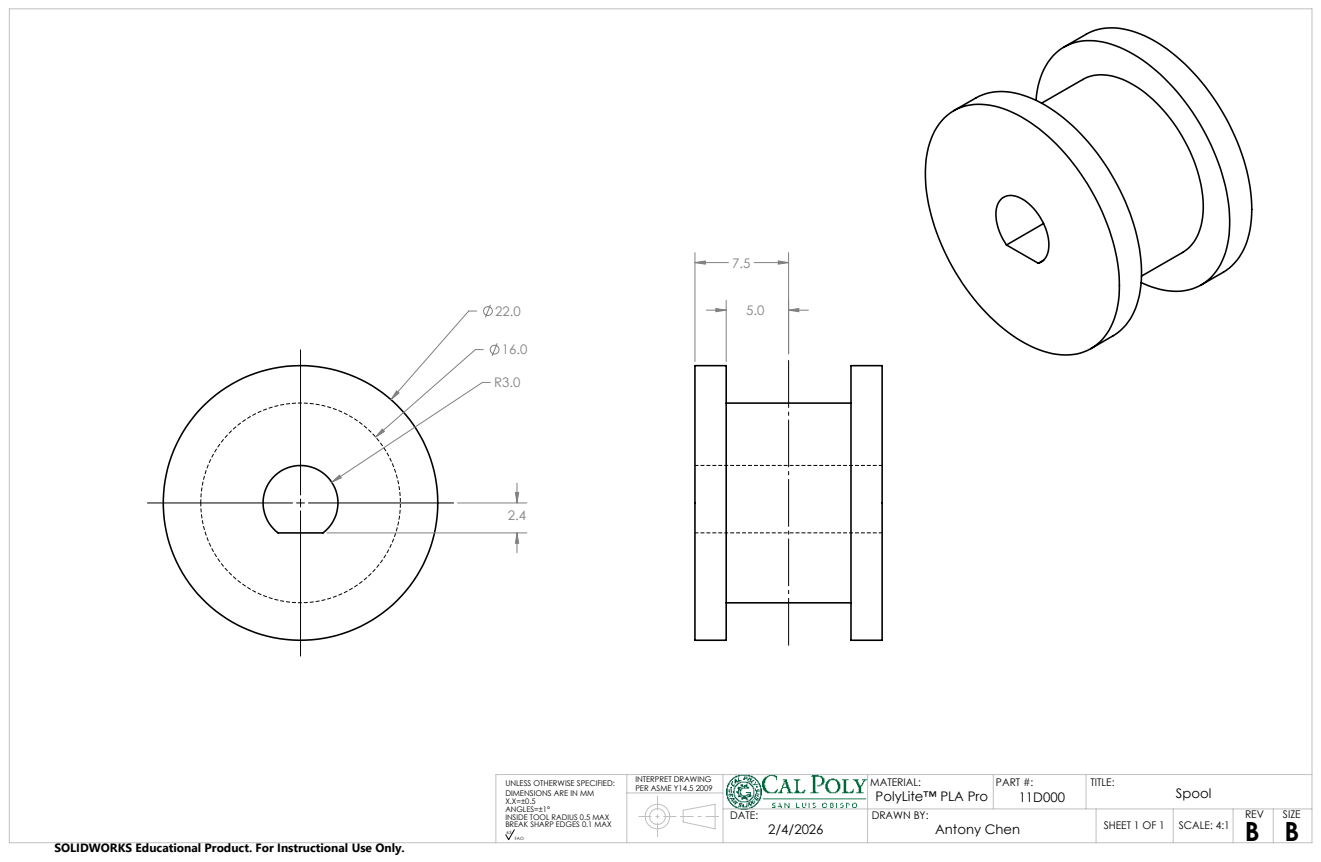
[picture p121: page 12]
MATERIAL:; TITLE:; SCALE: 4:1; INTERPRET DRAWING; PER ASME Y14.5 2009; PART #:; Spool 11D000

UNLESS OTHERWISE SPECIFIED:

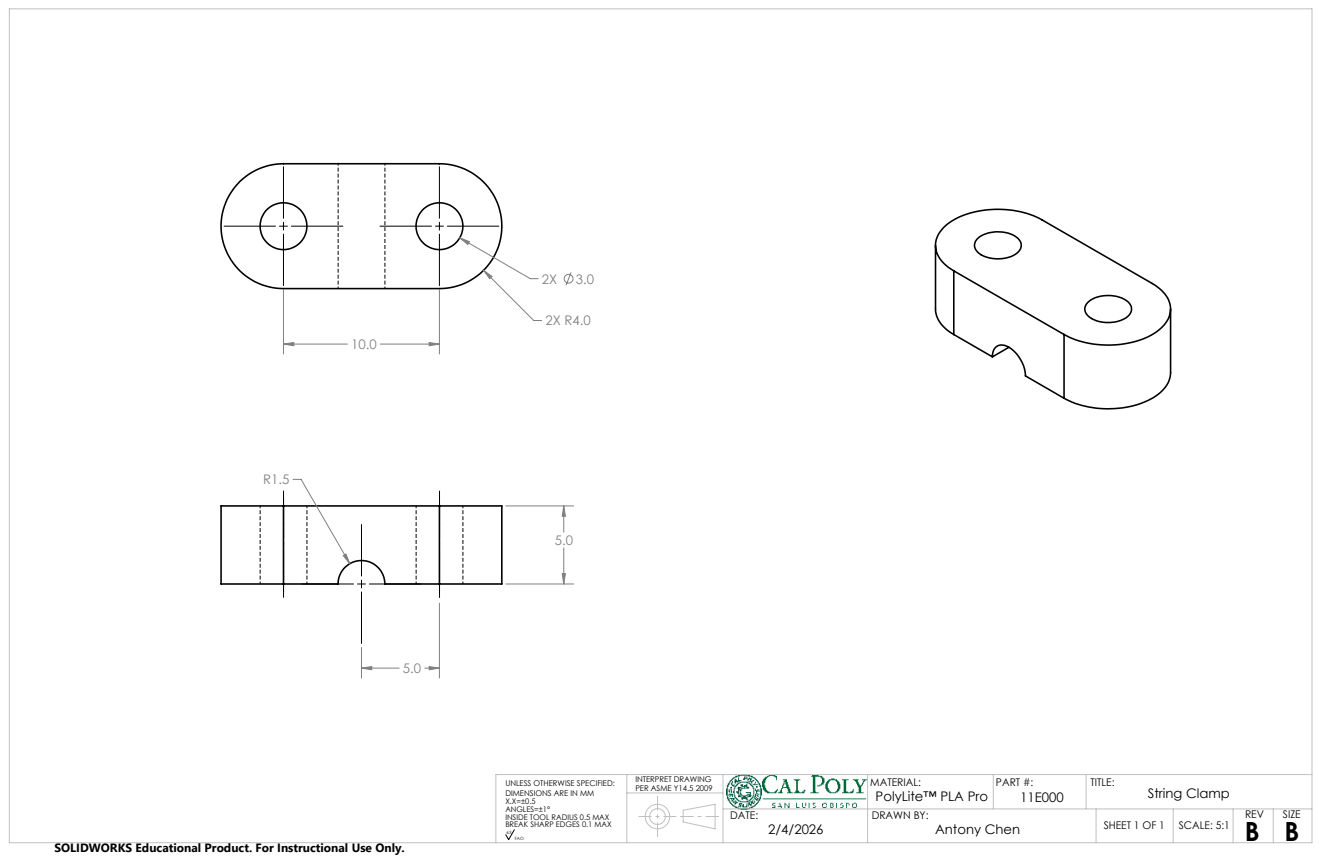
[picture p122: page 13]
MATERIAL:; TITLE:; SCALE: 5:1; INTERPRET DRAWING; PER ASME Y14.5 2009; PART #:; String Clamp 11E000

UNLESS OTHERWISE SPECIFIED:

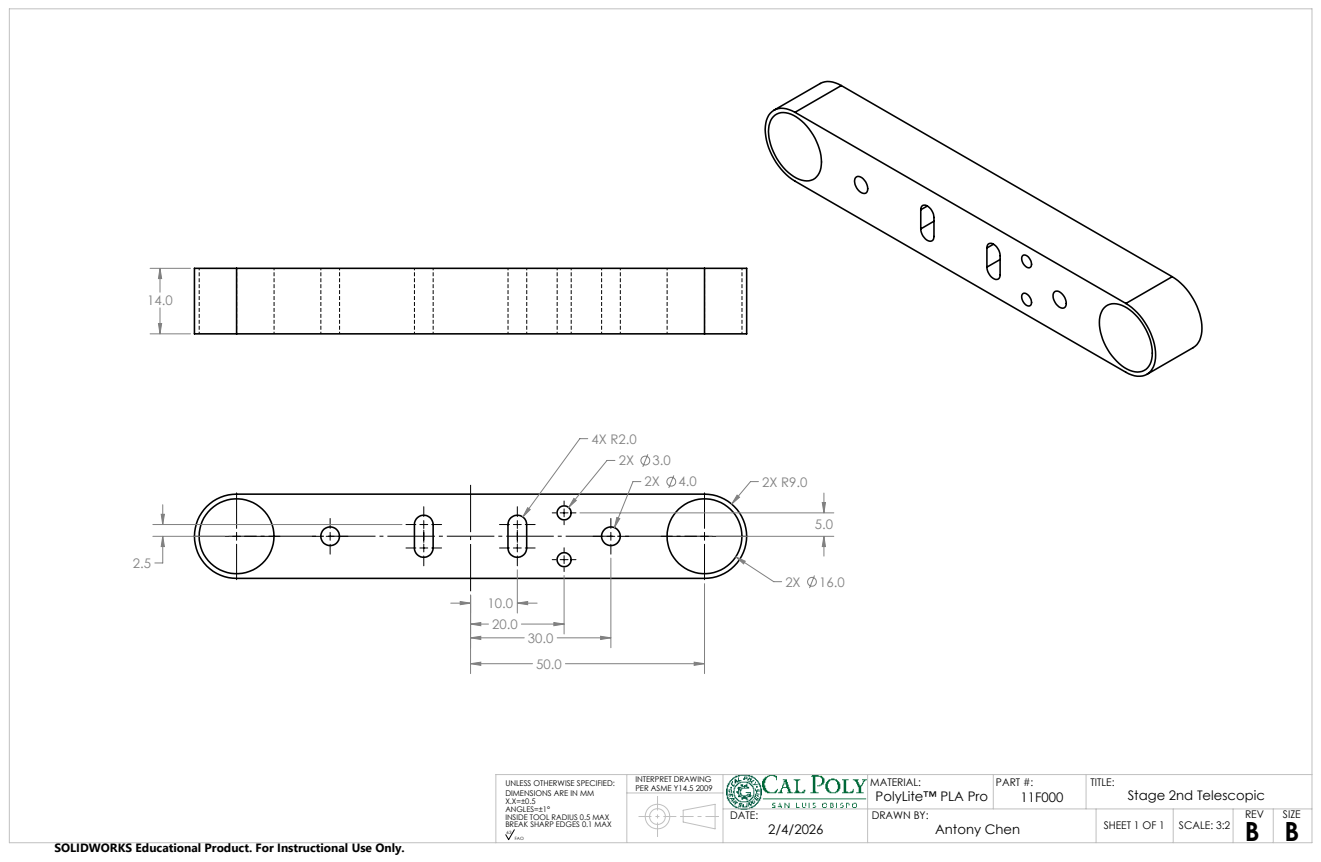
[picture p123: page 14]
MATERIAL:; TITLE:; SCALE: 3:2; INTERPRET DRAWING; PER ASME Y14.5 2009; PART #:; Stage 2nd Telescopic

UNLESS OTHERWISE SPECIFIED:

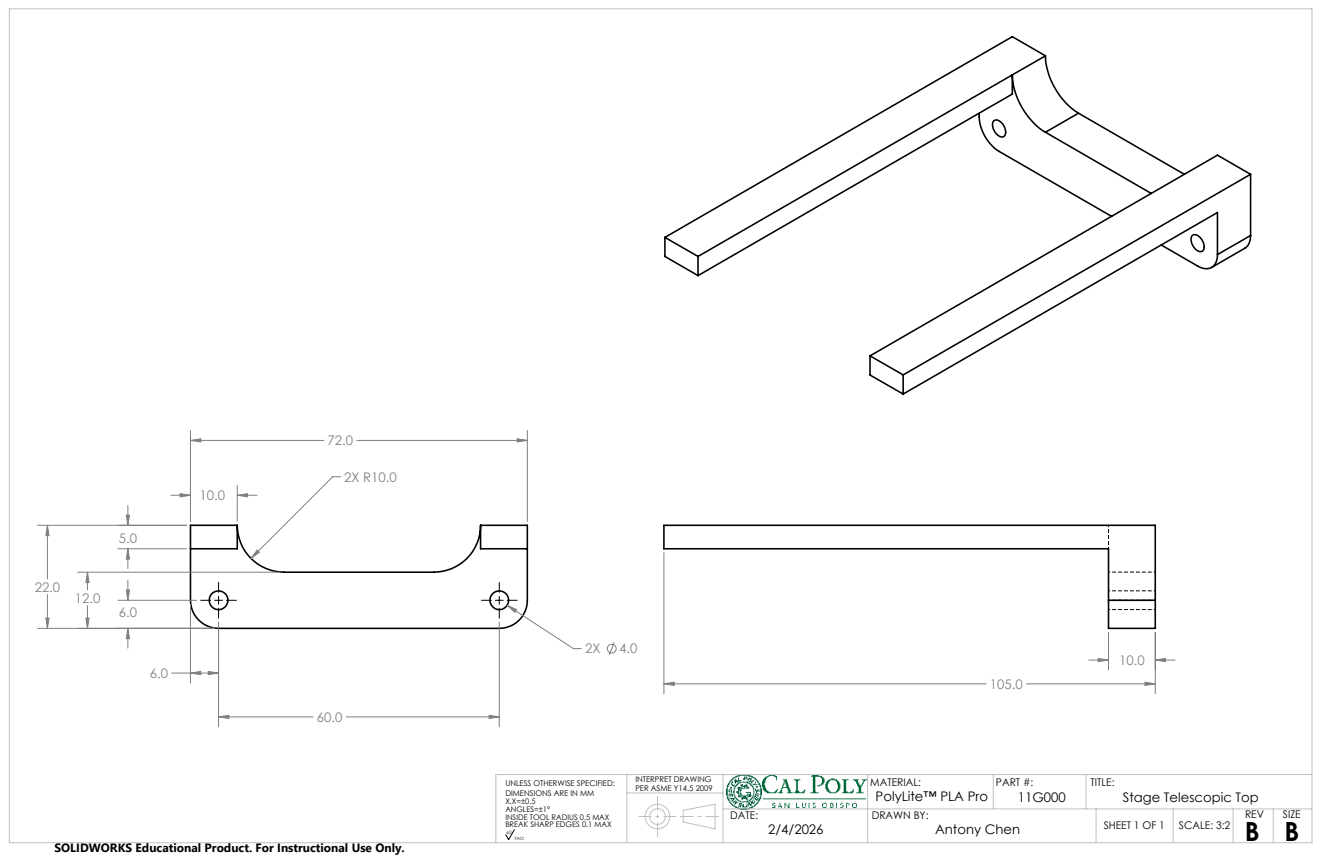
[picture p124: page 15]
MATERIAL:; TITLE:; SCALE: 3:2; INTERPRET DRAWING; PER ASME Y14.5 2009; PART #:; Stage Telescopic Top

UNLESS OTHERWISE SPECIFIED:

Plywood; MATERIAL:; TITLE:; INTERPRET DRAWING; PER ASME Y14.5 2009; PART #:; Body Wall

UNLESS OTHERWISE SPECIFIED:

Plywood; MATERIAL:; TITLE:; INTERPRET DRAWING; PER ASME Y14.5 2009; PART #:; Body Plate

UNLESS OTHERWISE SPECIFIED:

Plywood; MATERIAL:; TITLE:; INTERPRET DRAWING; PER ASME Y14.5 2009; PART #:; shelf plate

UNLESS OTHERWISE SPECIFIED:

Plywood; MATERIAL:; TITLE:; INTERPRET DRAWING; PER ASME Y14.5 2009; PART #:; shelf wall

UNLESS OTHERWISE SPECIFIED:
