AntonyC03S/NASA_RASC-AL/VP Collection Rover/Frame/plywood-1.PDF

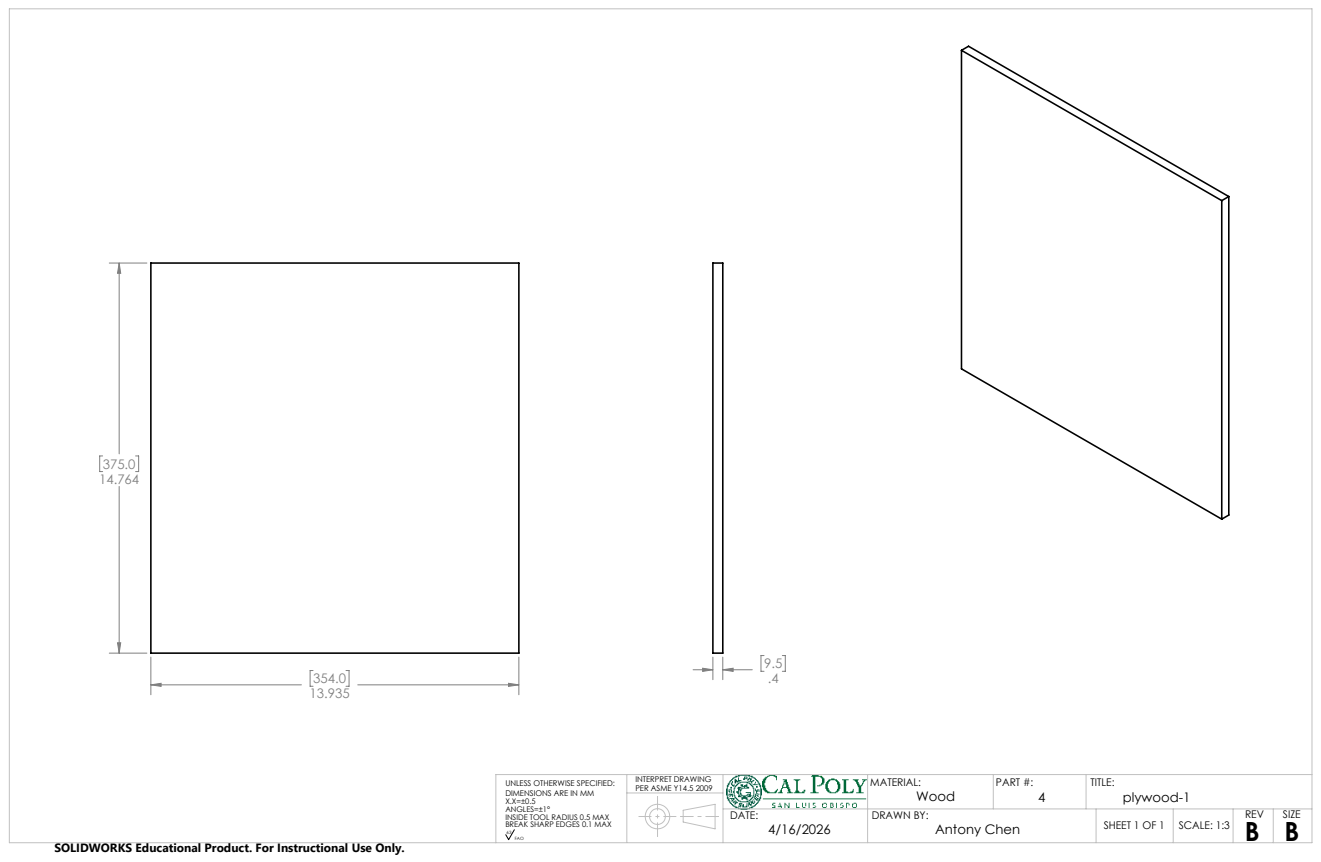
[picture p125: page 1]
Antony Chen; DRAWN BY:; SCALE: 1:3; SHEET 1 OF 1; INTERPRET DRAWING; PER ASME Y14.5 2009; PART #:

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

SOLIDWORKS Educational Product. For Instructional Use Only.
