AntonyC03S/NASA_RASC-AL/VP Collection Rover/Frame/Shelf.PDF

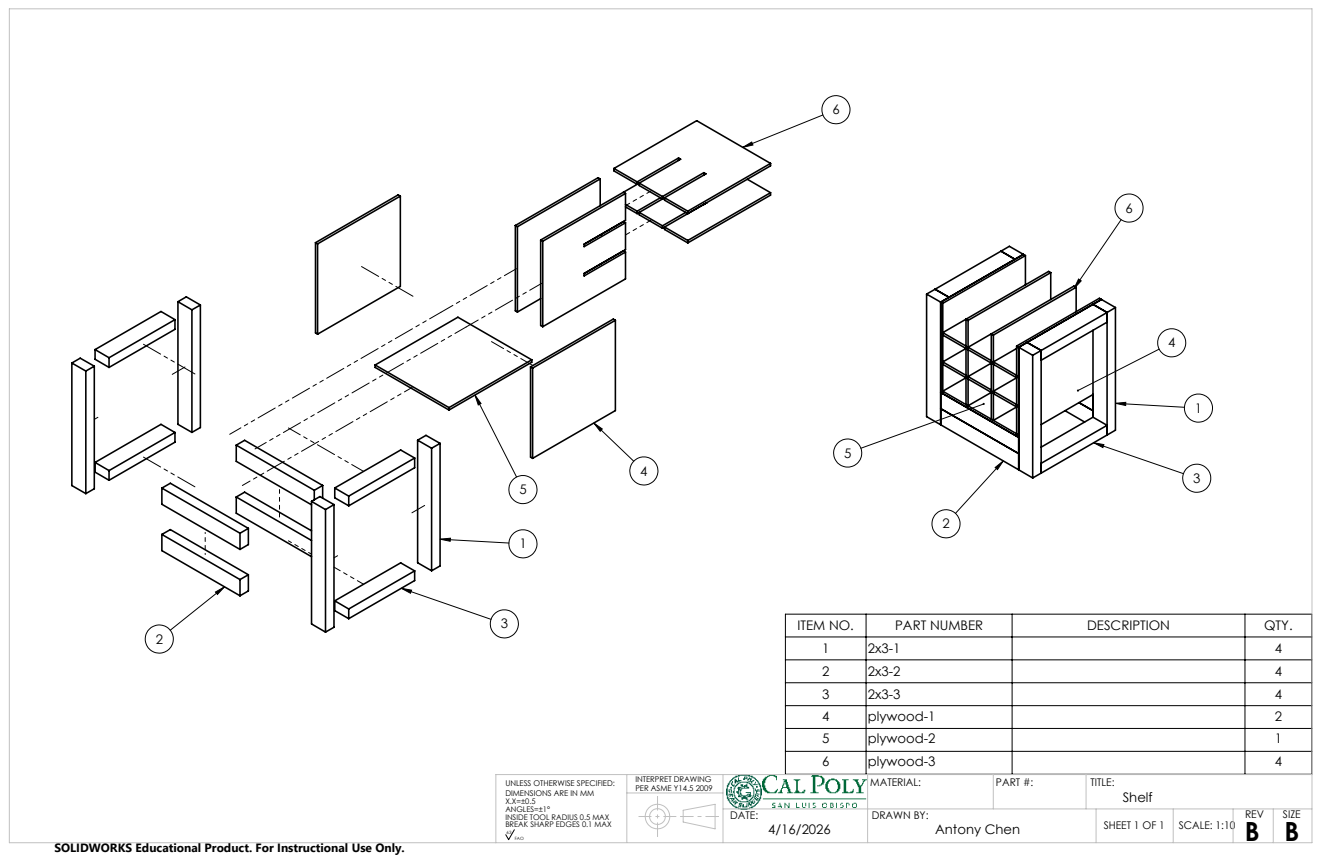
[picture p126: page 1]
Antony Chen; DRAWN BY:; SCALE: 1:10; SHEET 1 OF 1; INTERPRET DRAWING; PER ASME Y14.5 2009; PART #:

ITEM NO. | PART NUMBER | DESCRIPTION | QTY.
1 | 2x3-1 | | 4
2 | 2x3-2 | | 4
3 | 2x3-3 | | 4
4 | plywood-1 | | 2
5 | plywood-2 | | 1
6 | plywood-3 | | 4

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

SOLIDWORKS Educational Product. For Instructional Use Only.
