AntonyC03S/NASA_RASC-AL/VP Collection Rover/Old Drawing/Bearing Arm Mount.PDF

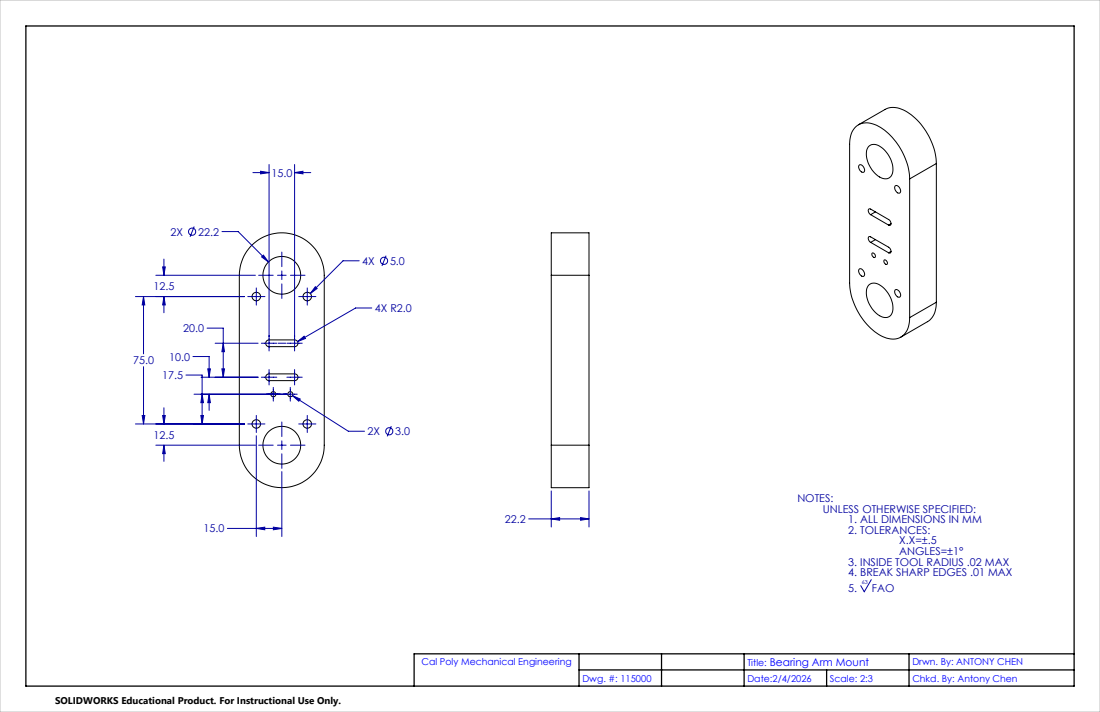
[picture p127: page 1]

NOTES:
UNLESS OTHERWISE SPECIFIED:
1. ALL DIMENSIONS IN MM
2. TOLERANCES:

3. INSIDE TOOL RADIUS .02 MAX
4. BREAK SHARP EDGES .01 MAX
5. 63 FAO

Cal Poly Mechanical Engineering | | Title: Bearing Arm Mount | Drwn. By: ANTONY CHEN

Dwg. #: 115000 | Date:2/4/2026 | Scale: 2:3 | Chkd. By: Antony Chen

SOLIDWORKS Educational Product. For Instructional Use Only.
