AntonyC03S/NASA_RASC-AL/VP Collection Rover/Old Drawing/Drawing Packages.pdf

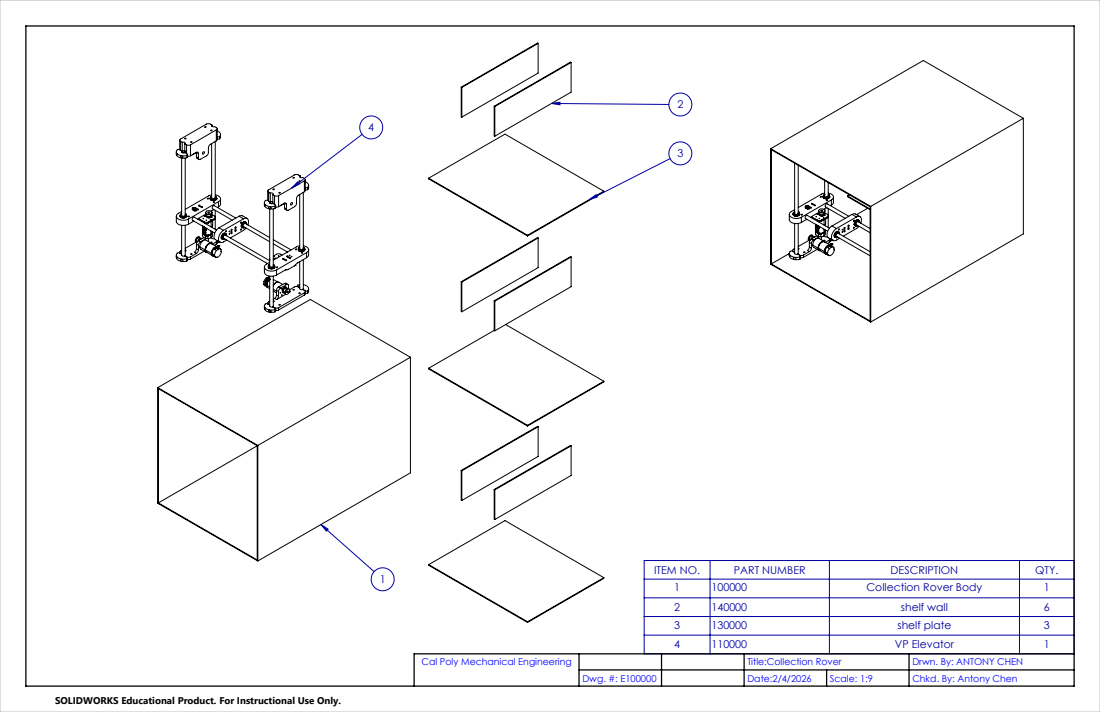
[picture p128: page 1]

ITEM NO. | PART NUMBER | DESCRIPTION | QTY.
1 | 100000 | Collection Rover Body | 1
2 | 140000 | shelf wall | 6
3 | 130000 | shelf plate | 3
4 | 110000 | VP Elevator | 1

Cal Poly Mechanical Engineering | | | Title:Collection Rover | Drwn. By: ANTONY CHEN

Dwg. #: E100000 | | Date:2/4/2026 | Scale: 1:9 | Chkd. By: Antony Chen

SOLIDWORKS Educational Product. For Instructional Use Only.

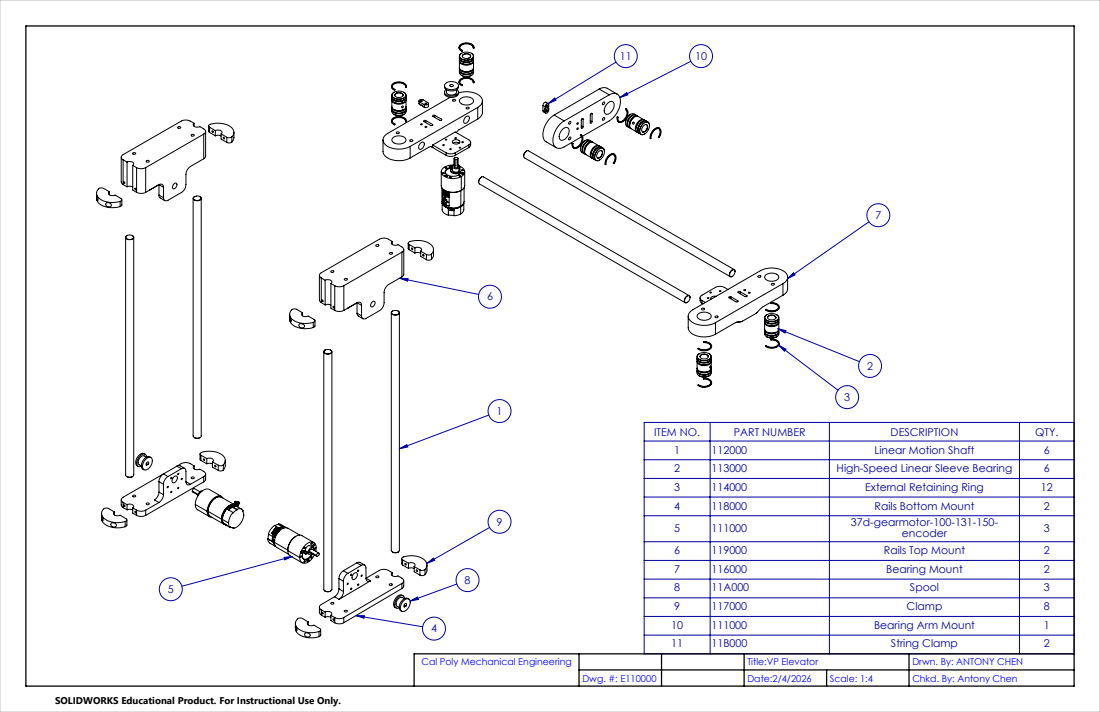
[picture p129: page 2]

ITEM NO. | PART NUMBER | DESCRIPTION | QTY.
1 | 112000 | Linear Motion Shaft | 6
2 | 113000 | High-Speed Linear Sleeve Bearing | 6
3 | 114000 | External Retaining Ring | 12
4 | 118000 | Rails Bottom Mount | 2
5 | 111000 | 37d-gearmotor-100-131-150-encoder | 3
6 | 119000 | Rails Top Mount | 2
7 | 116000 | Bearing Mount | 2
8 | 11A000 | Spool | 3
9 | 117000 | Clamp | 8
10 | 111000 | Bearing Arm Mount | 1
11 | 11B000 | String Clamp | 2

Title:VP Elevator | Drwn. By: ANTONY CHEN

Dwg. #: E110000 | | Date:2/4/2026 | | Chkd. By: Antony Chen

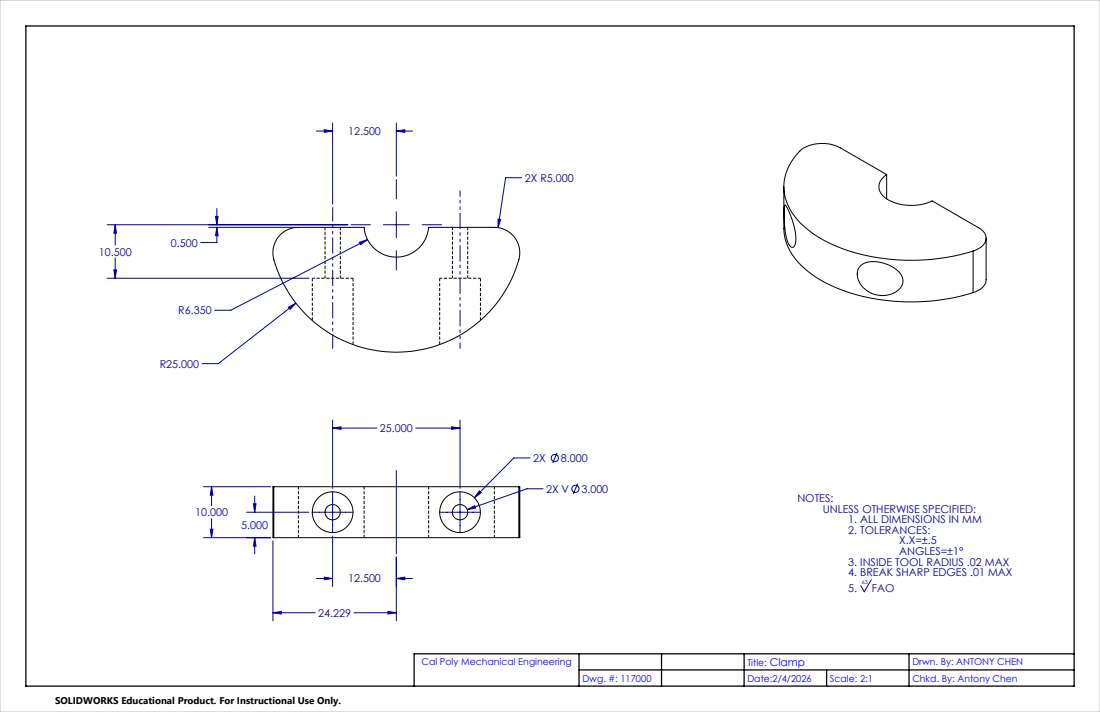
[picture p130: page 3]
X.X=±.5 ANGLES=±1°

NOTES:
UNLESS OTHERWISE SPECIFIED:
1. ALL DIMENSIONS IN MM
2. TOLERANCES:

3. INSIDE TOOL RADIUS .02 MAX
4. BREAK SHARP EDGES .01 MAX
5. 63 FAO

Title: Clamp | Drwn. By: ANTONY CHEN

Dwg. #: 117000 | Date:2/4/2026 | Scale: 2:1 | Chkd. By: Antony Chen

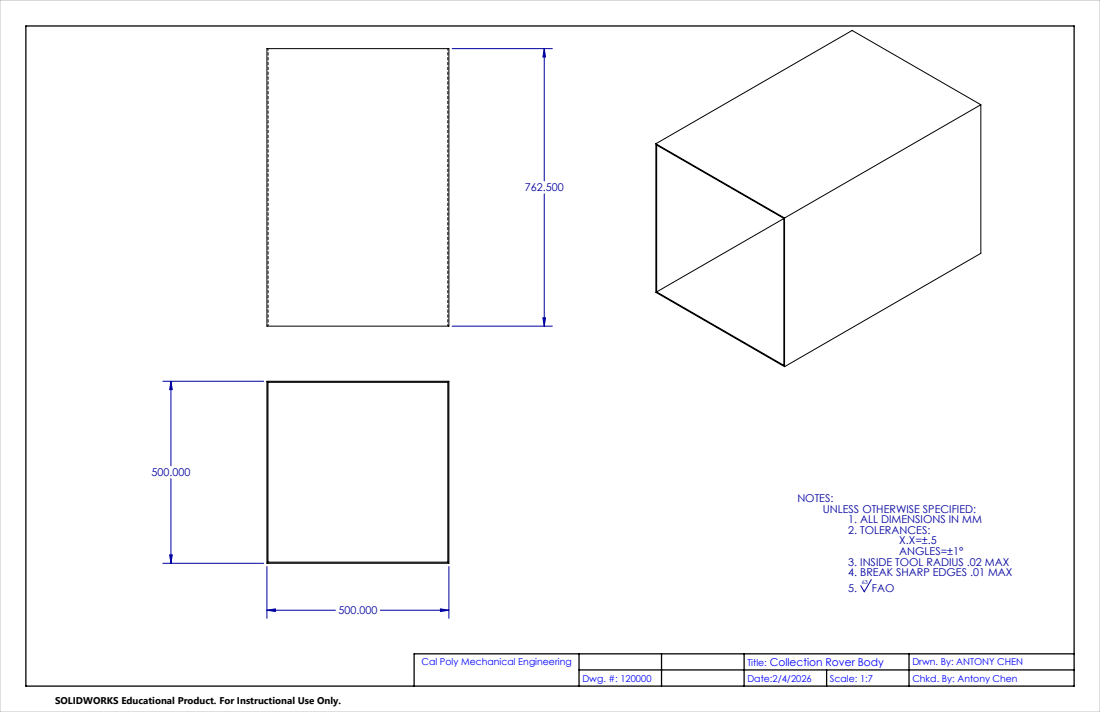
[picture p131: page 4]
X.X=±.5 ANGLES=±1°

NOTES:
UNLESS OTHERWISE SPECIFIED:
1. ALL DIMENSIONS IN MM
2. TOLERANCES:

3. INSIDE TOOL RADIUS .02 MAX
4. BREAK SHARP EDGES .01 MAX
5. 63 FAO

Title: Collection Rover Body | Drwn. By: ANTONY CHEN

Dwg. #: 120000 | Date:2/4/2026 | | Chkd. By: Antony Chen

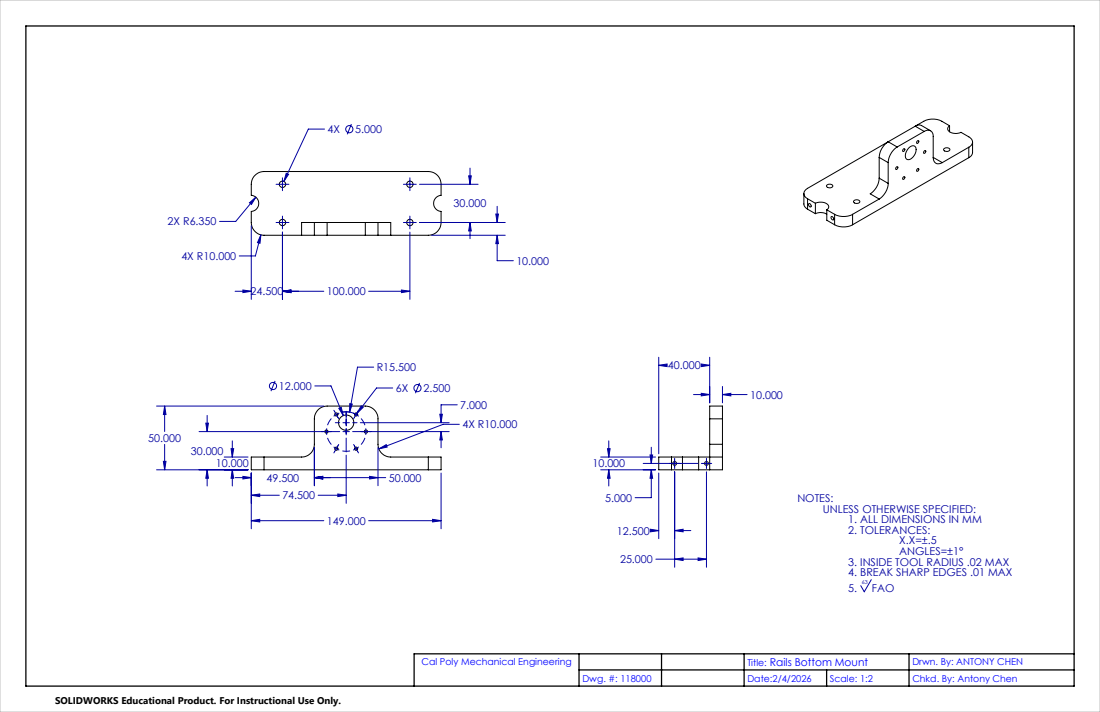
[picture p132: page 5]
X.X=±.5 ANGLES=±1°

NOTES:
UNLESS OTHERWISE SPECIFIED:
1. ALL DIMENSIONS IN MM
2. TOLERANCES:

3. INSIDE TOOL RADIUS .02 MAX
4. BREAK SHARP EDGES .01 MAX
5. 63 FAO

Title: Rails Bottom Mount | Drwn. By: ANTONY CHEN

Dwg. #: 118000 | Date:2/4/2026 | | Chkd. By: Antony Chen

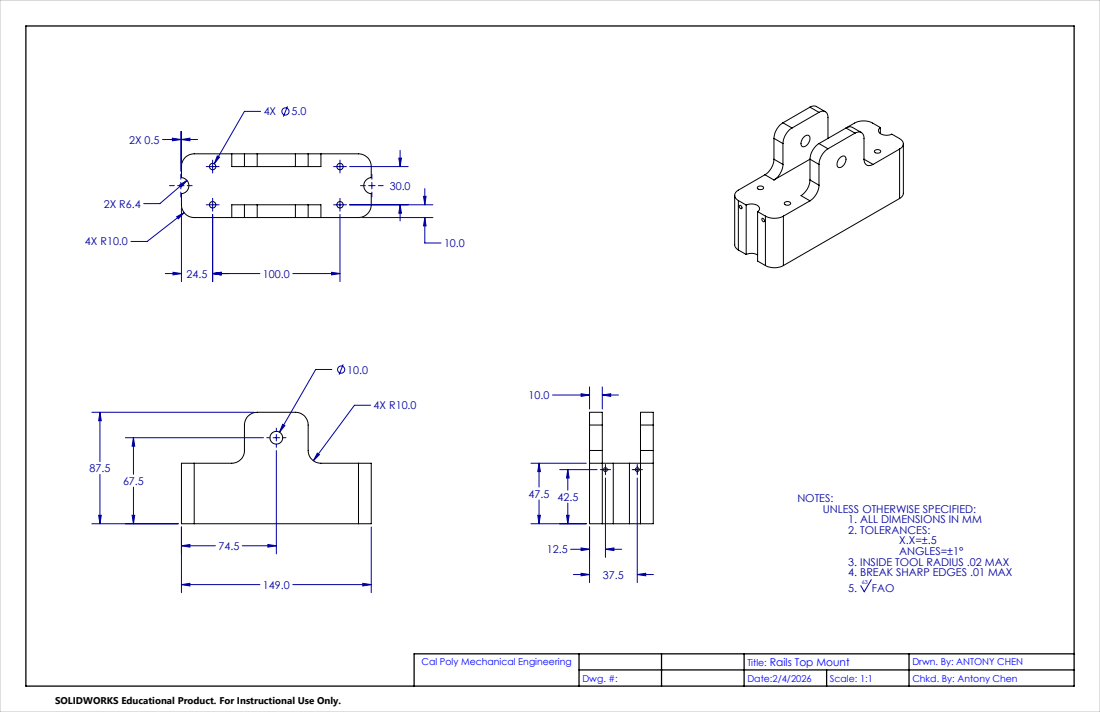
[picture p133: page 6]
X.X=±.5 ANGLES=±1°

NOTES:
UNLESS OTHERWISE SPECIFIED:
1. ALL DIMENSIONS IN MM
2. TOLERANCES:

3. INSIDE TOOL RADIUS .02 MAX
4. BREAK SHARP EDGES .01 MAX
5. 63 FAO

Title: Rails Top Mount | Drwn. By: ANTONY CHEN

Dwg. #: | Date:2/4/2026 | | Chkd. By: Antony Chen

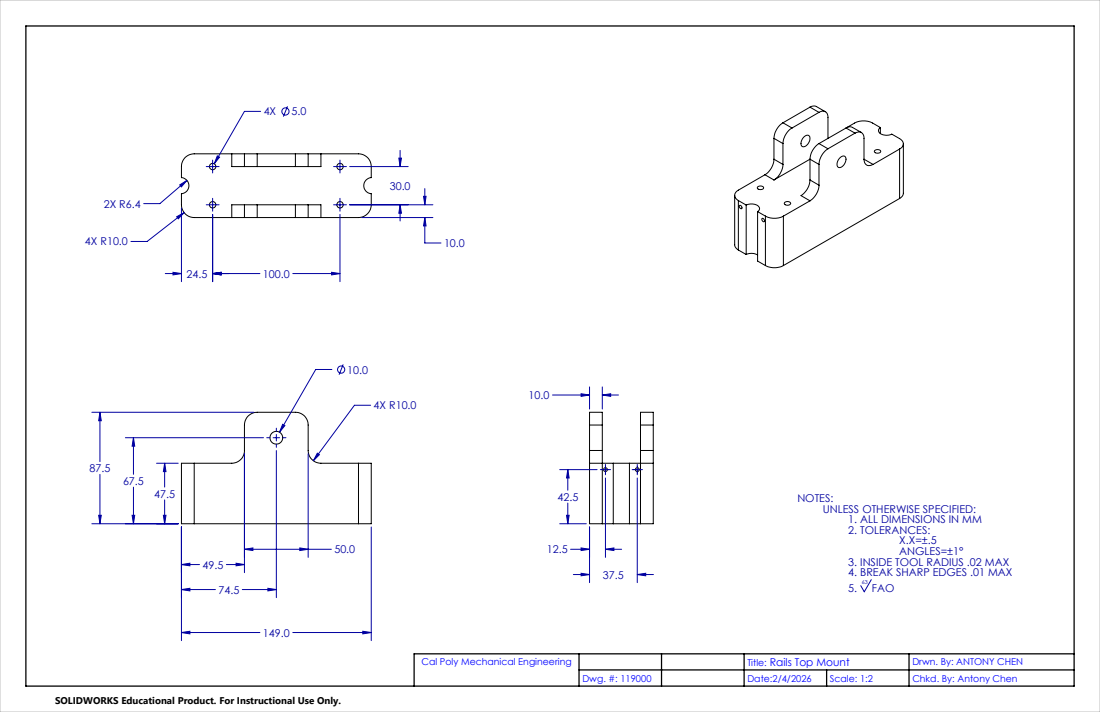
[picture p134: page 7]
X.X=±.5 ANGLES=±1°

NOTES:
UNLESS OTHERWISE SPECIFIED:
1. ALL DIMENSIONS IN MM
2. TOLERANCES:

3. INSIDE TOOL RADIUS .02 MAX
4. BREAK SHARP EDGES .01 MAX
5. 63 FAO

Title: Rails Top Mount | Drwn. By: ANTONY CHEN

Dwg. #: 119000 | Date:2/4/2026 | | Chkd. By: Antony Chen

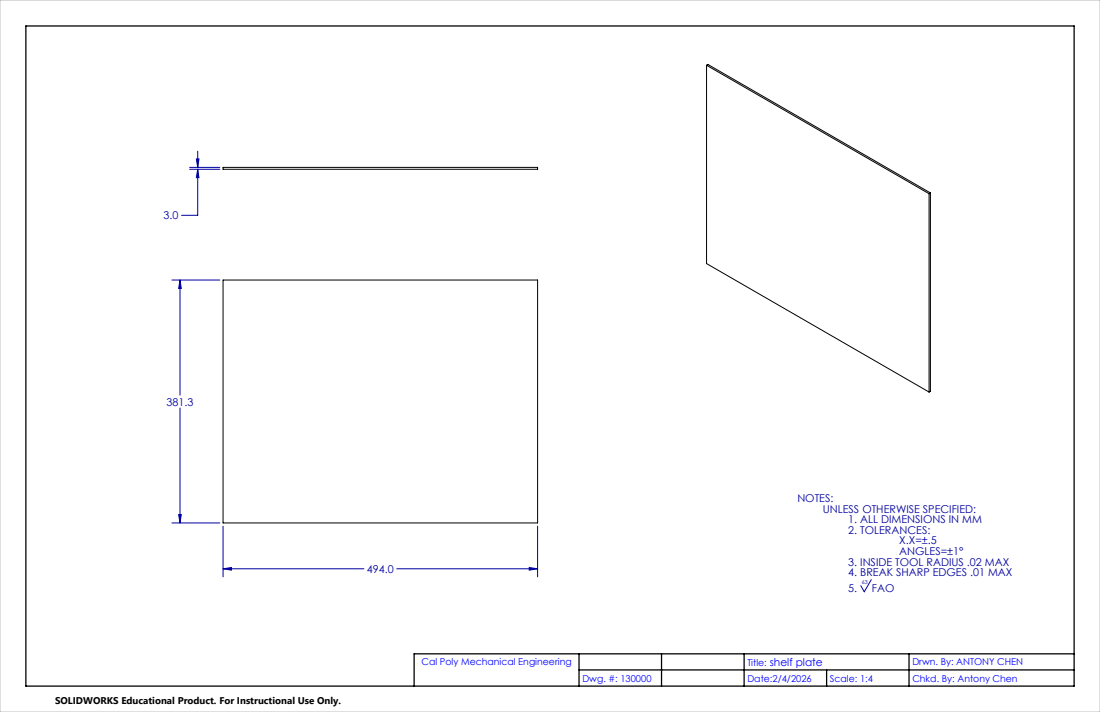
[picture p135: page 8]
X.X=±.5 ANGLES=±1°

NOTES:
UNLESS OTHERWISE SPECIFIED:
1. ALL DIMENSIONS IN MM
2. TOLERANCES:

3. INSIDE TOOL RADIUS .02 MAX
4. BREAK SHARP EDGES .01 MAX
5. 63 FAO

Title: shelf plate | Drwn. By: ANTONY CHEN

Dwg. #: 130000 | Date:2/4/2026 | | Chkd. By: Antony Chen

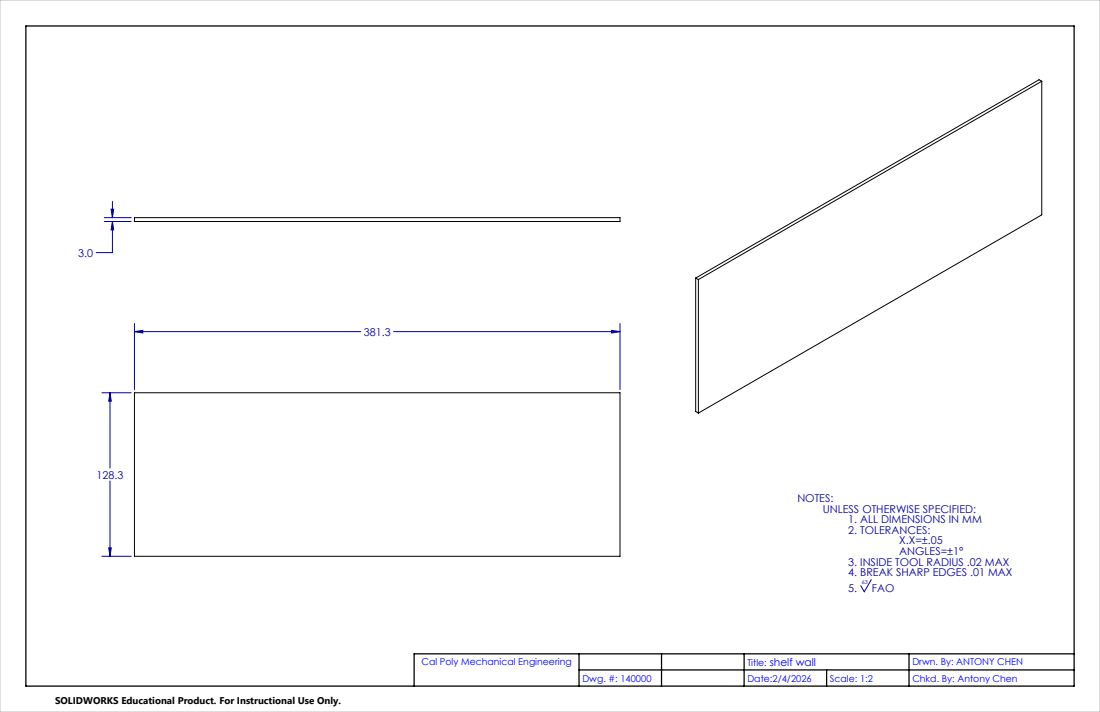
[picture p136: page 9]
X.X=±.05 ANGLES=±1°

NOTES:
UNLESS OTHERWISE SPECIFIED:
1. ALL DIMENSIONS IN MM
2. TOLERANCES:

3. INSIDE TOOL RADIUS .02 MAX
4. BREAK SHARP EDGES .01 MAX
5. 63 FAO

Title: shelf wall | Drwn. By: ANTONY CHEN

Dwg. #: 140000 | Date:2/4/2026 | | Chkd. By: Antony Chen

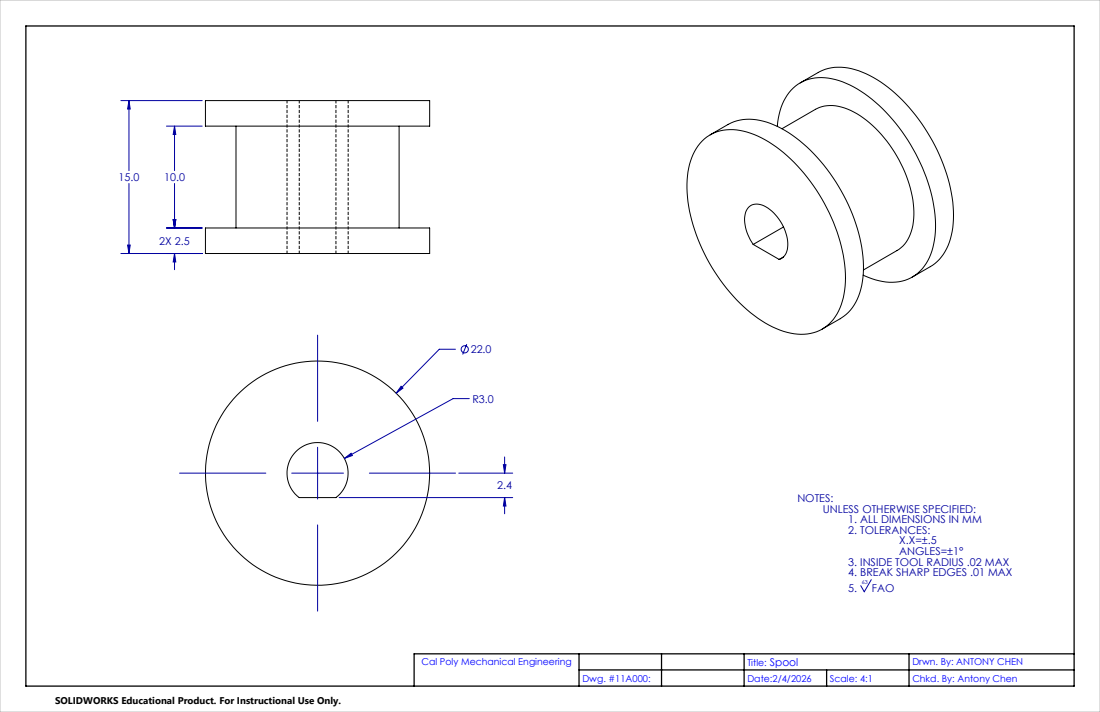
[picture p137: page 10]
X.X=±.5 ANGLES=±1°

NOTES:
UNLESS OTHERWISE SPECIFIED:
1. ALL DIMENSIONS IN MM
2. TOLERANCES:

3. INSIDE TOOL RADIUS .02 MAX
4. BREAK SHARP EDGES .01 MAX
5. 63 FAO

Title: Spool | Drwn. By: ANTONY CHEN

Dwg. #11A000: | Date:2/4/2026 | Scale: 4:1 | Chkd. By: Antony Chen

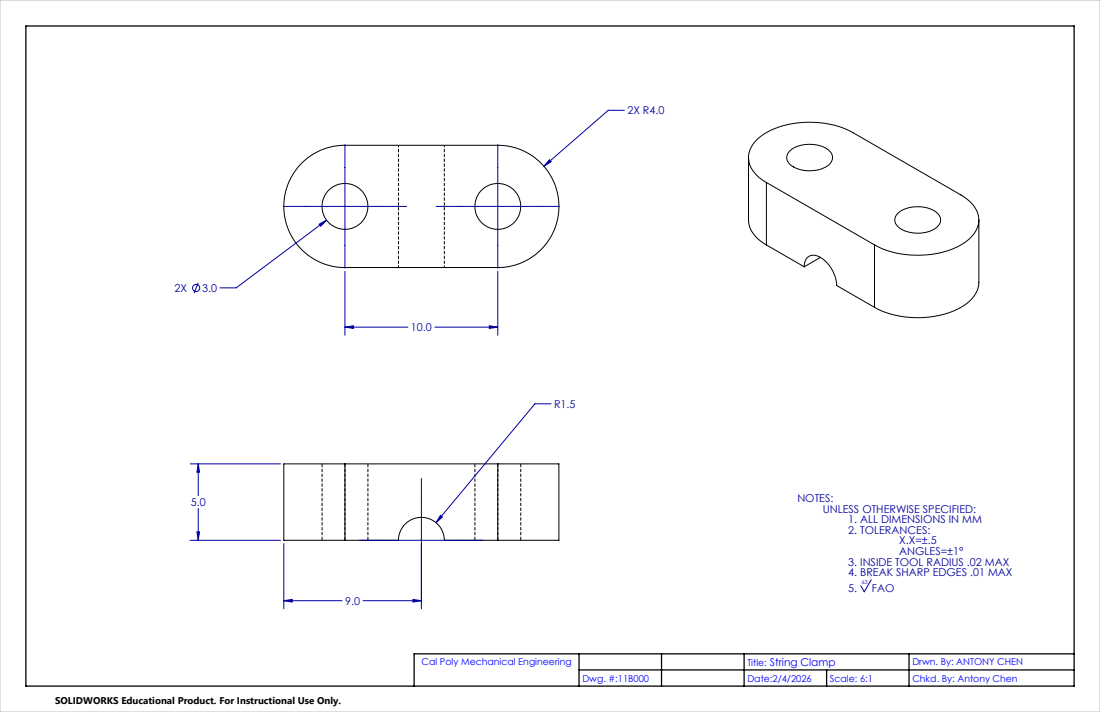
[picture p138: page 11]
X.X=±.5 ANGLES=±1°

NOTES:
UNLESS OTHERWISE SPECIFIED:
1. ALL DIMENSIONS IN MM
2. TOLERANCES:

3. INSIDE TOOL RADIUS .02 MAX
4. BREAK SHARP EDGES .01 MAX
5. 63 FAO

Title: String Clamp | Drwn. By: ANTONY CHEN

Dwg. #:11B000 | Date:2/4/2026 | Scale: 6:1 | Chkd. By: Antony Chen

X.X=±.5 ANGLES=±1°

NOTES:
UNLESS OTHERWISE SPECIFIED:
1. ALL DIMENSIONS IN MM
2. TOLERANCES:

3. INSIDE TOOL RADIUS .02 MAX
4. BREAK SHARP EDGES .01 MAX
5. 63 FAO

Title: Bearing Arm Mount | Drwn. By: ANTONY CHEN

Dwg. #: 115000 | Date:2/4/2026 | Scale: 2:3 | Chkd. By: Antony Chen

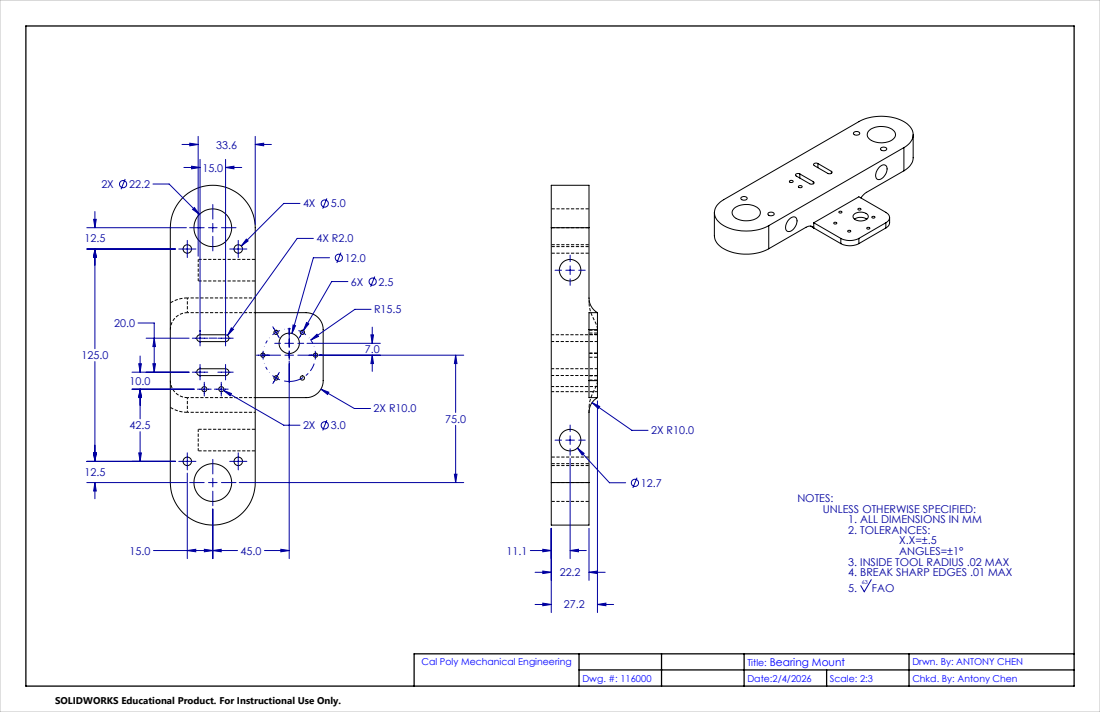
[picture p139: page 13]
X.X=±.5 ANGLES=±1°

NOTES:
UNLESS OTHERWISE SPECIFIED:
1. ALL DIMENSIONS IN MM
2. TOLERANCES:

3. INSIDE TOOL RADIUS .02 MAX
4. BREAK SHARP EDGES .01 MAX
5. 63 FAO

Title: Bearing Mount | Drwn. By: ANTONY CHEN

Dwg. #: 116000 | Date:2/4/2026 | Scale: 2:3 | Chkd. By: Antony Chen
