AntonyC03S/NASA_RASC-AL/(commit log)

2026-01-27 3D Printed Stuffffff
    [Stove Knob.SLDPRT, Stove Knob.STL]
2026-01-28 Storage Rover Folder
    [Sample Tray v2 (1).SLDPRT]
2026-01-29 Added collection drill
    [Assem2.SLDASM, Copy of Part9^Assem2.SLDPRT, Drill Assembly.SLDASM, Part 1.SLDPRT, Part6^Assembly 2.SLDPRT, Part8^Assembly 2.SLDPRT]
2026-01-30 Collection Rover Updates
    [Collection Rover Assembly.SLDASM, Rover body.SLDPRT, Transfer mechanism assembly.SLDASM]
2026-01-30 StorageRover
    Still working on the body of the storage rover but here is the general size
    [MMRTG.SLDPRT, Sample Tray v2 (1).SLDPRT, SampleTray.SLDPRT, StorageRoverBody.SLDPRT, Wheel.sldprt]
2026-01-30 Handling arm updates
    [Bearing.SLDPRT, Collection Rover Assembly.SLDASM, Rover body.SLDPRT, Sample Handling Arm.SLDASM, Segment 1.SLDPRT, Segment 2.SLDPRT]
2026-01-30 Storage
    Storage Rover body and electronics box assembly started.
    [ElectronicBlackBox.SLDPRT, MMRTG.SLDPRT, StorageRoverAssem.SLDASM, StorageRoverBody.SLDPRT]
2026-02-02 StorageRover Updated
    [ControlArm.SLDPRT, ElectronicBlackBox.SLDPRT, MMRTG.SLDPRT, StorageRoverAssem.SLDASM, StorageRoverBody.SLDPRT, WheelConnection.SLDPRT]
2026-02-02 StorageRover again
    [E67 ECU.SLDPRT, StorageRoverAssem.SLDASM, StorageRoverBody.SLDPRT, SuspensionSleeve.SLDPRT]
2026-02-02 Elevator and Arm Added
    [1st Arm.SLDPRT, 1st Bot Bearing.SLDPRT, 1st Top Bearing.SLDPRT, 2464K64_Clamping Precision Flexible Shaft Coupling.SLDPRT, 2nd Arm.SLDPRT, 2nd Top Bearing.SLDPRT, 3rd Arm.SLDPRT, 3rd Top Bearing.SLDPRT]
2026-02-04 Updated Materials
    [ControlArm.SLDPRT, ElectronicBlackBox.SLDPRT, GarageDoor.SLDPRT, StorageRoverBody.SLDPRT, SuspensionSleeve.SLDPRT]
2026-02-05 Vp added
    [Arms.SLDASM, Collection Rover Body.SLDPRT, Collection Rover.SLDASM, MirrorCage.SLDPRT, StorageRoverAssem.SLDASM, shelf plate.SLDPRT, shelf wall.SLDPRT]
2026-02-05 Added VP elevator
    [37d-gearmotor-100-131-150-encoder.SLDPRT, 6061K43_Linear Motion Shaft.SLDPRT, 6673K13_High-Speed Linear Sleeve Bearing.SLDPRT, 9968K24_External Retaining Ring.SLDPRT, Bearing Arm Mount.SLDPRT, Bearing Mount.SLDPRT, Clamp.SLDPRT, Collection Rover.SLDASM]
2026-02-05 Some drawing
    [Bearing Arm Mount.SLDPRT, Bearing Mount.SLDPRT, Clamp.SLDPRT, Collection Rover.SLDASM, Collection Rover.SLDDRW, Rails Bottom Mount.SLDPRT, Rails Top Mount.SLDPRT, Spool.SLDDRW]
2026-02-05 Added Drawings
    [Bearing Arm Mount.SLDDRW, Bearing Mount.SLDDRW, Clamp.SLDDRW, Collection Rover Body.SLDDRW, Rails Bottom Mount..SLDDRW, Rails Bottom Mount.SLDDRW, Rails Top Mount.SLDDRW, Spool.SLDDRW]
2026-02-05 Finished Handling Arm
    [Collection Rover Assembly.SLDASM, End Effector.SLDPRT, Sample Handling Arm.SLDASM, Segment 1.SLDPRT, Segment 2.SLDPRT]
2026-02-10 Update Telescopic arm
    [6673K37_High-Speed Sleeve Linear Bearing.SLDPRT, 9968K32_External Retaining Ring.SLDPRT, Bearing Arm Mount.SLDPRT, Bearing Mount.SLDPRT, Collection Rover Body.SLDPRT, Collection Rover.SLDASM, MirrorBearing Mount.SLDPRT, Rail Telescopic.SLDPRT]
2026-02-10 Added Radiator and Thermal Insulation
    [ElectronicBlackBox.SLDPRT, SuspensionSleeve.SLDPRT, ThermalInsulation.SLDPRT, ThermalRadiator.SLDPRT]
2026-02-10 collection updates
    [Bit Carousel.SLDPRT, BottomloadedTray.SLDPRT, CameraSystem.sldprt, Collection Rover Assembly.SLDASM, Drill Assembly.SLDASM, Drill Head.SLDPRT, DrillArm.SLDPRT, End Effector.SLDPRT]
2026-02-10 Finished collection rover
    [BottomloadedTray.SLDPRT, Collection Rover Assembly.SLDASM, MMRTG.SLDPRT, Rover body.SLDPRT, Sample Handling Arm.SLDASM, SuspensionSleeve.SLDPRT, WheelConnection.SLDPRT]
2026-02-10 Update Collection Rover Assembly.SLDASM
    [Collection Rover Assembly.SLDASM]
2026-02-12 collection dock protrusion
    [Collection Rover Assembly.SLDASM, Rover body.SLDPRT, Sample Handling Arm.SLDASM]
2026-02-20 Mating Interface Closer Together
    [Collection Rover Assembly.SLDASM, Rover body.SLDPRT, StorageRoverBody.SLDPRT]
2026-02-23 MotionStudy
    Mating motion of 2 rovers
    [Collection Rover Assembly.SLDASM]
2026-02-23 Updated for camera shots
    [Collection Rover Assembly.SLDASM, Elevator.SLDASM, LinearActuator.SLDPRT, Rover body.SLDPRT, StorageRoverBody.SLDPRT, TransferMechanism.SLDASM]
2026-02-23 5Rover Graphic
    Needed a graphic with multiple collection rovers and one silo rover
    [Collection Rover Assembly.SLDASM, Sample Handling Arm.SLDASM]
2026-05-07 Updated cad and code
    [1102A14_Steel Base-Mount Drawer Slides-1.SLDPRT, 1102A14_Steel Base-Mount Drawer Slides-2.SLDPRT, Backing Telescopic.SLDPRT, Bearing Arm Mount.SLDPRT, Bearing Mount.SLDPRT, Collection Rover.SLDASM, Drawer Slides.SLDASM, MirrorBearing Mount.SLDPRT]
2026-05-18 CAD Files updated
    [Bearing Mount.SLDPRT, Collection Rover.SLDASM, Drawer Slides.SLDASM, MirrorBearing Mount.SLDPRT, Mirrorpulley support.SLDPRT, Spool.SLDPRT, Stage Telescopic clamp.SLDPRT, Stage Telescopic mid back.SLDPRT]
2026-05-27 Imported Code and update CAD
    [Bearing Arm Mount.SLDPRT, Bearing Mount.SLDPRT, Drawer Slides.SLDASM, MirrorBearing Mount.SLDPRT, Mirrorpulley support.SLDPRT, Spool v3.1.SLDPRT, Spool v3.SLDPRT, Stage Telescopic Top back 2.SLDPRT]
2026-05-28 fixed motor up
